Soda-DENGIKEN/Ritsumori-cup2026/others/スケジュール.pptx

スケジュール | 1月 | 2月 | 3月 | 4月 | 5月 | 6月
基板設計
機体設計
プログラム

データ作成

基板発注

調整

データ作成

組み立て

動作チェック

プログラム勉強

調整

プログラム作成

調整

## Slide 2

スケジュール | 1月 | 2月 | 3月 | 4月 | 5月 | 6月 | 7月 | 8月
基板設計
機体設計
プログラム

データ作成

基板発注

調整

データ作成

動作チェック

組み立て

プログラム勉強

調整

プログラム作成

調整

## Slide 3

スケジュール | 9月 | 10月 | 11月
基板設計
機体設計
プログラム

データ
作成

基板発注

調整

データ
作成

組み立て

動作チェック

プログラム
作成

調整

調整

## Slide 4

スケジュール | 11月 | 12月 | 1月
基板設計
機体設計
プログラム

データ作成

基板発注

調整

データ
作成

組み立て

動作チェック

プログラム作成

調整

調整
