Soda-DENGIKEN/Ritsumori-cup2026/Mechanical Design/others/rcj_mirror_d46mm_h49mm.csv

半征Emm) | 高さ(mm)
0 | 22
0.23 | 22.002 | 0.002
0.46 | 22.006 | 0.004
0.69 | 22.014 | 0.008
0.92 | 22.024 | 0.01
1.15 | 22.038 | 0.014
1.38 | 22.055 | 0.017
1.61 | 22.075 | 0.02
1.84 | 22.098 | 0.023
2.07 | 22.124 | 0.026
2.3 | 22.152 | 0.028
2.53 | 22.184 | 0.032
2.76 | 22.219 | 0.035
2.99 | 22.257 | 0.038
3.22 | 22.298 | 0.041
3.45 | 22.342 | 0.044
3.68 | 22.388 | 0.046
3.91 | 22.438 | 0.05
4.14 | 22.49 | 0.052
4.37 | 22.546 | 0.056
4.6 | 22.604 | 0.058
4.83 | 22.665 | 0.061
5.06 | 22.728 | 0.063
5.29 | 22.795 | 0.067
5.52 | 22.864 | 0.069
5.75 | 22.936 | 0.072
5.98 | 23.011 | 0.075
6.21 | 23.088 | 0.077
6.44 | 23.168 | 0.08
6.67 | 23.251 | 0.083
6.9 | 23.336 | 0.085
7.13 | 23.424 | 0.088
7.36 | 23.514 | 0.09
7.59 | 23.607 | 0.093
7.82 | 23.703 | 0.096
8.05 | 23.8 | 0.097
8.28 | 23.901 | 0.101
8.51 | 24.003 | 0.102
8.74 | 24.108 | 0.105
8.97 | 24.215 | 0.107
9.2 | 24.325 | 0.11
9.43 | 24.437 | 0.112
9.66 | 24.551 | 0.114
9.89 | 24.667 | 0.116
10.12 | 24.785 | 0.118
10.35 | 24.906 | 0.121
10.58 | 25.029 | 0.123
10.81 | 25.153 | 0.124
11.04 | 25.28 | 0.127
11.27 | 25.409 | 0.129
11.5 | 25.54 | 0.131
11.73 | 25.673 | 0.133
11.96 | 25.807 | 0.134
12.19 | 25.944 | 0.137
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
