Soda-DENGIKEN/Ritsumori-cup2026/others/写真/All_2026-Feb-05_08-16-54AM-000_CustomizedView10992556206.png

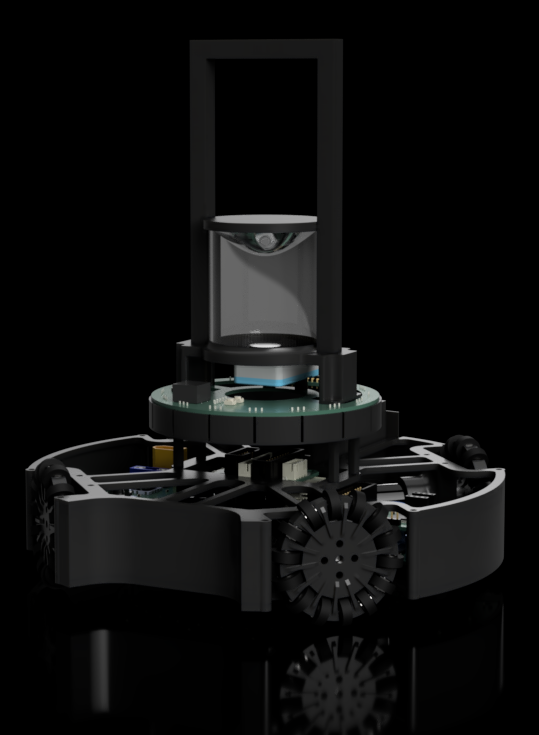
others/写真/All_2026-Feb-05_08-16-54AM-000_CustomizedView10992556206.png
