Soda-DENGIKEN/Ritsumori-cup2026/others/写真/スクリーンショット 2026-02-05 182419.png

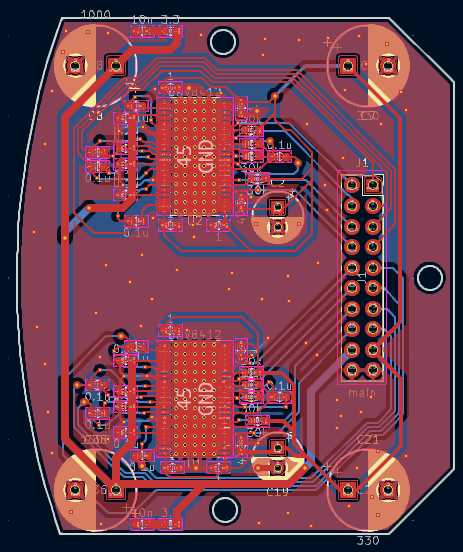
others/写真/スクリーンショット 2026-02-05 182419.png
