Soda-DENGIKEN/Ritsumori-cup2026/Substrate/Motor driver board_1.0/jlcpcb/production_files/BOM-Motor driver board_1.0.csv

Comment | Designator | Footprint | LCSC | Quantity
0.1u | C10,C11,C12,C13,C14,C15,C16,C21,C22,C23,C24,C25,C26,C27,C28,C29,C3,C30,C31,C32,C33,C34,C4,C5,C6,C7,C8,C9 | C_0603_1608Metric | C14663 | 28
1 | R10,R4 | R_0603_1608Metric | C22936 | 2
10k | R3,R9 | R_0603_1608Metric | C25804 | 2
10nF | C17,C35 | C_0603_1608Metric | C57112 | 2
3.3 | R12,R6 | R_0603_1608Metric | C22979 | 2
30k | R1,R11,R2,R5,R7,R8 | R_0603_1608Metric | C22984 | 6
DRV8412DDWR | IC1,IC2 | HTSSOP-44-1EP_6.1x14mm_P0.635mm_EP5.2x14mm_Mask4.31x8.26mm | C79852 | 2
