Soda-DENGIKEN/Ritsumori-cup2026/Mechanical Design/3mf file/Handle②.3mf

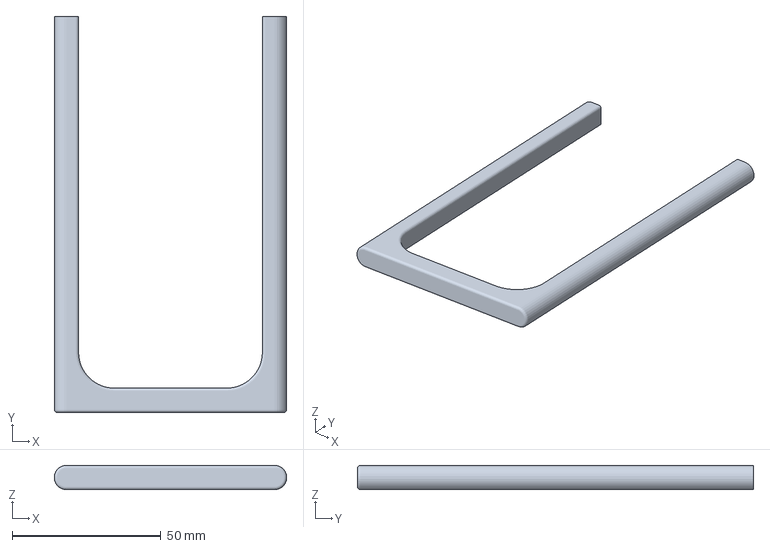
[picture p37: CAD file, 2026-06-11]
Mechanical Design/3mf file/Handle②.3mf
78.2 x 133.2 x 8.20 mm
