Soda-DENGIKEN/Ritsumori-cup2026/Mechanical Design/step file/maxon motor 110322_GP16A_0_15NM_2ST_SL.stp

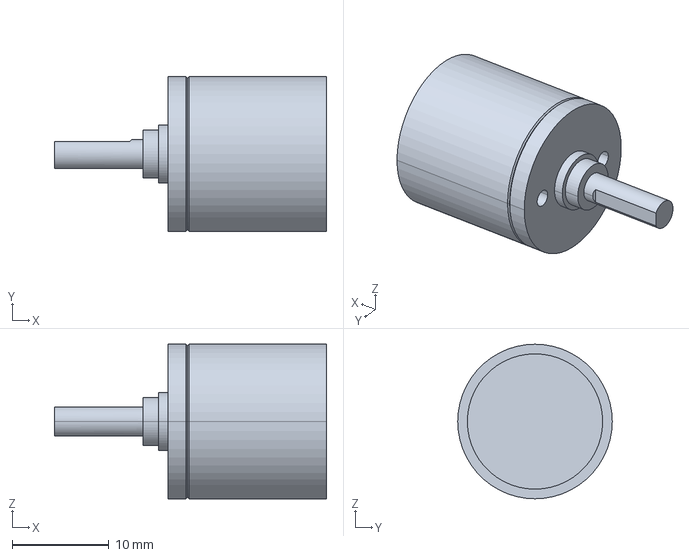
[picture p38: CAD file, 2026-04-30]
Mechanical Design/step file/maxon motor 110322_GP16A_0_15NM_2ST_SL.stp
28.1 x 16.0 x 16.0 mm
