Soda-DENGIKEN/Ritsumori-cup2026/Substrate/Angel_Line_1.0/Angel_Line.step

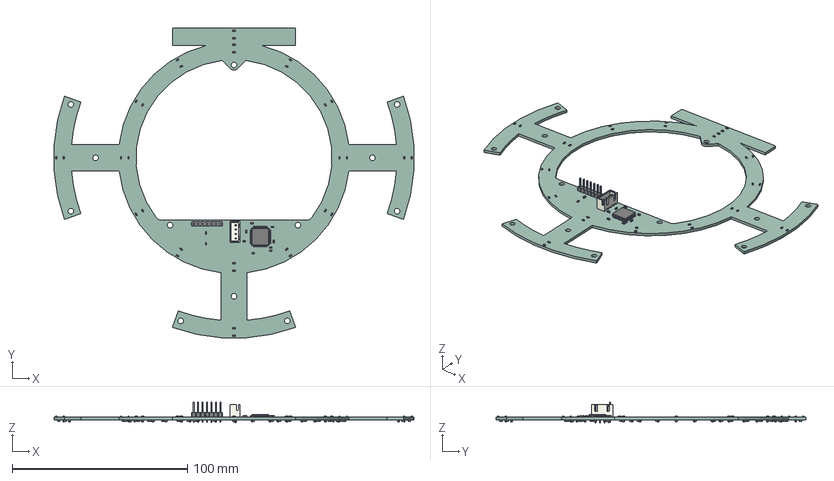
[picture p39: CAD file, 2026-04-30]
Substrate/Angel_Line_1.0/Angel_Line.step
205.5 x 176.7 x 11.9 mm
R_0603_1608Metric x 33
C_0603_1608Metric x 9
PinHeader_1x07_P254mm_Vertical
LQFP_64_10x10mm_P05mm
JST_B4B_XH_A
ASSEMBLY x 48
LED_0603_1608Metric x 48
Angel_Line_1.0_PCB
