Soda-DENGIKEN/Ritsumori-cup2026/Substrate/boost board_1.0/部品/LM2577S-ADJ_NOPB/LM2577S-ADJ_NOPB/3D/LM2577S-ADJ_NOPB.stp

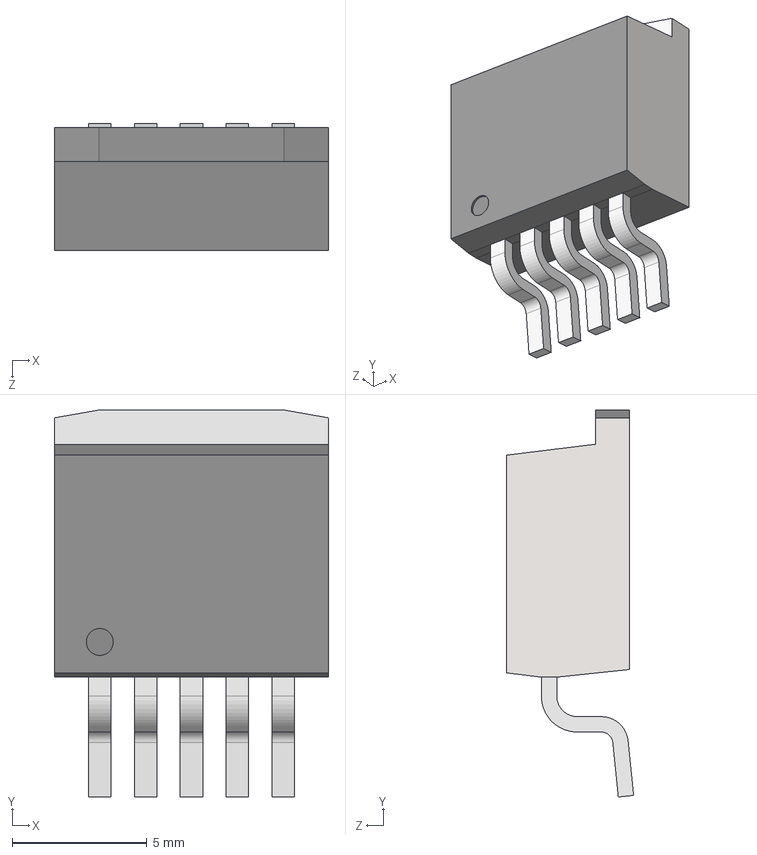
[picture p40: CAD file, 2026-04-27]
Substrate/boost board_1.0/部品/LM2577S-ADJ_NOPB/LM2577S-ADJ_NOPB/3D/LM2577S-ADJ_NOPB.stp
10.2 x 14.3 x 4.72 mm
