Soda-DENGIKEN/Ritsumori-cup2026/Substrate/boost board_1.0/部品/PVZ3A104C01R00/PVZ3A104C01R00/3D/PVZ3A104C01R00.stp

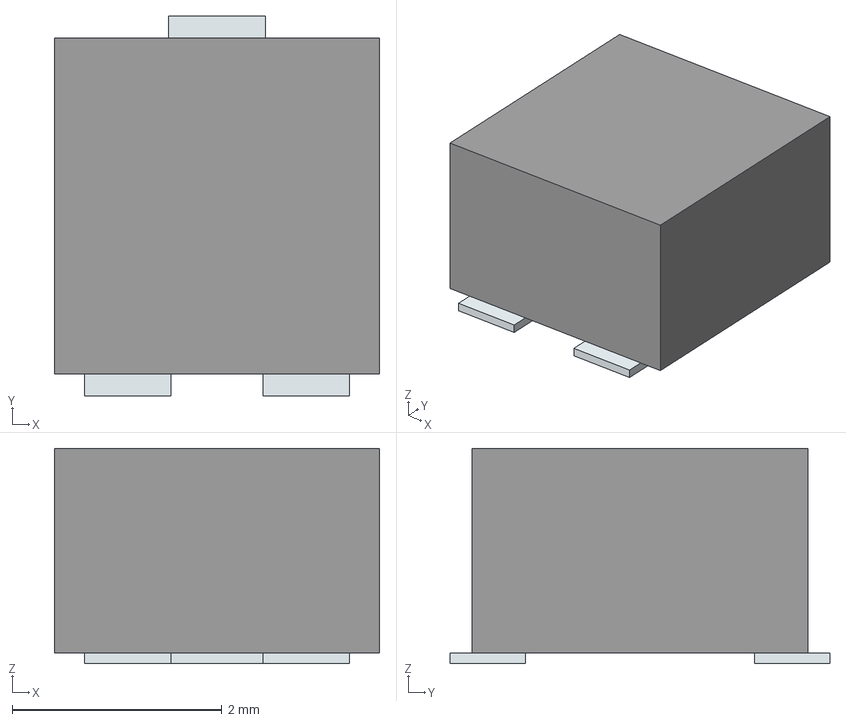
[picture p41: CAD file, 2026-04-27]
Substrate/boost board_1.0/部品/PVZ3A104C01R00/PVZ3A104C01R00/3D/PVZ3A104C01R00.stp
3.10 x 3.62 x 2.05 mm
Pins
