Soda-DENGIKEN/Ritsumori-cup2026/Substrate/IR board_1.0/IR board.step

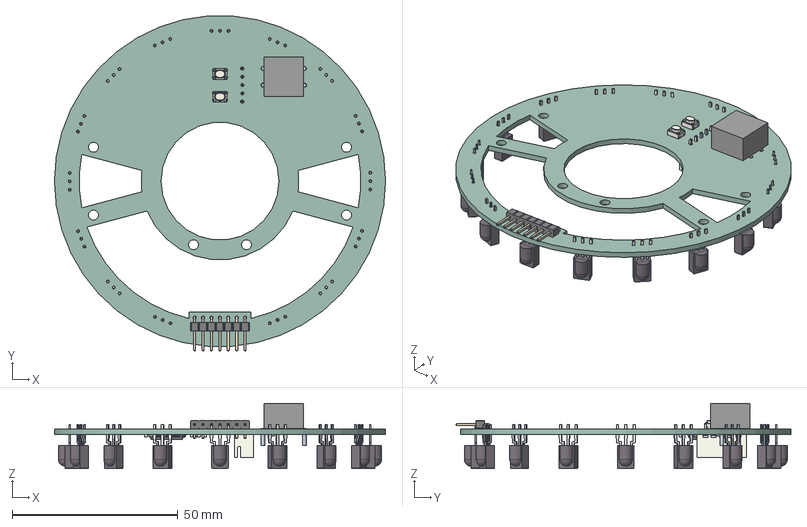
[picture p42: CAD file, 2026-04-30]
Substrate/IR board_1.0/IR board.step
100.0 x 101.2 x 19.8 mm
PinHeader_1x07_P254mm_Horizontal
SKRPAB x 2
ASSEMBLY
Vishay_MINICAST-3pin x 16
C_0603_1608Metric x 9
R_0603_1608Metric x 2
JST_B5B_XH_A
LQFP_64_10x10mm_P05mm
IR board_1.0_PCB
