Soda-DENGIKEN/Ritsumori-cup2026/Substrate/IR board_1.0/部品/SKRPABE010/SKRPABE010/3D/SKRPABE010.stp

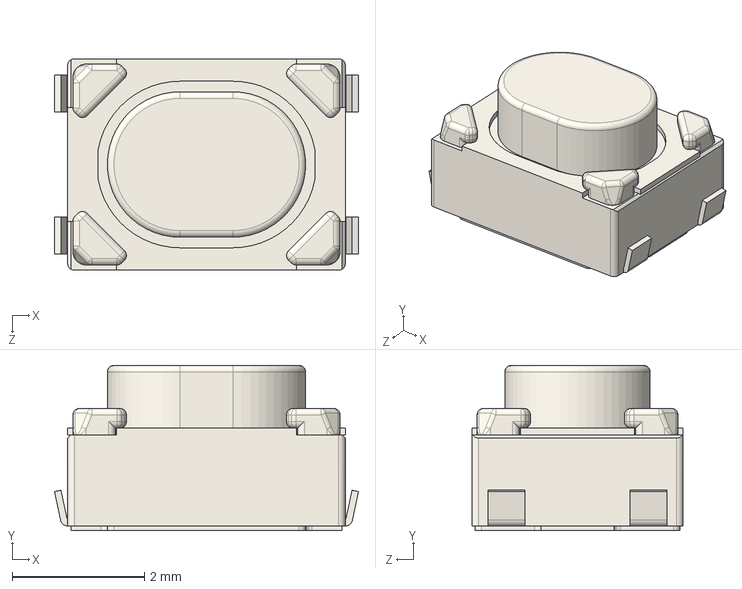
[picture p43: CAD file, 2026-04-30]
Substrate/IR board_1.0/部品/SKRPABE010/SKRPABE010/3D/SKRPABE010.stp
4.60 x 2.50 x 3.20 mm
