Soda-DENGIKEN/Ritsumori-cup2026/Substrate/kicker board_1.0/部品/AQW212/AQW212/3D/AQW212.stp

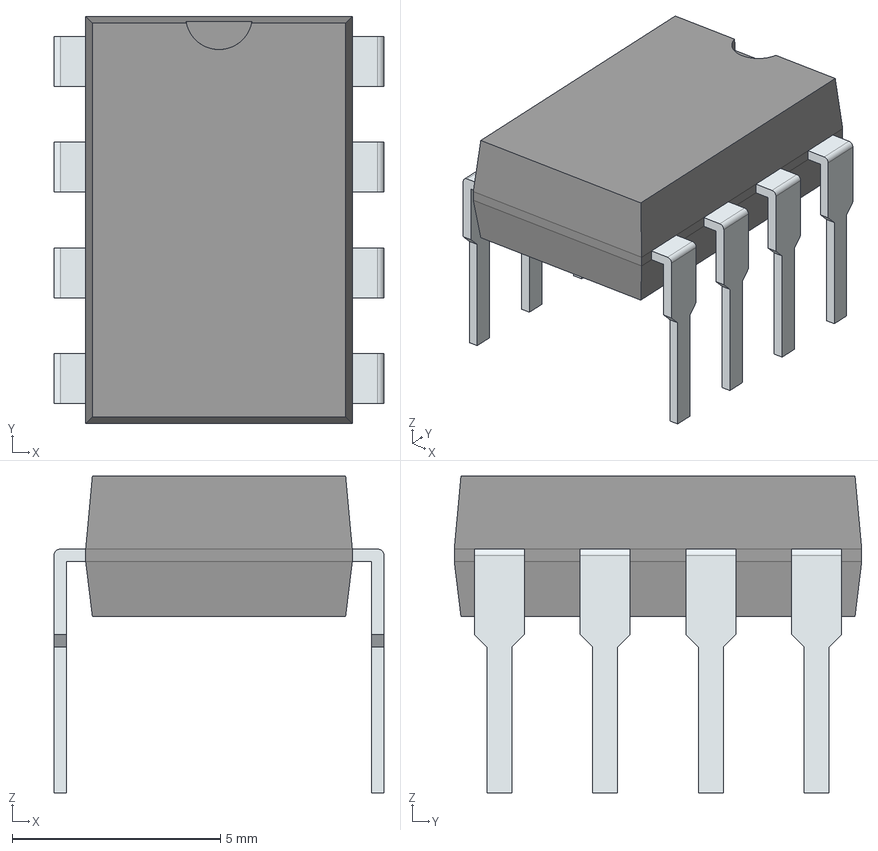
[picture p44: CAD file, 2026-04-27]
Substrate/kicker board_1.0/部品/AQW212/AQW212/3D/AQW212.stp
7.92 x 9.78 x 7.60 mm
PinsArrayLR
