Soda-DENGIKEN/Ritsumori-cup2026/Substrate/kicker board_1.0/部品/TJ8S06M3L/TJ8S06M3L/3D/TJ8S06M3L.stp

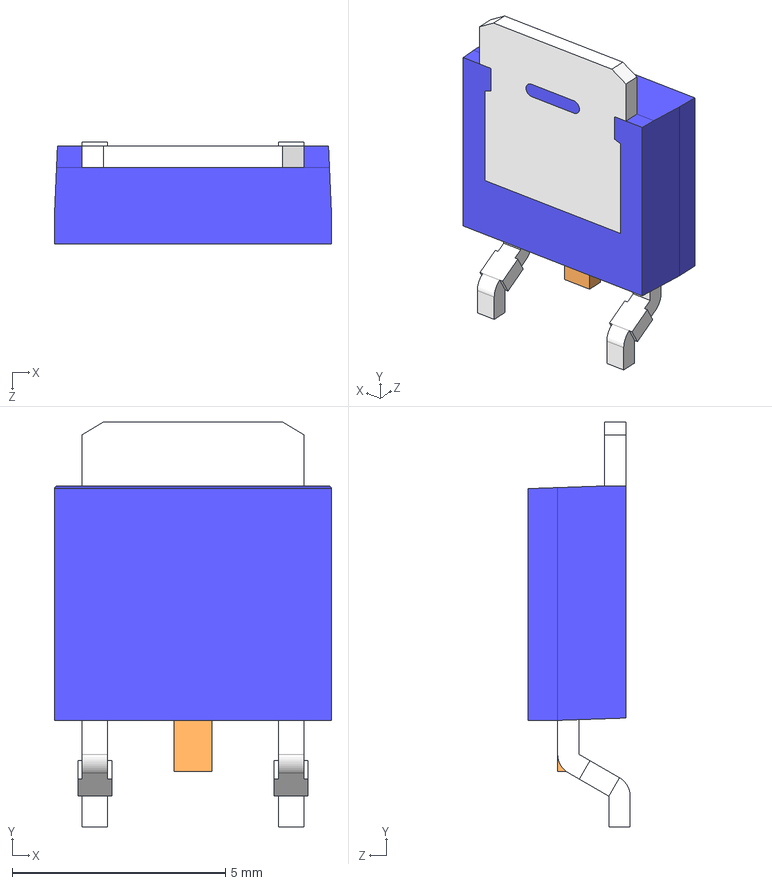
[picture p45: CAD file, 2026-04-27]
Substrate/kicker board_1.0/部品/TJ8S06M3L/TJ8S06M3L/3D/TJ8S06M3L.stp
6.50 x 9.50 x 2.40 mm
