Soda-DENGIKEN/Ritsumori-cup2026/Substrate/Motor driver board_1.0/Motor driver.dxf

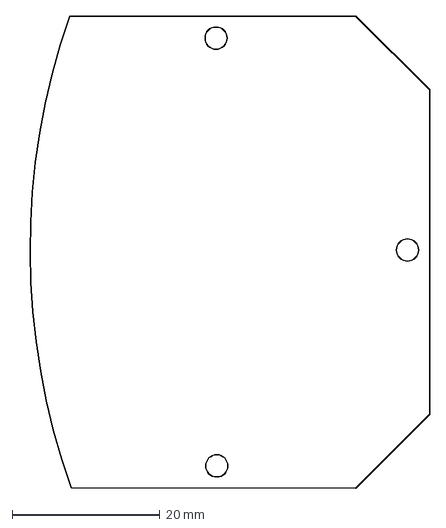
[picture p46: CAD file, 2026-04-30]
Substrate/Motor driver board_1.0/Motor driver.dxf
55.9 x 63.9 mm
