Soda-DENGIKEN/Ritsumori-cup2026/Substrate/Motor driver board_1.0/部品/DRV8432DKDR/DRV8432DKDR/3D/DRV8432DKDR.stp

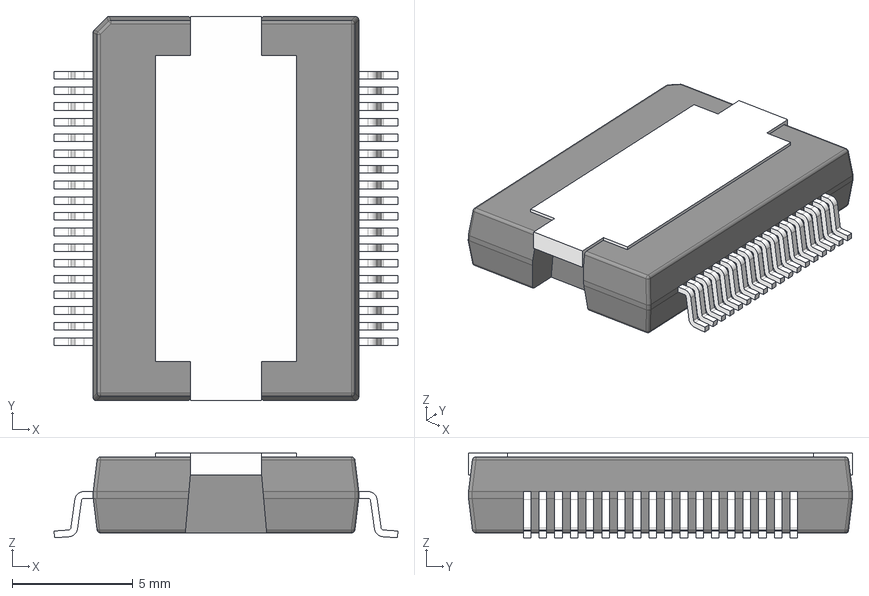
[picture p47: CAD file, 2026-04-30]
Substrate/Motor driver board_1.0/部品/DRV8432DKDR/DRV8432DKDR/3D/DRV8432DKDR.stp
14.2 x 15.9 x 3.50 mm
BODY-SO
LEAD-SO x 36
THERMALPAD-SO
PIN1-ID
