Soda-DENGIKEN/Ritsumori-cup2026/Substrate/power board_1.0/power board.step

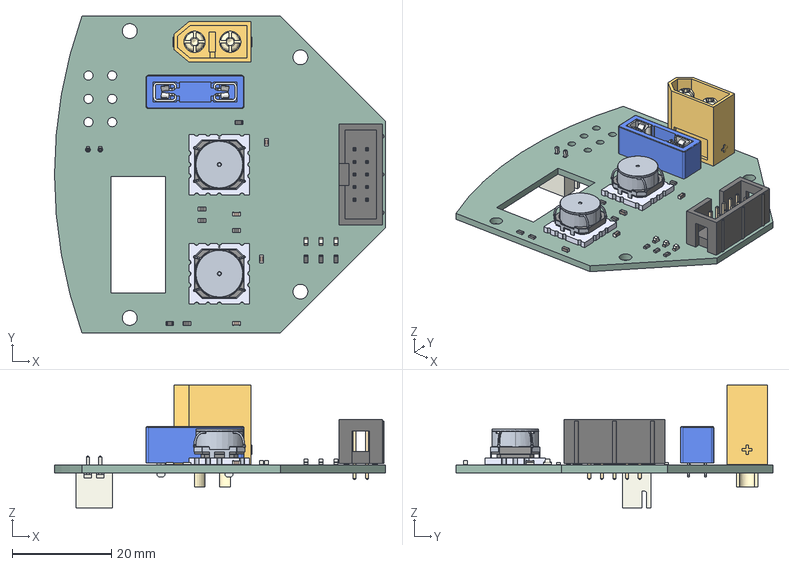
[picture p48: CAD file, 2026-04-27]
Substrate/power board_1.0/power board.step
66.7 x 63.9 x 24.7 mm
R_0603_1608Metric x 9
OKL-T-6-W12N-C x 2
C_0603_1608Metric x 4
LED_0603_1608Metric x 3
XT60 male v9
IDC_Header_2x05_P254mm_Vertical
JST_B2B_XH_A
power board_1.0_PCB
