Soda-DENGIKEN/Ritsumori-cup2026/Substrate/power board_1.0/部品/1N5822-23/1N5822-23/3D/1N5822-23.stp

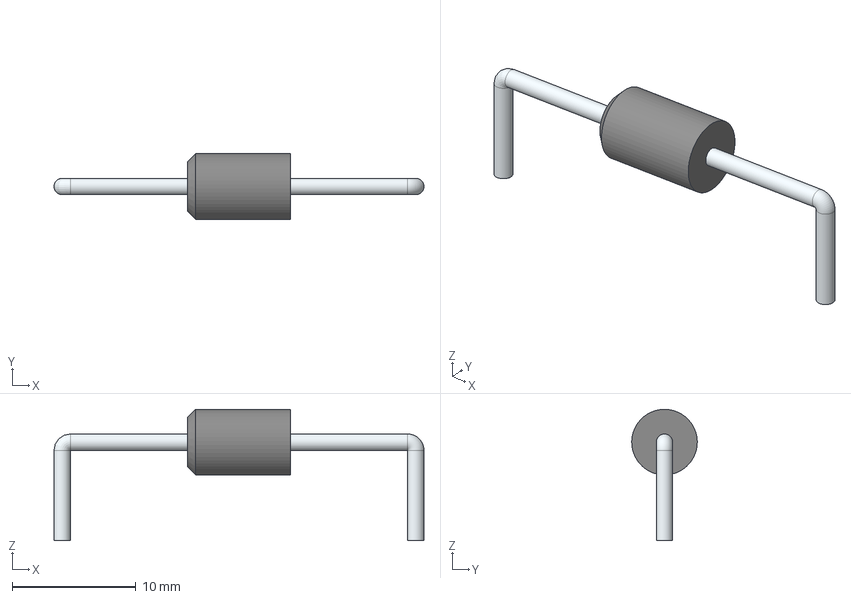
[picture p49: CAD file, 2026-04-27]
Substrate/power board_1.0/部品/1N5822-23/1N5822-23/3D/1N5822-23.stp
29.9 x 5.30 x 10.6 mm
