Soda-DENGIKEN/Ritsumori-cup2026/Substrate/sentral board_1.0/sentral board.step

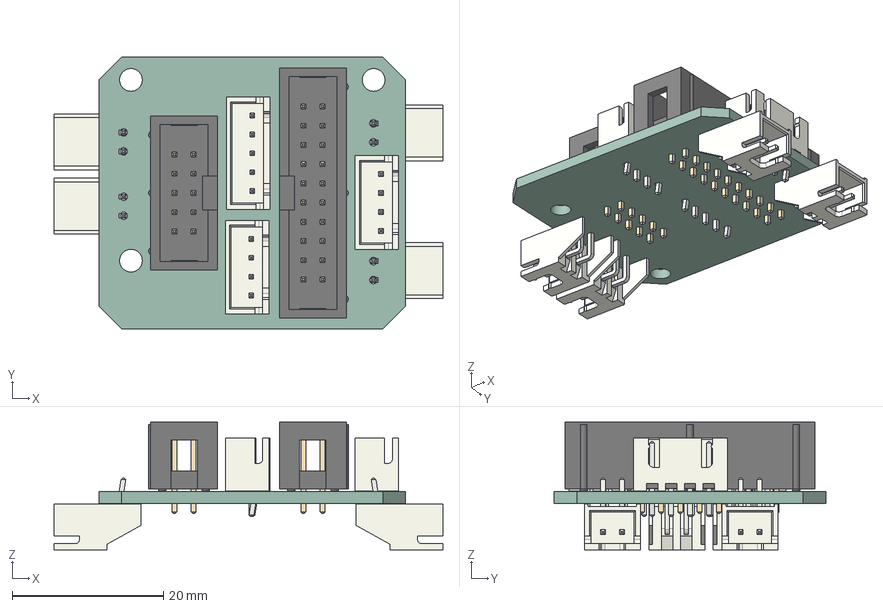
[picture p50: CAD file, 2026-04-27]
Substrate/sentral board_1.0/sentral board.step
51.4 x 35.9 x 16.9 mm
JST_B5B_XH_A
JST_B4B_XH_A x 2
IDC_Header_2x10_P254mm_Vertical
IDC_Header_2x05_P254mm_Vertical
JST_S2B_XH_A x 4
_autosave-sentral board_1.0_PCB
