Soda-DENGIKEN/Ritsumori-cup2026/Mechanical Design/3mf file/Mirror molding jig.3mf

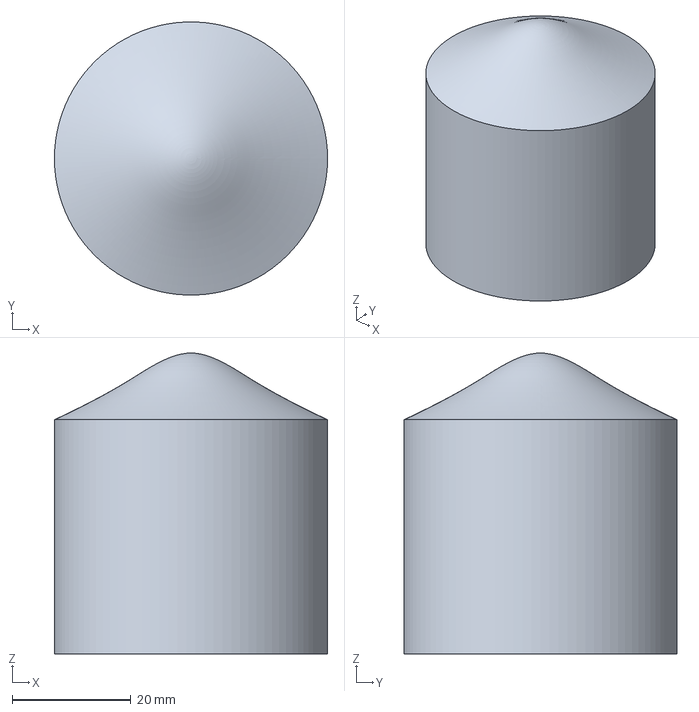
[picture p51: CAD file, 2026-06-07]
Mechanical Design/3mf file/Mirror molding jig.3mf
46.0 x 46.0 x 50.7 mm
