Soda-DENGIKEN/Ritsumori-cup2026/Mechanical Design/step file/maxon motor 118710_RE16_GB_4_5W_SL_1WE.stp

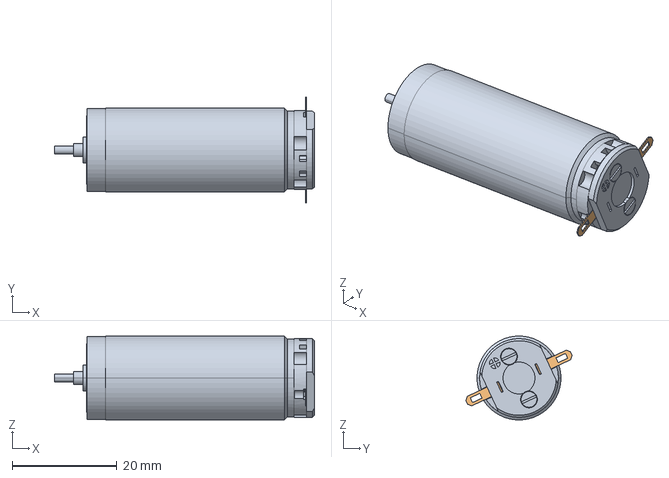
[picture p52: CAD file, 2026-04-30]
Mechanical Design/step file/maxon motor 118710_RE16_GB_4_5W_SL_1WE.stp
49.6 x 20.3 x 16.0 mm
