Soda-DENGIKEN/Ritsumori-cup2026/Mechanical Design/STL file/Subwheel jig②.stl

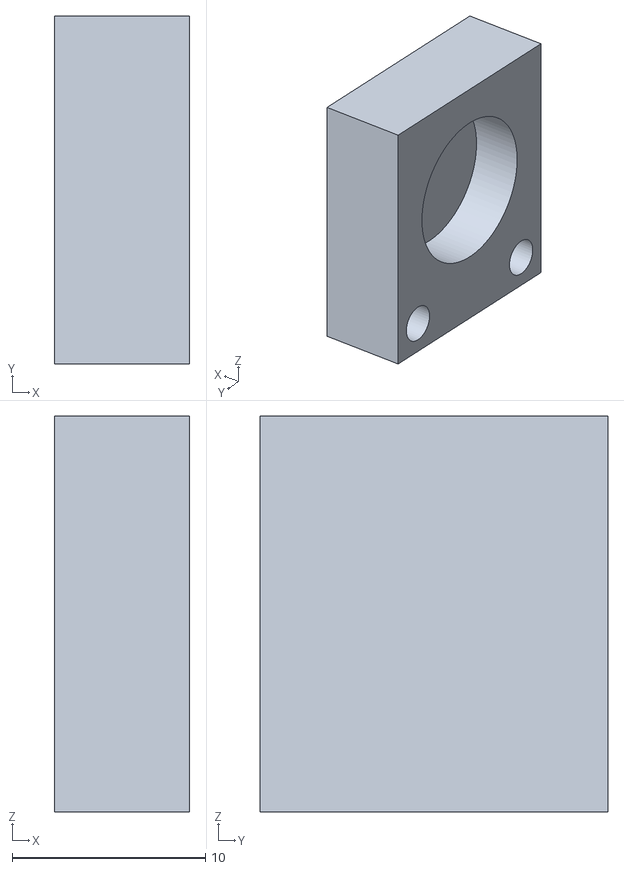
[picture p53: CAD file, 2026-05-09]
Mechanical Design/STL file/Subwheel jig②.stl
7.00 x 18.0 x 20.5
