Soda-DENGIKEN/Ritsumori-cup2026/Substrate/Motor driver board_1.0/Motor driver board_1.0.step

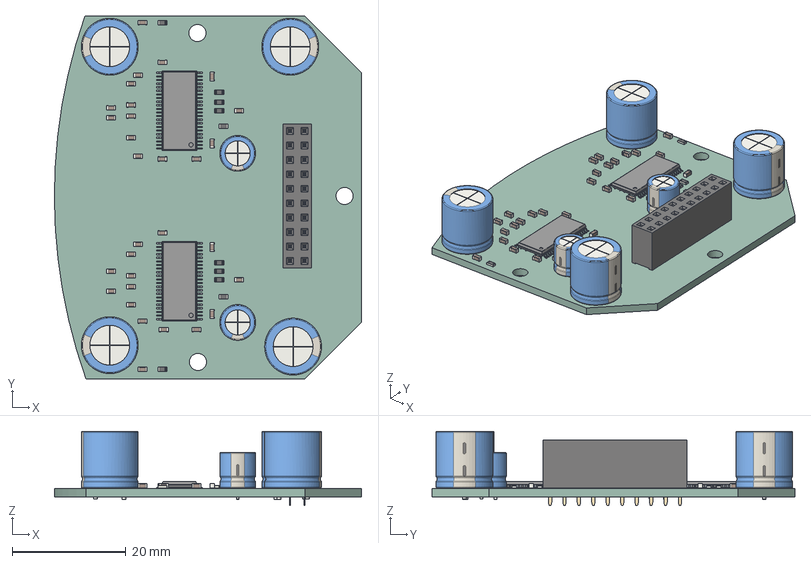
[picture p54: CAD file, 2026-04-30]
Substrate/Motor driver board_1.0/Motor driver board_1.0.step
54.1 x 63.9 x 13.1 mm
C_0603_1608Metric x 30
R_0603_1608Metric x 10
CP_Radial_D6.3mm_P2.50mm x 2
CP_Radial_D10.0mm_P5.00mm x 4
PinsArrayLR x 2
ThermalPad x 2
PinSocket_2x10_P2.54mm_Vertical
Motor driver board_1.0_PCB
