Soda-DENGIKEN/Ritsumori-cup2026/Mechanical Design/3mf file/Camera cover③.3mf

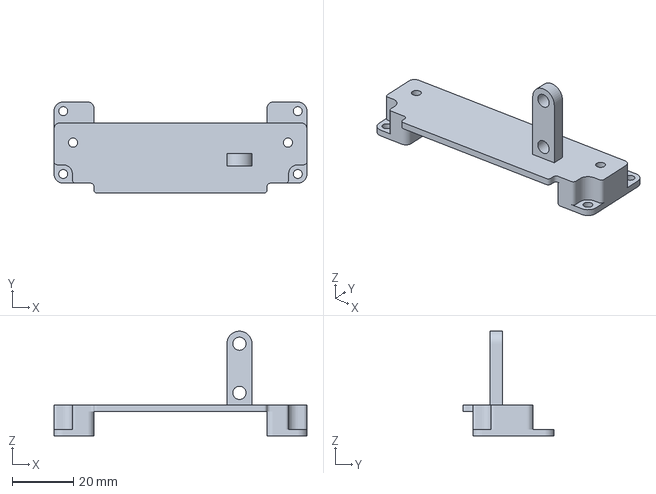
[picture p55: CAD file, 2026-06-07]
Mechanical Design/3mf file/Camera cover③.3mf
82.4 x 29.7 x 34.1 mm
