Soda-DENGIKEN/Ritsumori-cup2026/Mechanical Design/step file/UnitV AI camera m12 lens.step

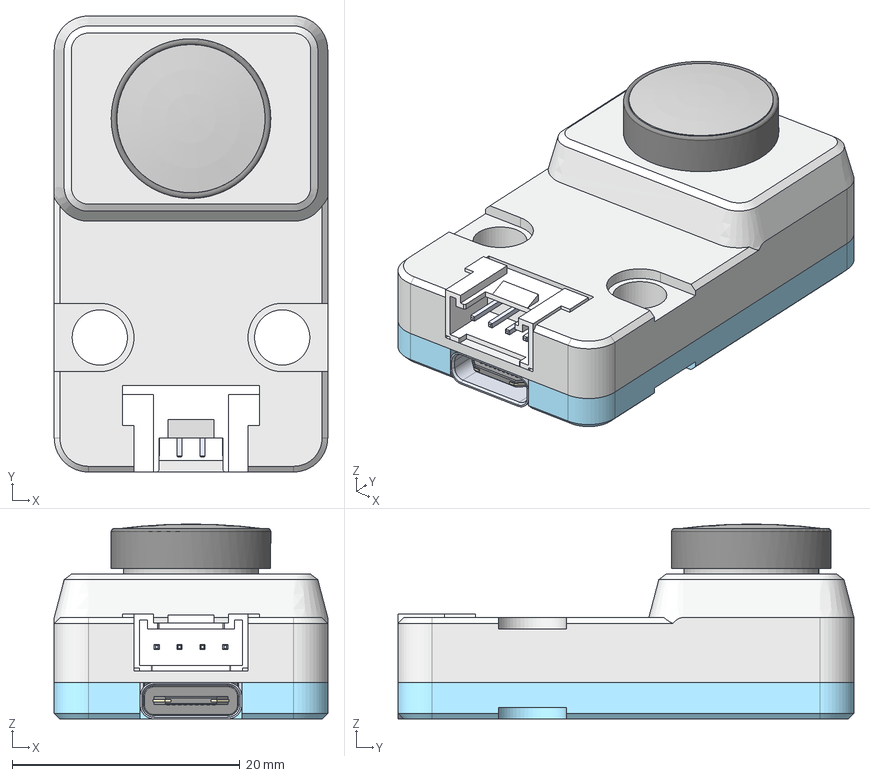
[picture p56: CAD file, 2026-04-30]
Mechanical Design/step file/UnitV AI camera m12 lens.step
24.0 x 40.0 x 17.1 mm
Grove Connector (flat)
197318B7-B3A4-4C4D-8547-E82B1B9616B6
UC-0204
