Soda-DENGIKEN/Ritsumori-cup2026/Mechanical Design/STL file/Subwheel jig①.stl

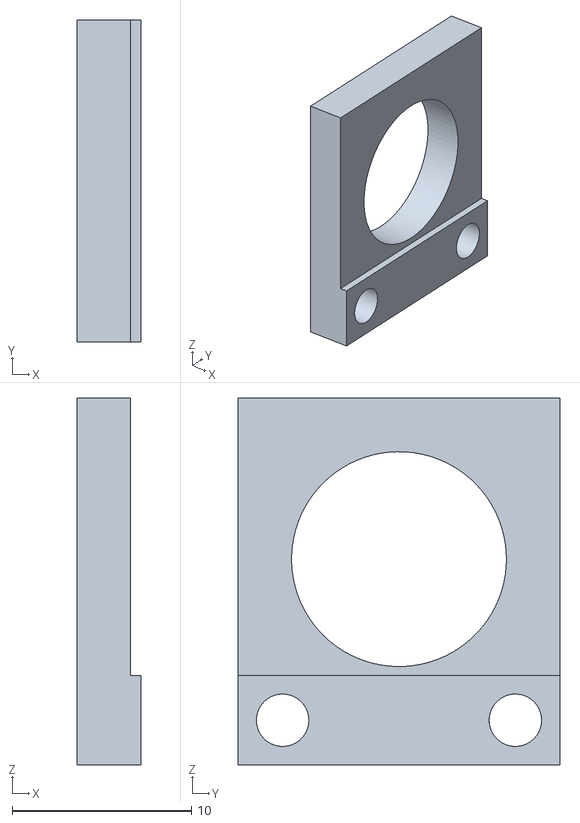
[picture p57: CAD file, 2026-05-09]
Mechanical Design/STL file/Subwheel jig①.stl
3.60 x 18.0 x 20.5
