Soda-DENGIKEN/Ritsumori-cup2026/Mechanical Design/3mf file/Camera cover①.3mf

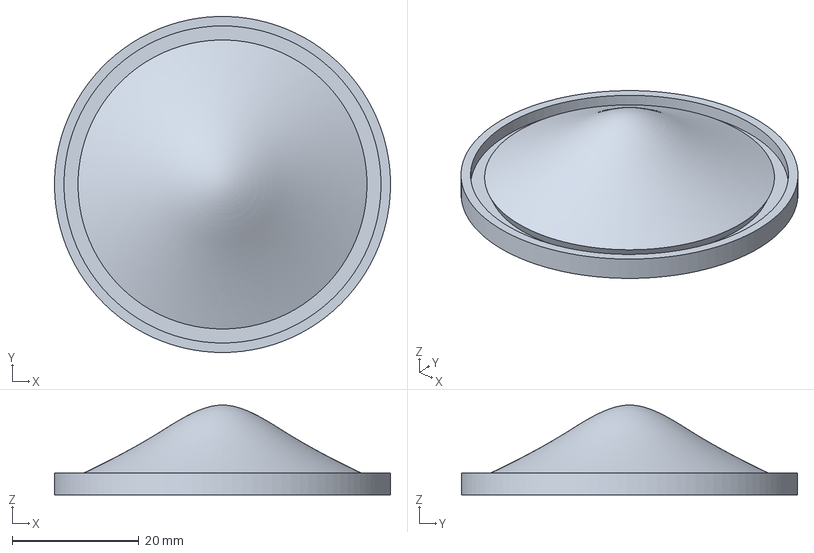
[picture p58: CAD file, 2026-06-07]
Mechanical Design/3mf file/Camera cover①.3mf
53.0 x 53.0 x 14.2 mm
