Soda-DENGIKEN/Ritsumori-cup2026/Mechanical Design/STL file/wall③.stl

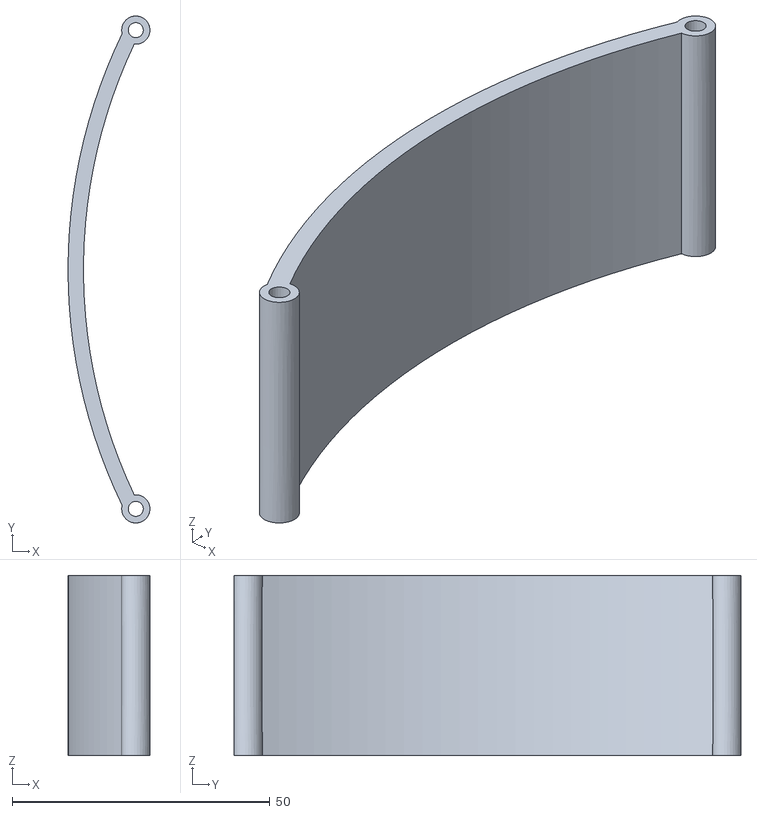
[picture p59: CAD file, 2026-04-30]
Mechanical Design/STL file/wall③.stl
15.9 x 98.4 x 35.0
