Soda-DENGIKEN/Ritsumori-cup2026/Mechanical Design/3mf file/Handle①.3mf

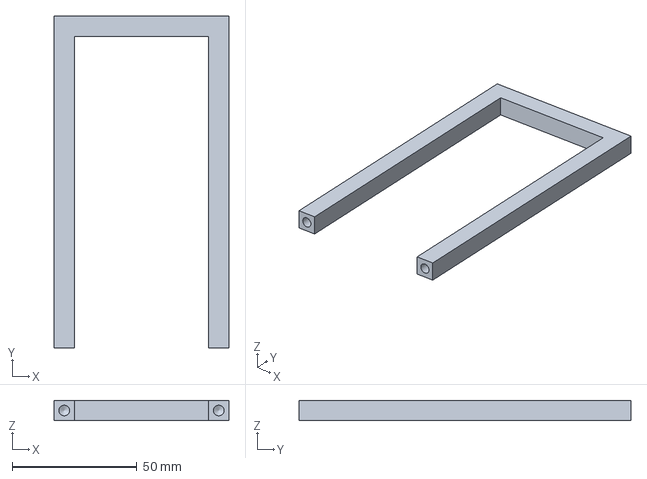
[picture p60: CAD file, 2026-06-07]
Mechanical Design/3mf file/Handle①.3mf
70.2 x 133.2 x 8.20 mm
