Soda-DENGIKEN/Ritsumori-cup2026/Mechanical Design/3mf file/Camera caver②.3mf

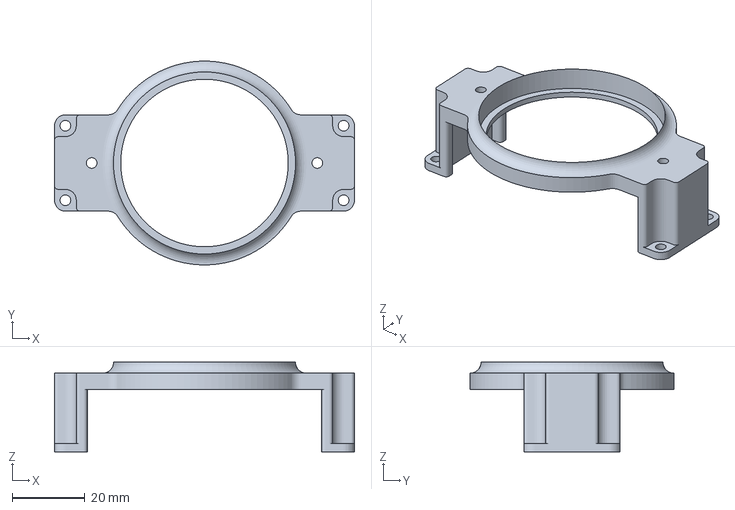
[picture p61: CAD file, 2026-05-31]
Mechanical Design/3mf file/Camera caver②.3mf
82.4 x 56.0 x 24.6 mm
