Soda-DENGIKEN/Ritsumori-cup2026/Mechanical Design/STL file/wall④.stl

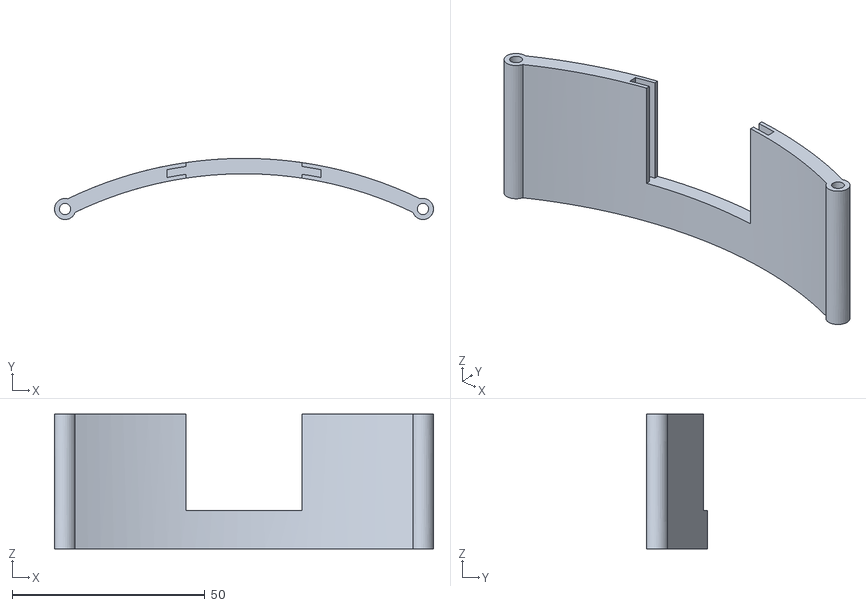
[picture p62: CAD file, 2026-04-30]
Mechanical Design/STL file/wall④.stl
98.4 x 15.9 x 35.0
