Soda-DENGIKEN/Ritsumori-cup2026/Mechanical Design/3mf file/omni frame.3mf

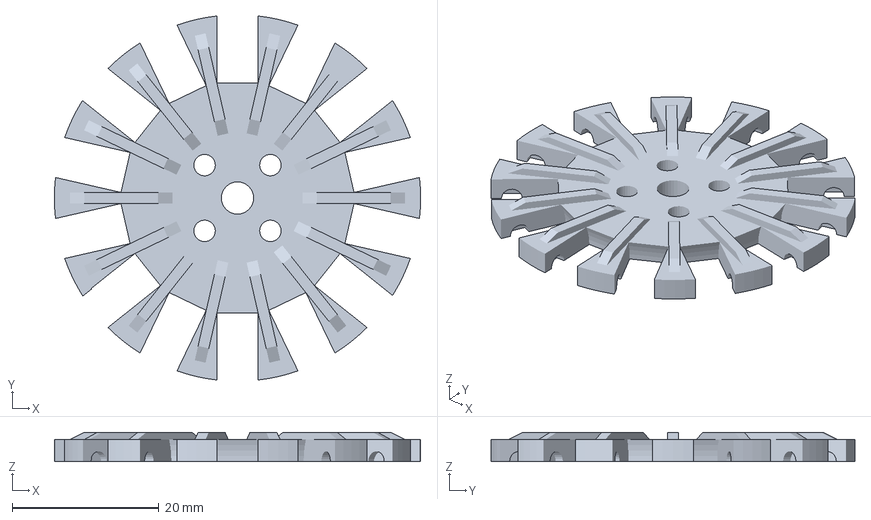
[picture p63: CAD file, 2026-05-26]
Mechanical Design/3mf file/omni frame.3mf
50.0 x 49.7 x 4.00 mm
