Soda-DENGIKEN/Ritsumori-cup2026/Mechanical Design/STL file/wall①.stl

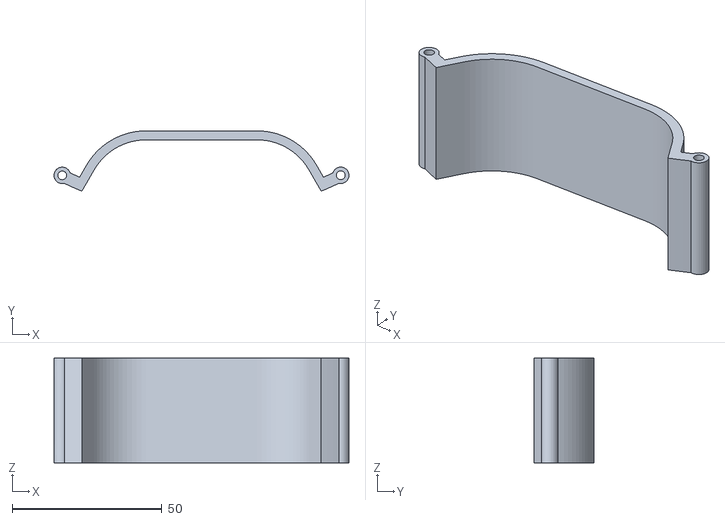
[picture p64: CAD file, 2026-04-30]
Mechanical Design/STL file/wall①.stl
98.3 x 20.1 x 35.0
