Soda-DENGIKEN/Ritsumori-cup2026/Mechanical Design/3mf file/omni frame 8.3mf

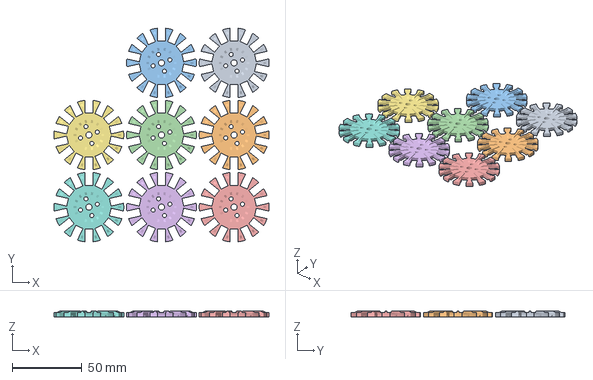
[picture p65: CAD file, 2026-05-26]
Mechanical Design/3mf file/omni frame 8.3mf
154.0 x 153.1 x 4.00 mm
omni frame.stl x 8
