Soda-DENGIKEN/Ritsumori-cup2026/Mechanical Design/3mf file/Subwheel jig.3mf

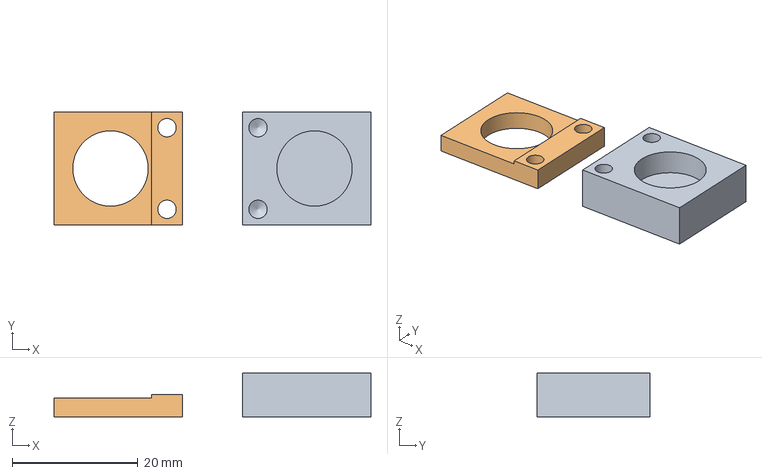
[picture p66: CAD file, 2026-05-09]
Mechanical Design/3mf file/Subwheel jig.3mf
50.5 x 18.0 x 7.00 mm
Subwheel jig②.stl
Subwheel jig①.stl
