Soda-DENGIKEN/Ritsumori-cup2026/Mechanical Design/3mf file/motor cover-Pololu×4.3mf

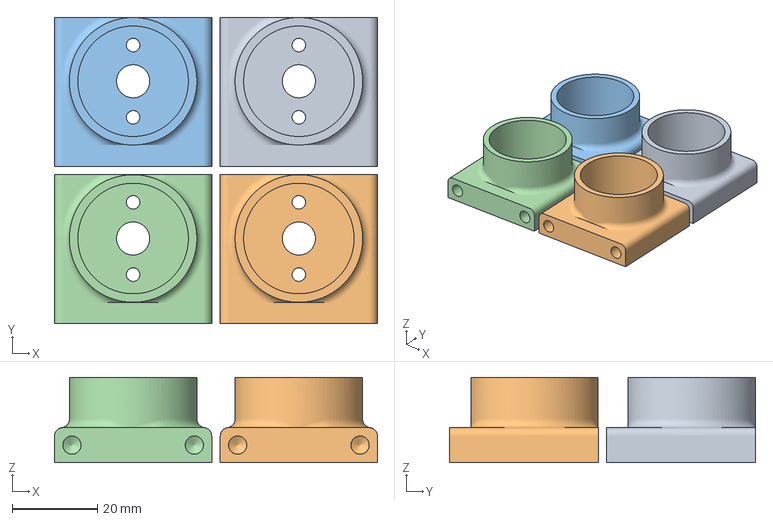
[picture p67: CAD file, 2026-04-30]
Mechanical Design/3mf file/motor cover-Pololu×4.3mf
76.0 x 72.0 x 20.0 mm
motor cover-Pololu.stl x 4
