Soda-DENGIKEN/Ritsumori-cup2026/Mechanical Design/3mf file/top board-Pololu.3mf

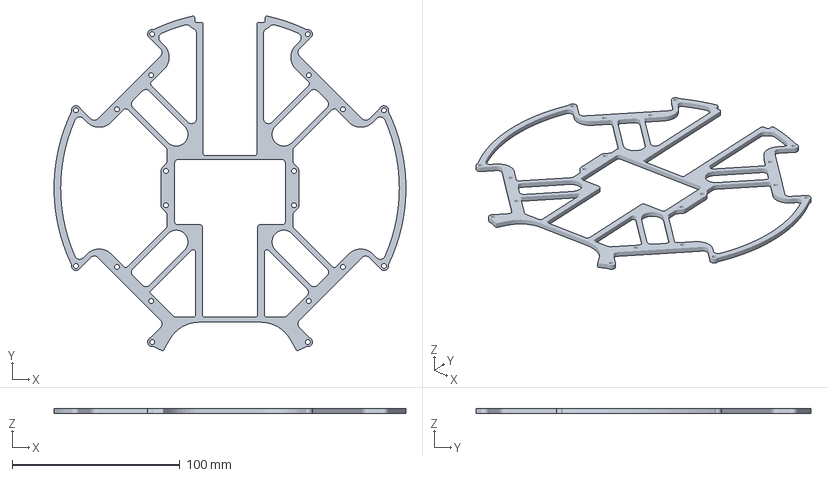
[picture p68: CAD file, 2026-04-30]
Mechanical Design/3mf file/top board-Pololu.3mf
210.0 x 199.8 x 3.00 mm
