Soda-DENGIKEN/Ritsumori-cup2026/Mechanical Design/3mf file/lower board-Pololu.3mf

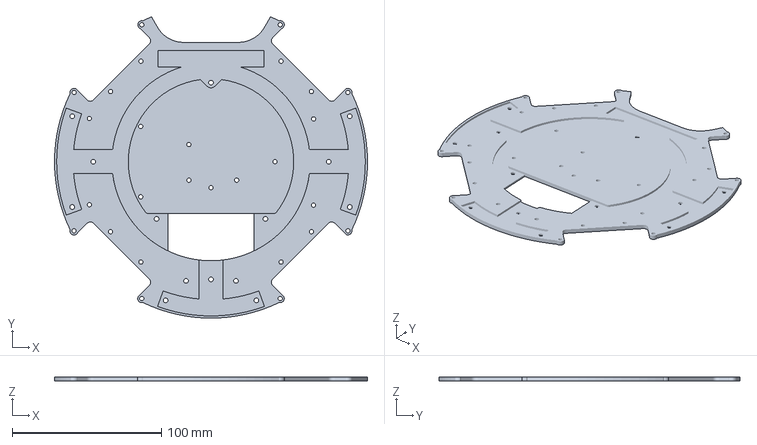
[picture p69: CAD file, 2026-04-30]
Mechanical Design/3mf file/lower board-Pololu.3mf
210.0 x 202.1 x 3.00 mm
