Soda-DENGIKEN/Ritsumori-cup2026/Mechanical Design/3mf file/battery cover.3mf

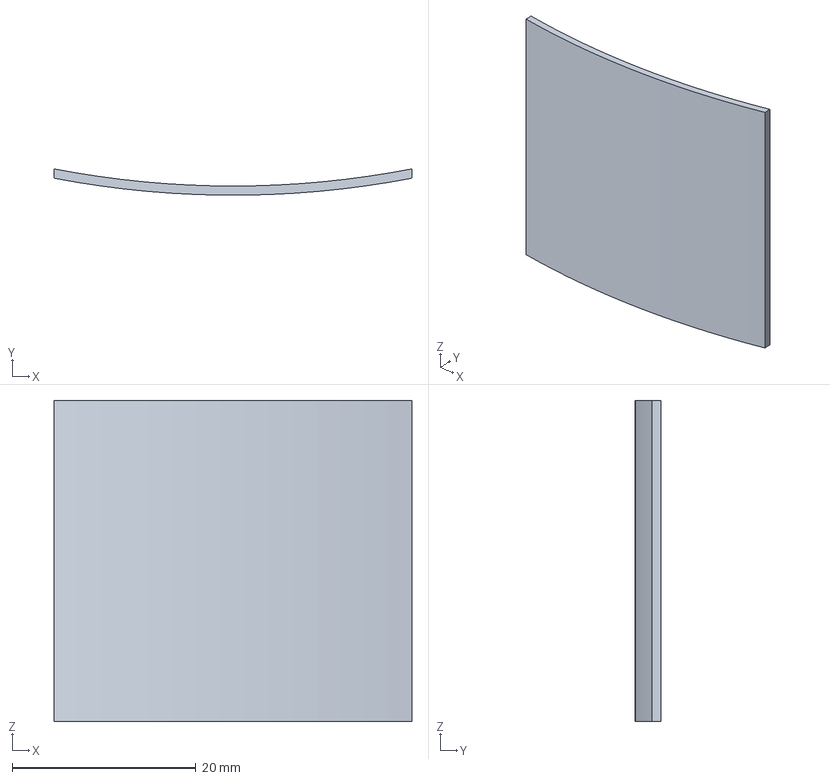
[picture p70: CAD file, 2026-04-30]
Mechanical Design/3mf file/battery cover.3mf
39.0 x 2.86 x 35.0 mm
