Soda-DENGIKEN/Ritsumori-cup2026/Mechanical Design/3mf file/wall.3mf

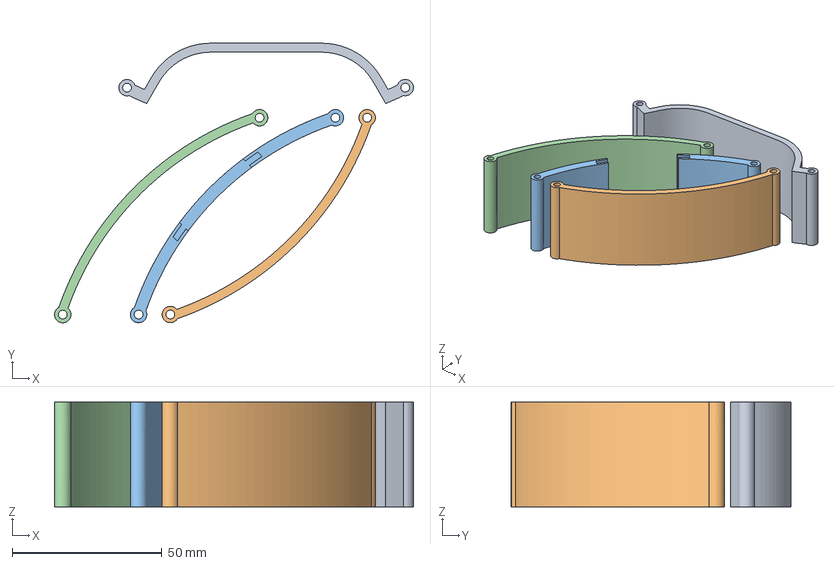
[picture p71: CAD file, 2026-04-30]
Mechanical Design/3mf file/wall.3mf
119.8 x 93.3 x 35.0 mm
wall①.stl
wall③.stl
wall④.stl
wall②.stl
