Soda-DENGIKEN/Ritsumori-cup2026/Mechanical Design/3mf file/IR cover.3mf

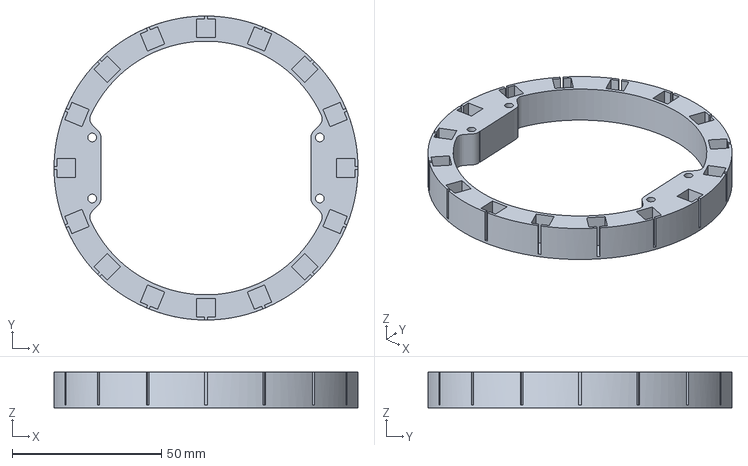
[picture p72: CAD file, 2026-04-30]
Mechanical Design/3mf file/IR cover.3mf
102.0 x 102.0 x 12.0 mm
