Soda-DENGIKEN/Ritsumori-cup2026/Mechanical Design/3mf file/motor cover-Pololu.3mf

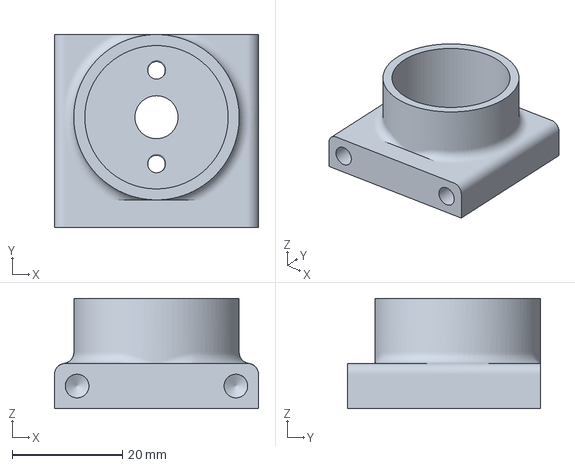
[picture p73: CAD file, 2026-04-30]
Mechanical Design/3mf file/motor cover-Pololu.3mf
37.0 x 35.0 x 20.0 mm
