Soda-DENGIKEN/Ritsumori-cup2026/Mechanical Design/3mf file/battery box-Pololu.3mf

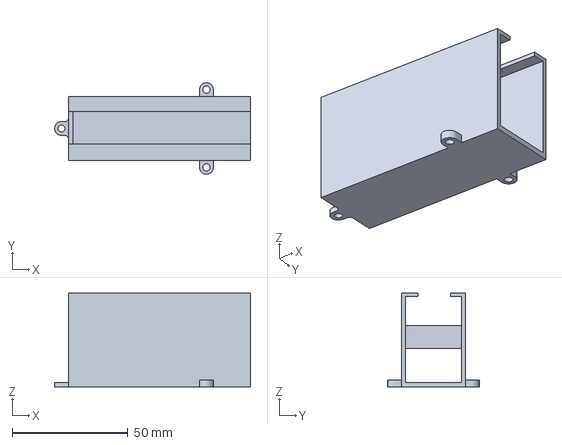
[picture p74: CAD file, 2026-04-30]
Mechanical Design/3mf file/battery box-Pololu.3mf
84.5 x 39.5 x 40.5 mm
