Soda-DENGIKEN/Ritsumori-cup2026/(list of files, cad)

Other CAD files:
Mechanical Design/STL file/wall②.stl
Mechanical Design/3mf file/washer 138.3mf
Mechanical Design/STL file/Camera caver②.stl
Mechanical Design/STL file/Camera cover①.stl
Mechanical Design/STL file/Camera cover③.stl
Mechanical Design/STL file/Handle①.stl
Mechanical Design/STL file/Handle②.stl
Mechanical Design/STL file/IR cover.stl
Mechanical Design/STL file/Mirror molding jig.stl
Mechanical Design/STL file/battery box-Pololu.stl
Mechanical Design/STL file/battery cover.stl
Mechanical Design/STL file/lower board-Pololu.stl
Mechanical Design/STL file/motor cover-Pololu.stl
Mechanical Design/STL file/omni frame.stl
Mechanical Design/STL file/top board-Pololu.stl
Mechanical Design/STL file/washer.stl
Substrate/Angel_Line_1.0/Angel_Line.dxf
Substrate/IR board_1.0/IR board.dxf
Substrate/IR board_1.0/部品/SKRPABE010/SKRPABE010/DEHDL/skrpabe010/chips/chips.prt
Substrate/Motor driver board_1.0/部品/DRV8432DKDR/DRV8432DKDR/Allegro/sop65p1420x360-37n.psm
Substrate/Motor driver board_1.0/部品/DRV8432DKDR/DRV8432DKDR/DEHDL/drv8432dkdr/chips/chips.prt
Substrate/boost board_1.0/部品/LM2577S-ADJ_NOPB/LM2577S-ADJ_NOPB/Allegro/ktt0005b.psm
Substrate/boost board_1.0/部品/LM2577S-ADJ_NOPB/LM2577S-ADJ_NOPB/DEHDL/lm2577s_adj_nopb/chips/chips.prt
Substrate/boost board_1.0/部品/PVZ3A104C01R00/PVZ3A104C01R00/Allegro/pvz3a104c01r00.psm
Substrate/boost board_1.0/部品/PVZ3A104C01R00/PVZ3A104C01R00/DEHDL/pvz3a104c01r00/chips/chips.prt
Substrate/kicker board_1.0/部品/AQW212/AQW212/Allegro/dip762w60p254l978h410q8n.psm
Substrate/kicker board_1.0/部品/AQW212/AQW212/DEHDL/aqw212/chips/chips.prt
Substrate/kicker board_1.0/部品/TJ8S06M3L/TJ8S06M3L/Allegro/tj8s06m3l.psm
Substrate/kicker board_1.0/部品/TJ8S06M3L/TJ8S06M3L/DEHDL/tj8s06m3l/chips/chips.prt
Substrate/power board_1.0/power board.dxf
Substrate/power board_1.0/部品/1N5822-23/1N5822-23/Allegro/dioad2855w132l835d505.psm
Substrate/power board_1.0/部品/1N5822-23/1N5822-23/DEHDL/1n5822_23/chips/chips.prt
Substrate/power board_1.0/部品/LIB_LM2576SX-3.3_NOPB/LM2576SX-3.3_NOPB/Allegro/ktt0005b.psm
Substrate/power board_1.0/部品/LIB_LM2576SX-3.3_NOPB/LM2576SX-3.3_NOPB/DEHDL/lm2576sx_3.3_nopb/chips/chips.prt
Substrate/power board_1.0/部品/LIB_LM2576SX-5.0_NOPB/LM2576SX-5.0_NOPB/Allegro/ktt0005b.psm
Substrate/power board_1.0/部品/LIB_LM2576SX-5.0_NOPB/LM2576SX-5.0_NOPB/DEHDL/lm2576sx_5.0_nopb/chips/chips.prt
Substrate/sentral board_1.0/sentral board.dxf
