Soda-DENGIKEN/Ritsumori-cup2026/Substrate/Motor driver board_1.0/Motor driver board_1.0.pdf

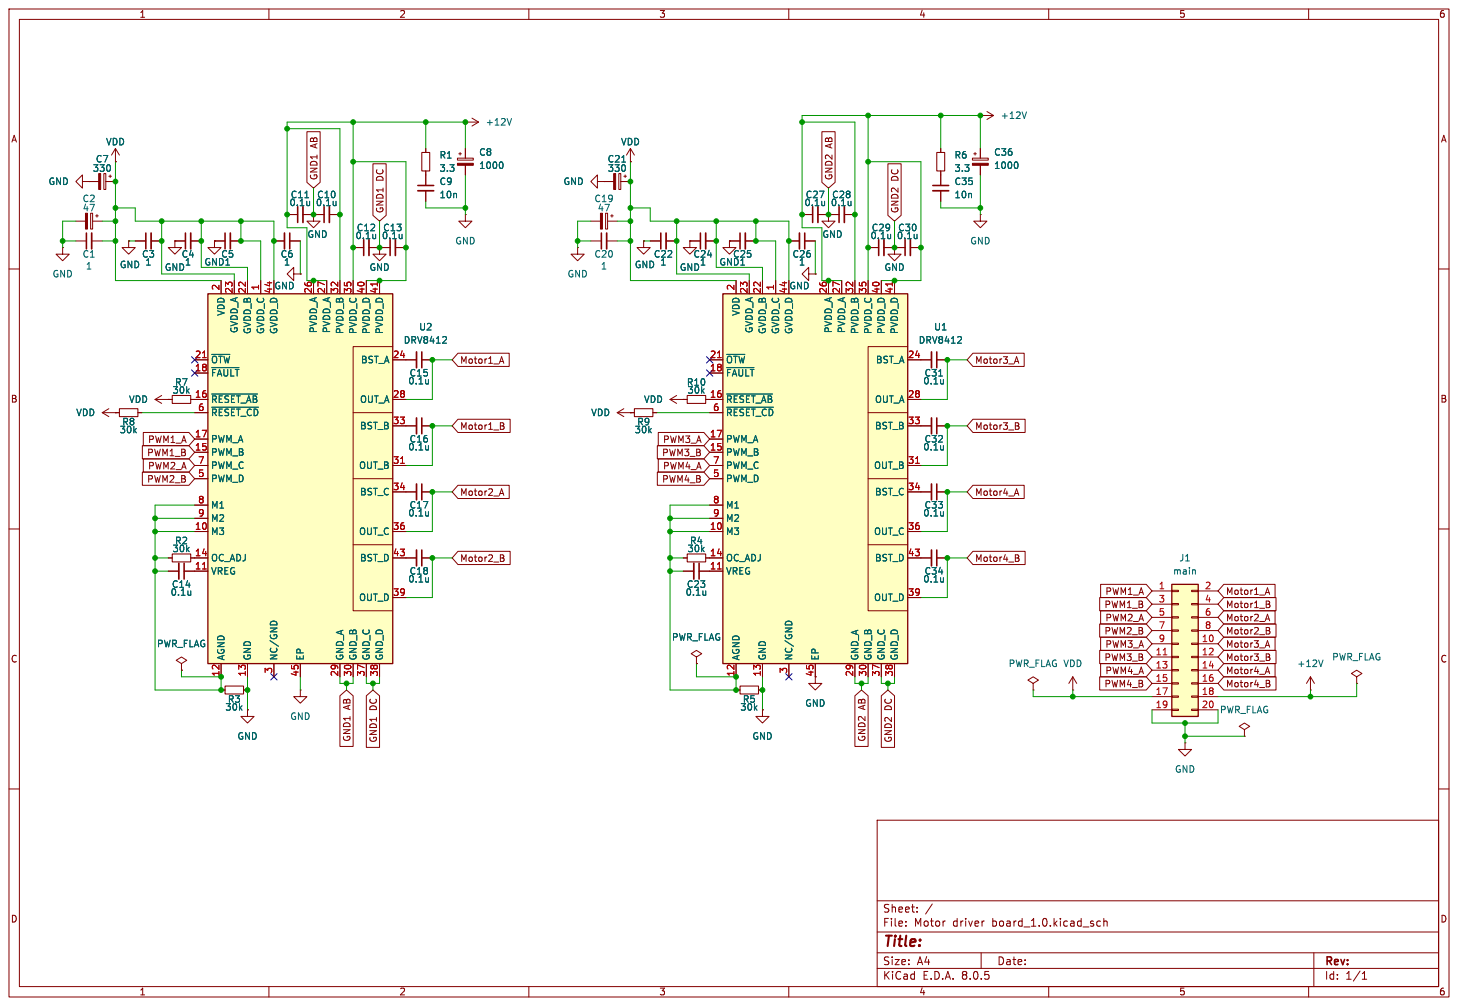
[picture p75: page 1]

1 M3 10 VREG 11 AGND 12 GND 13 OC_ADJ 14 PWM_B 15 ~{RESET_AB} 16 PWM_A 17 ~{FAULT} 18 VDD
