Soda-DENGIKEN/Ritsumori-cup2026/others/2026リツモリカップ予算表 v3.pdf

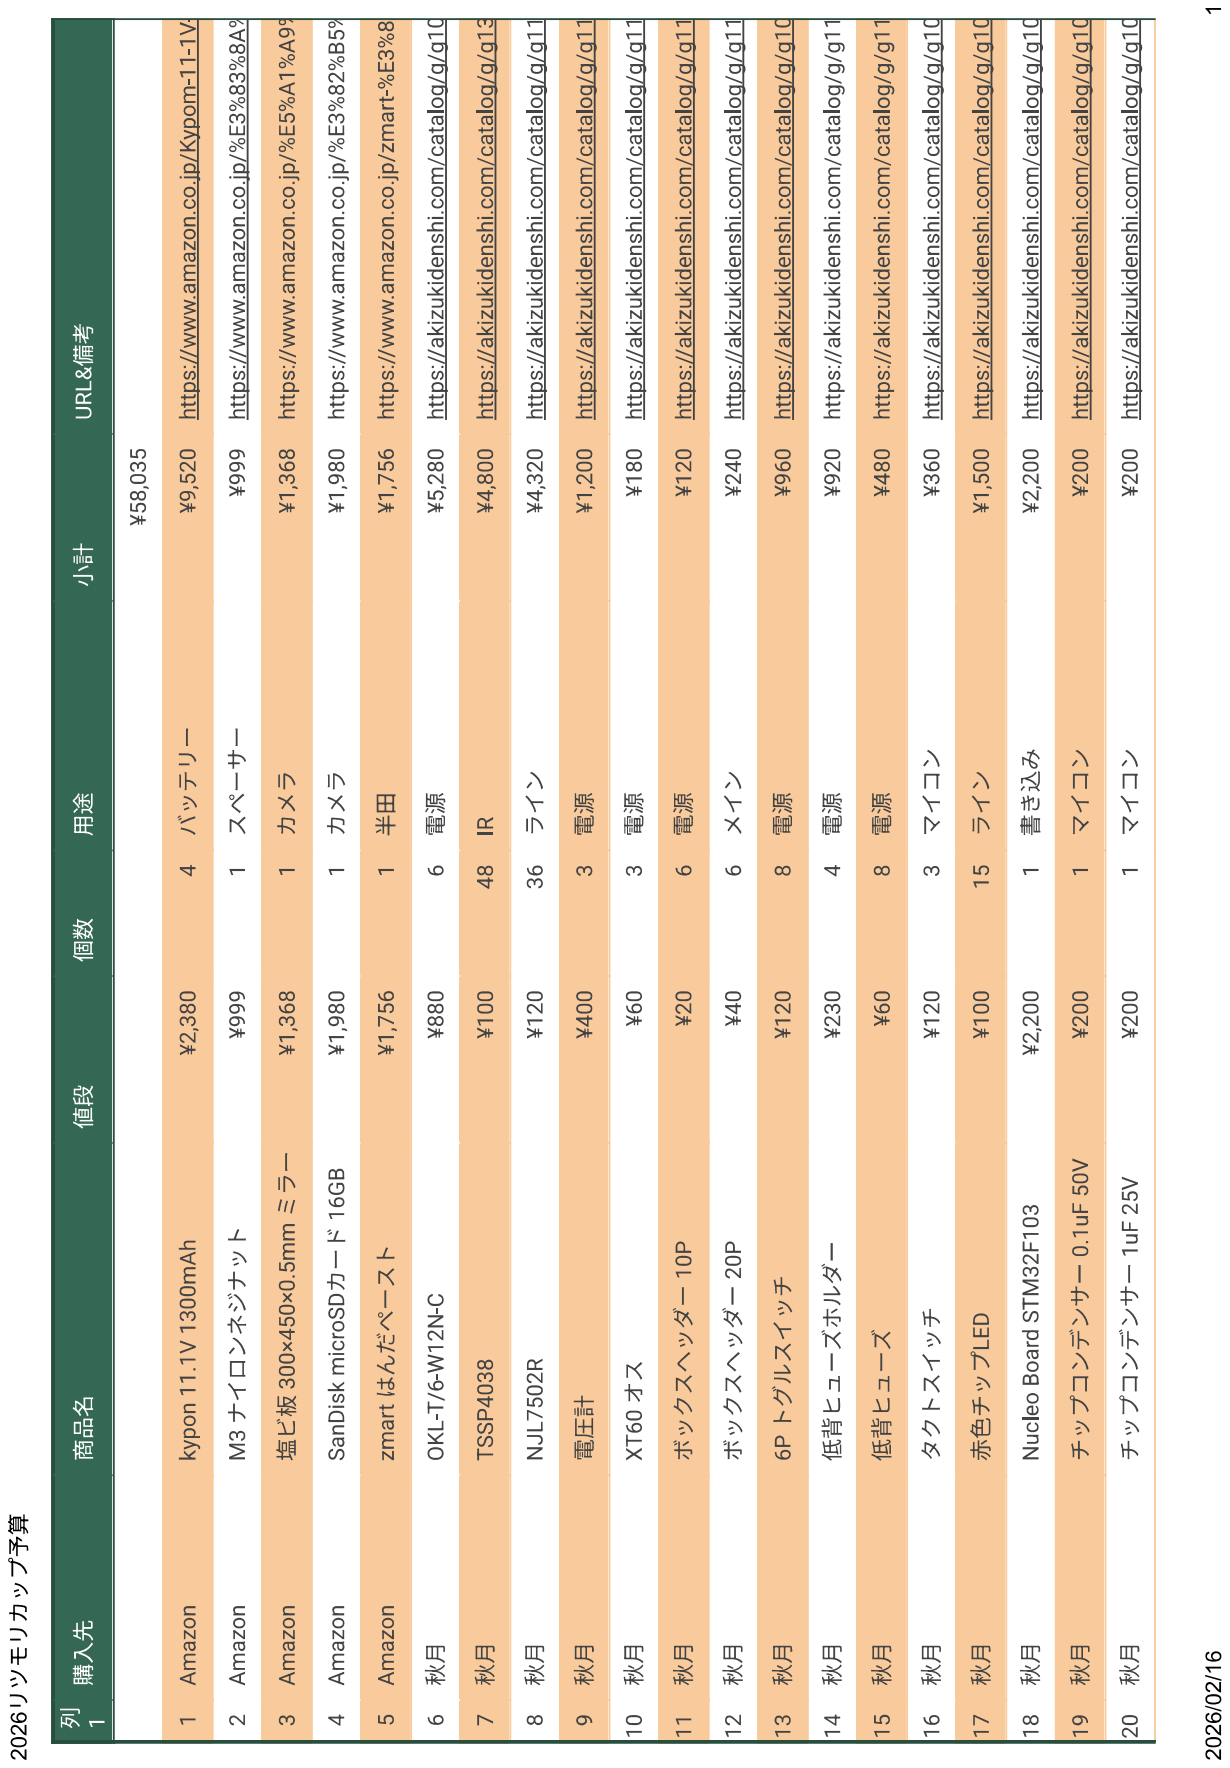
[picture p76: page 1]

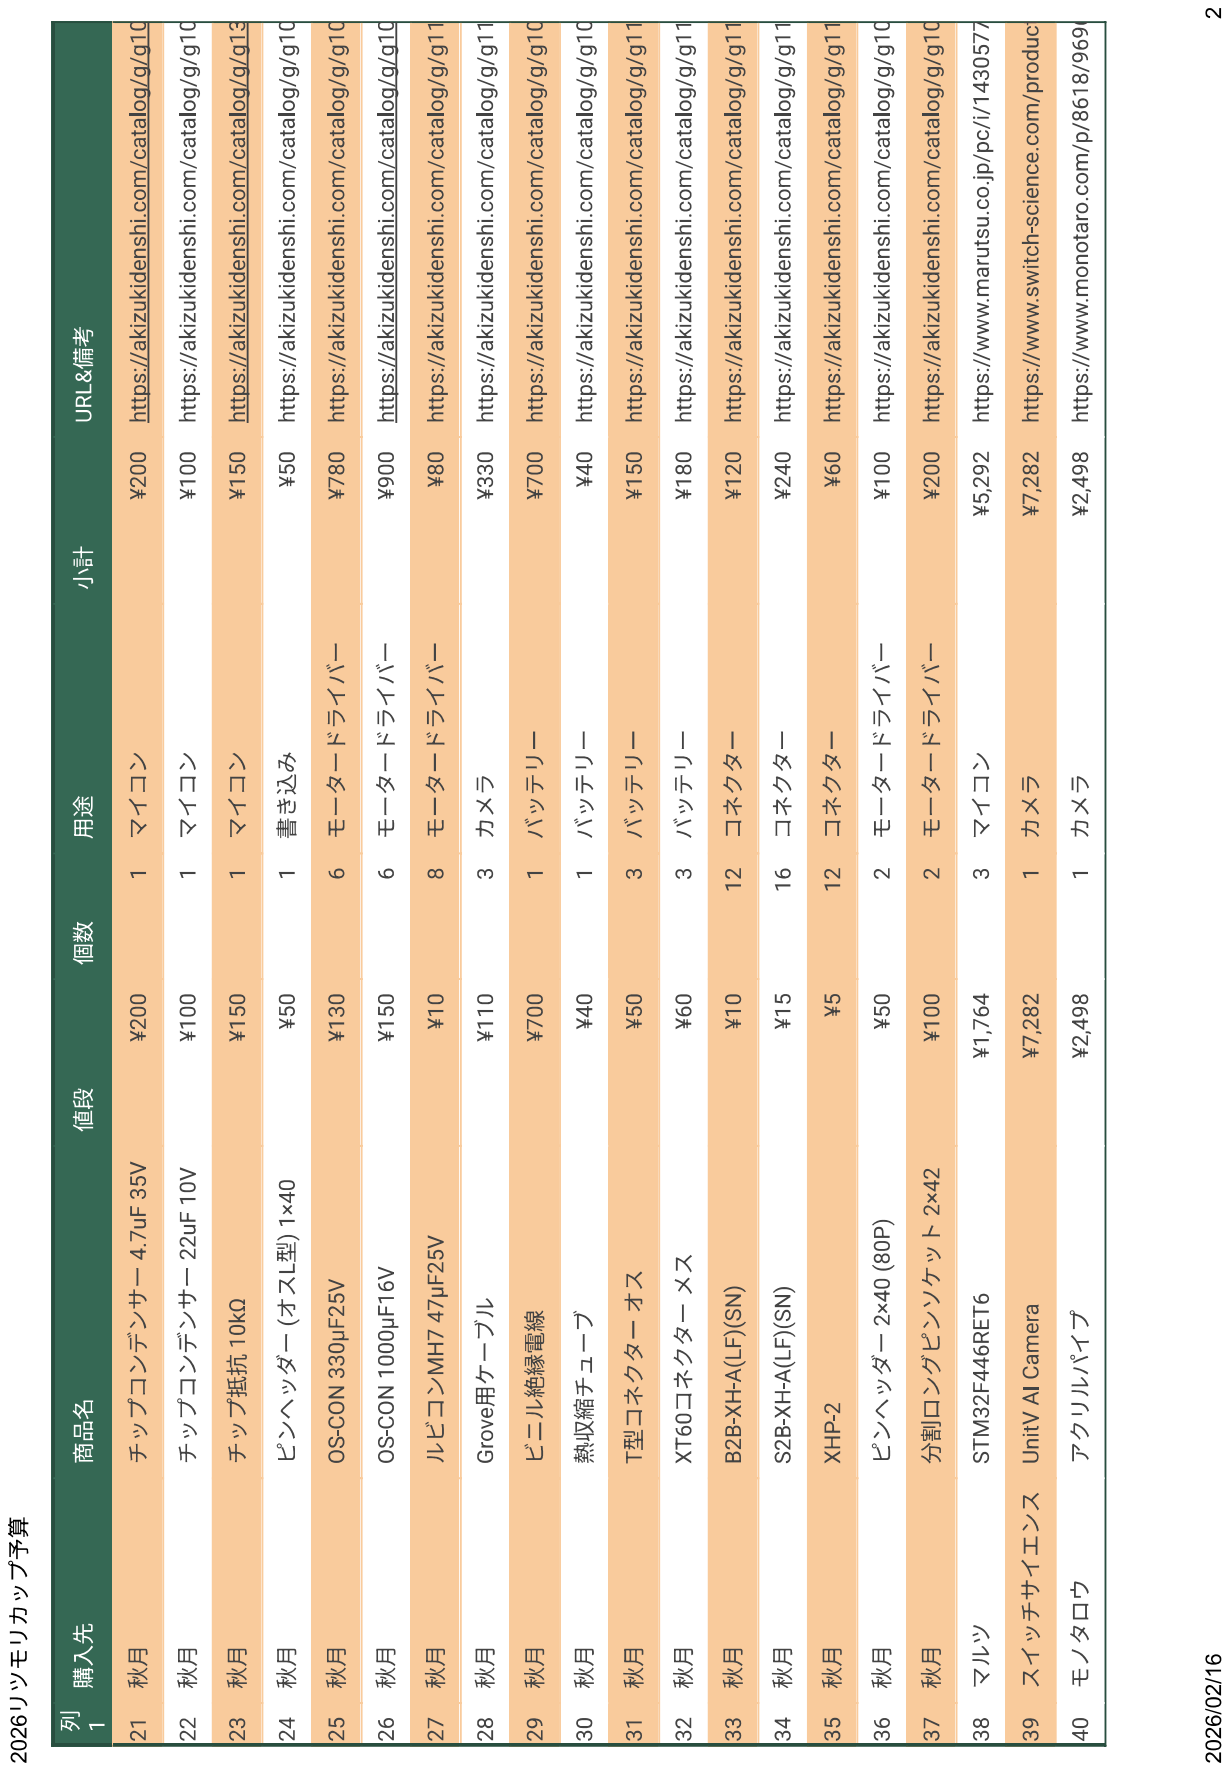
[picture p77: page 2]
