Soda-DENGIKEN/Ritsumori-cup2026/Substrate/Angel_Line_1.0/Angel_Line_1.0.pdf

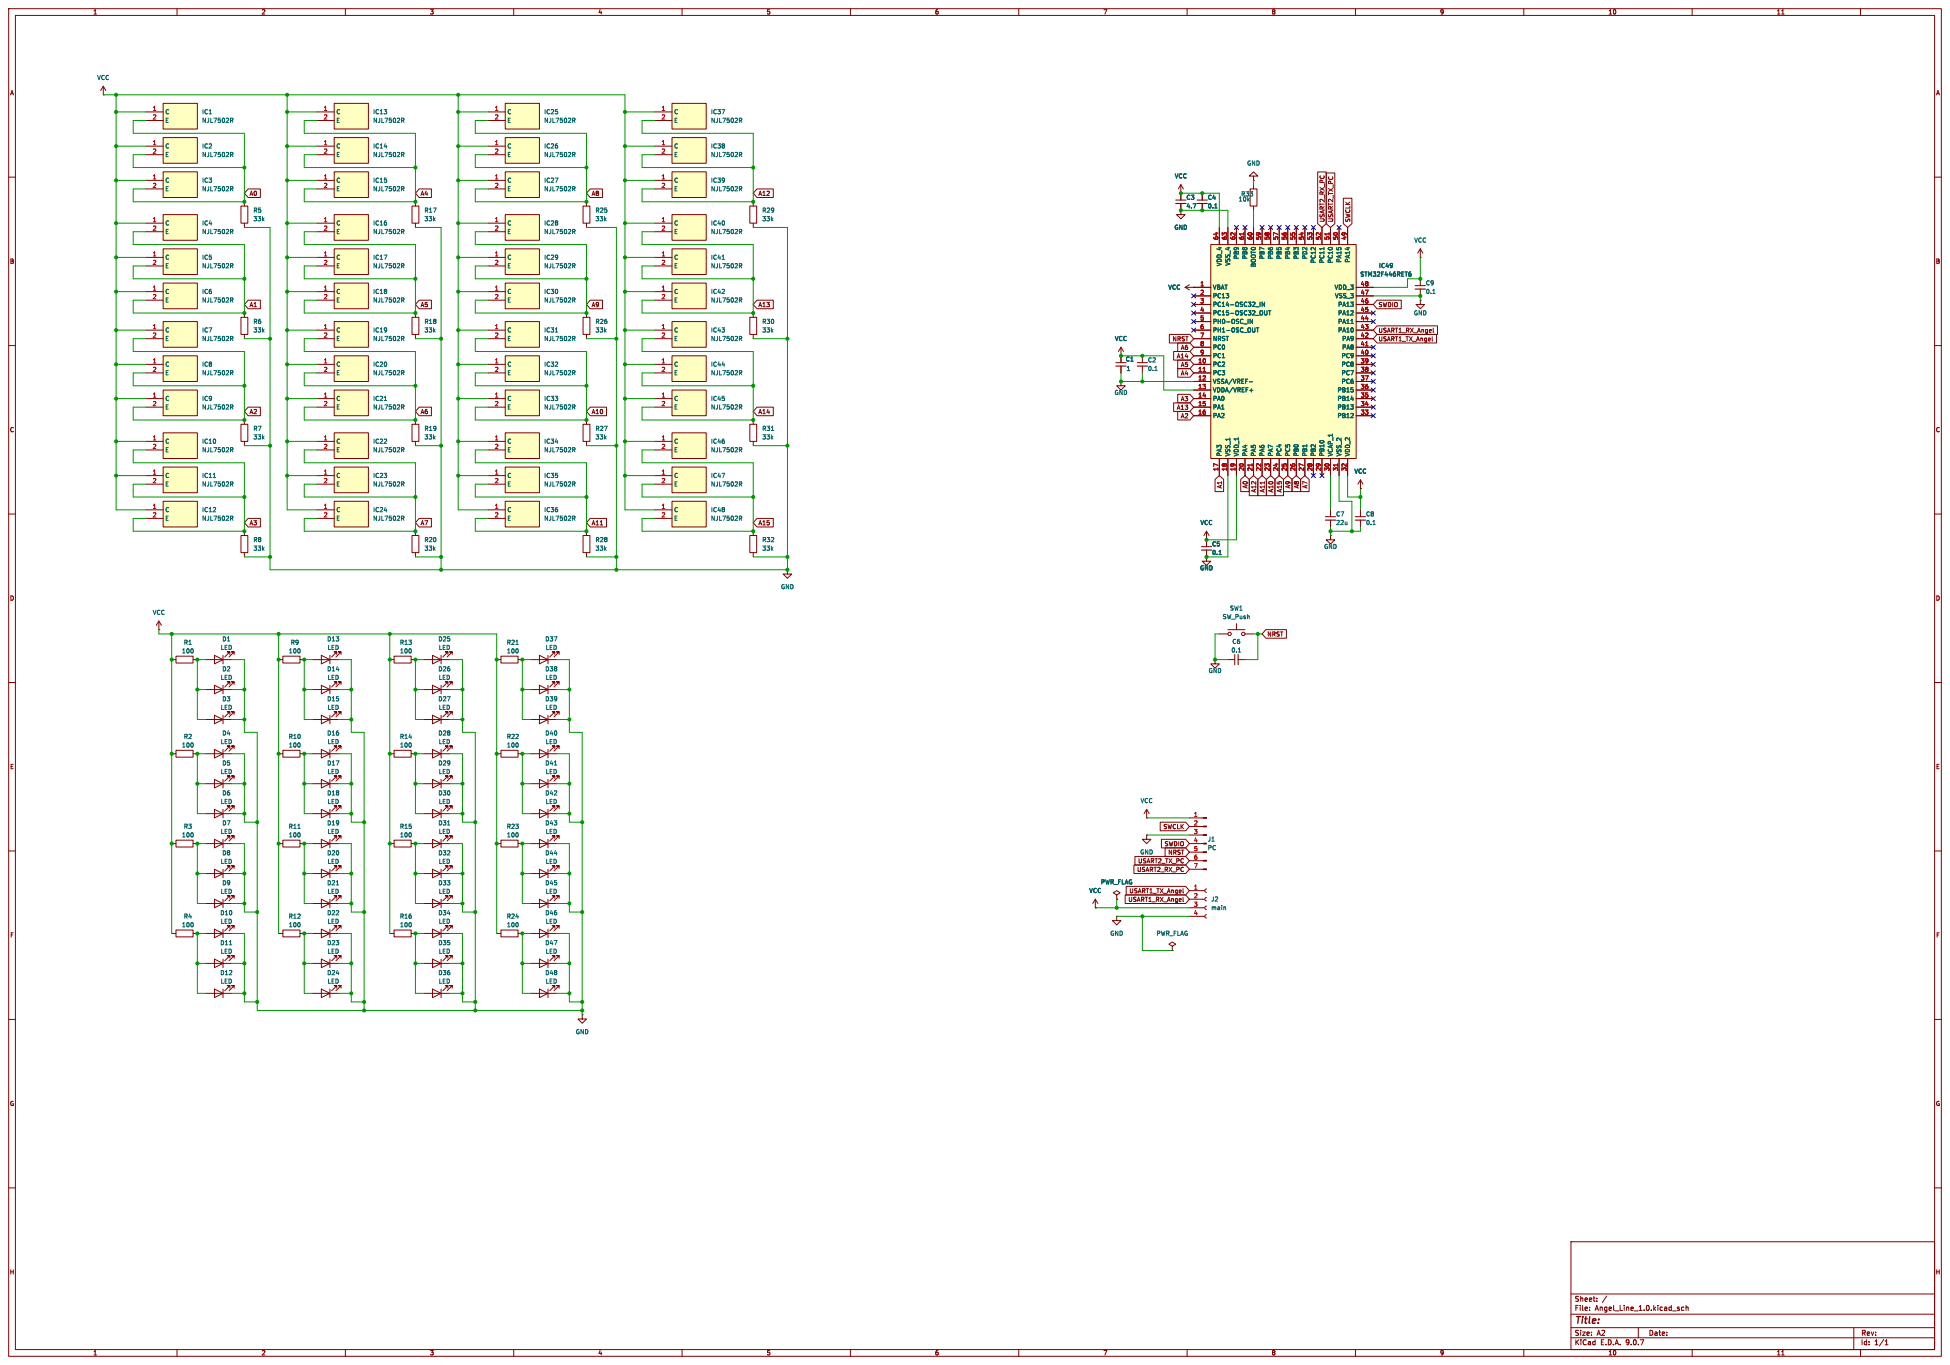
[picture p78: page 1]

11 VSSA/VREF- 12 VDDA/VREF+
