Soda-DENGIKEN/Ritsumori-cup2026/others/2026リツモリカップ予算表v1.pdf

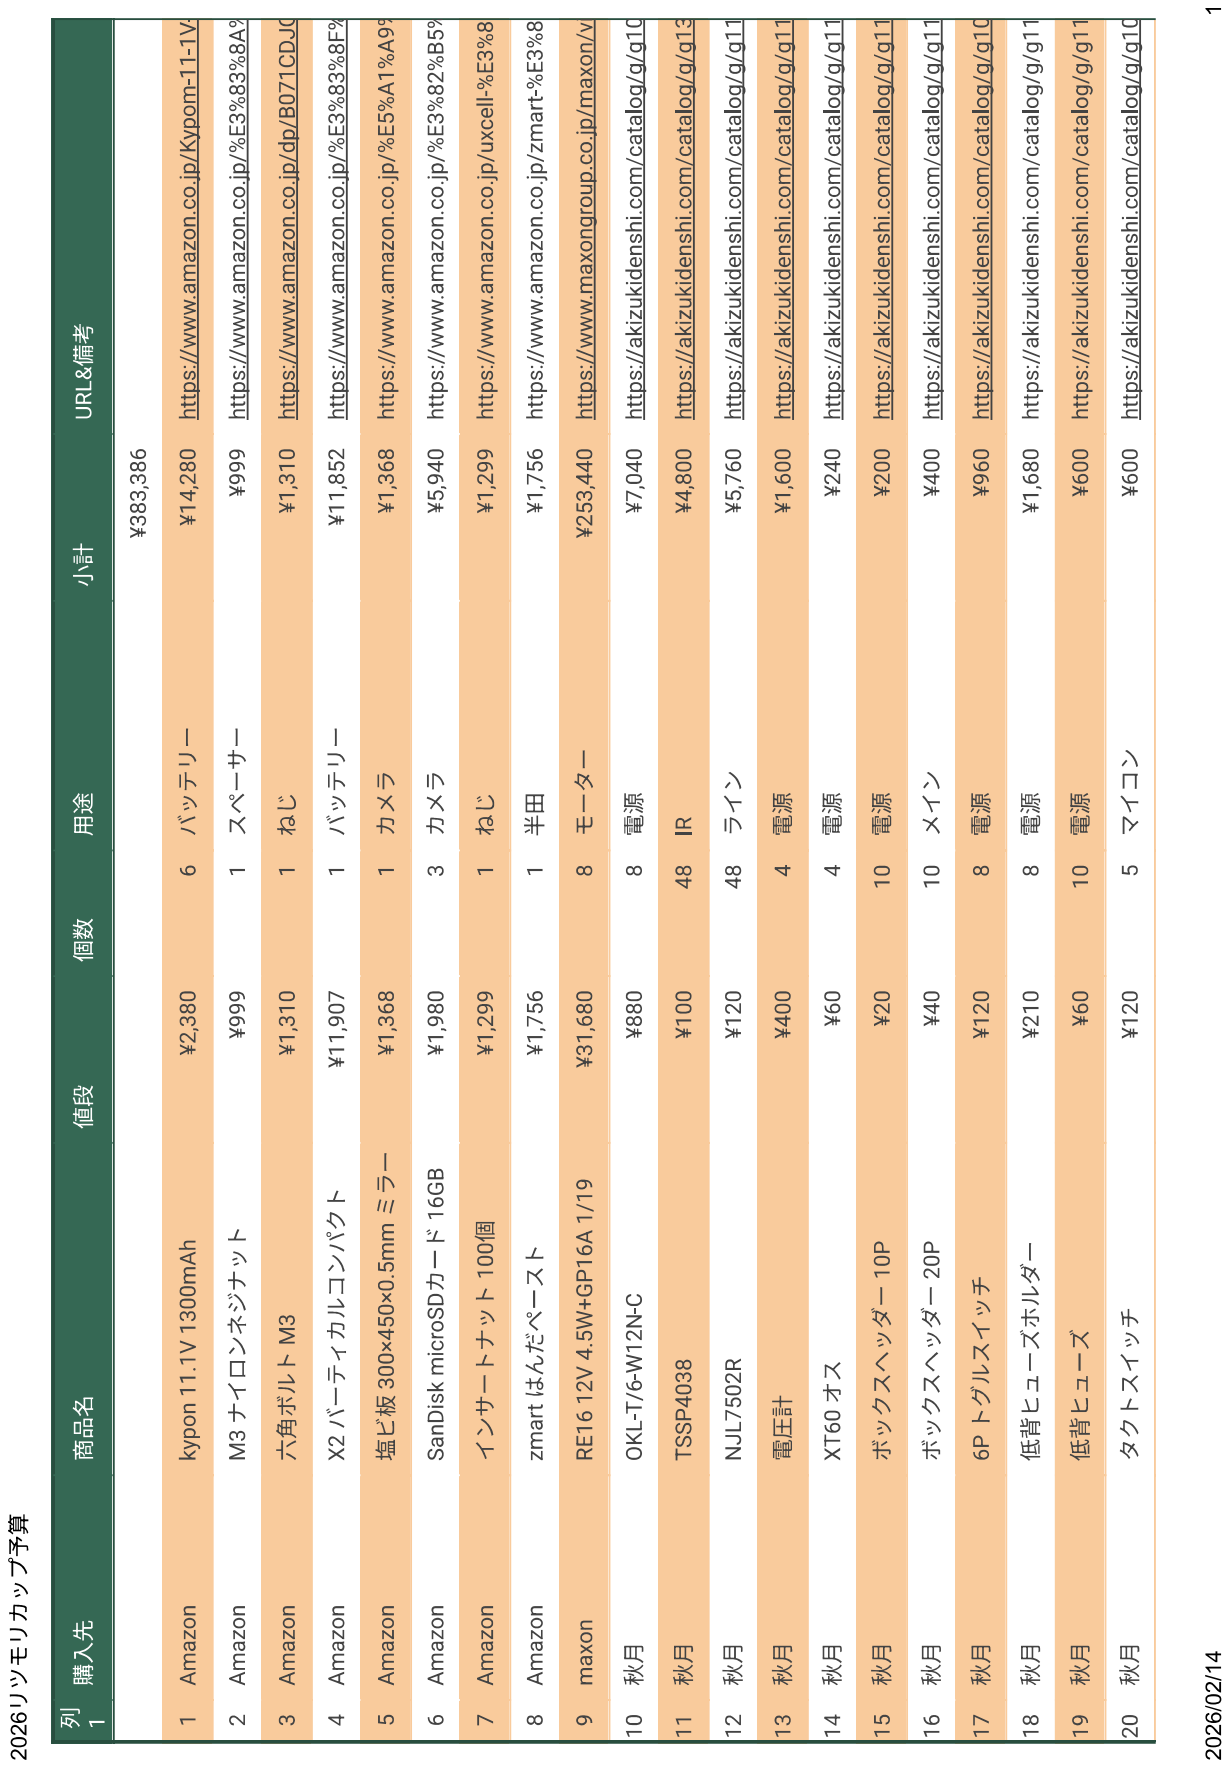
[picture p79: page 1]

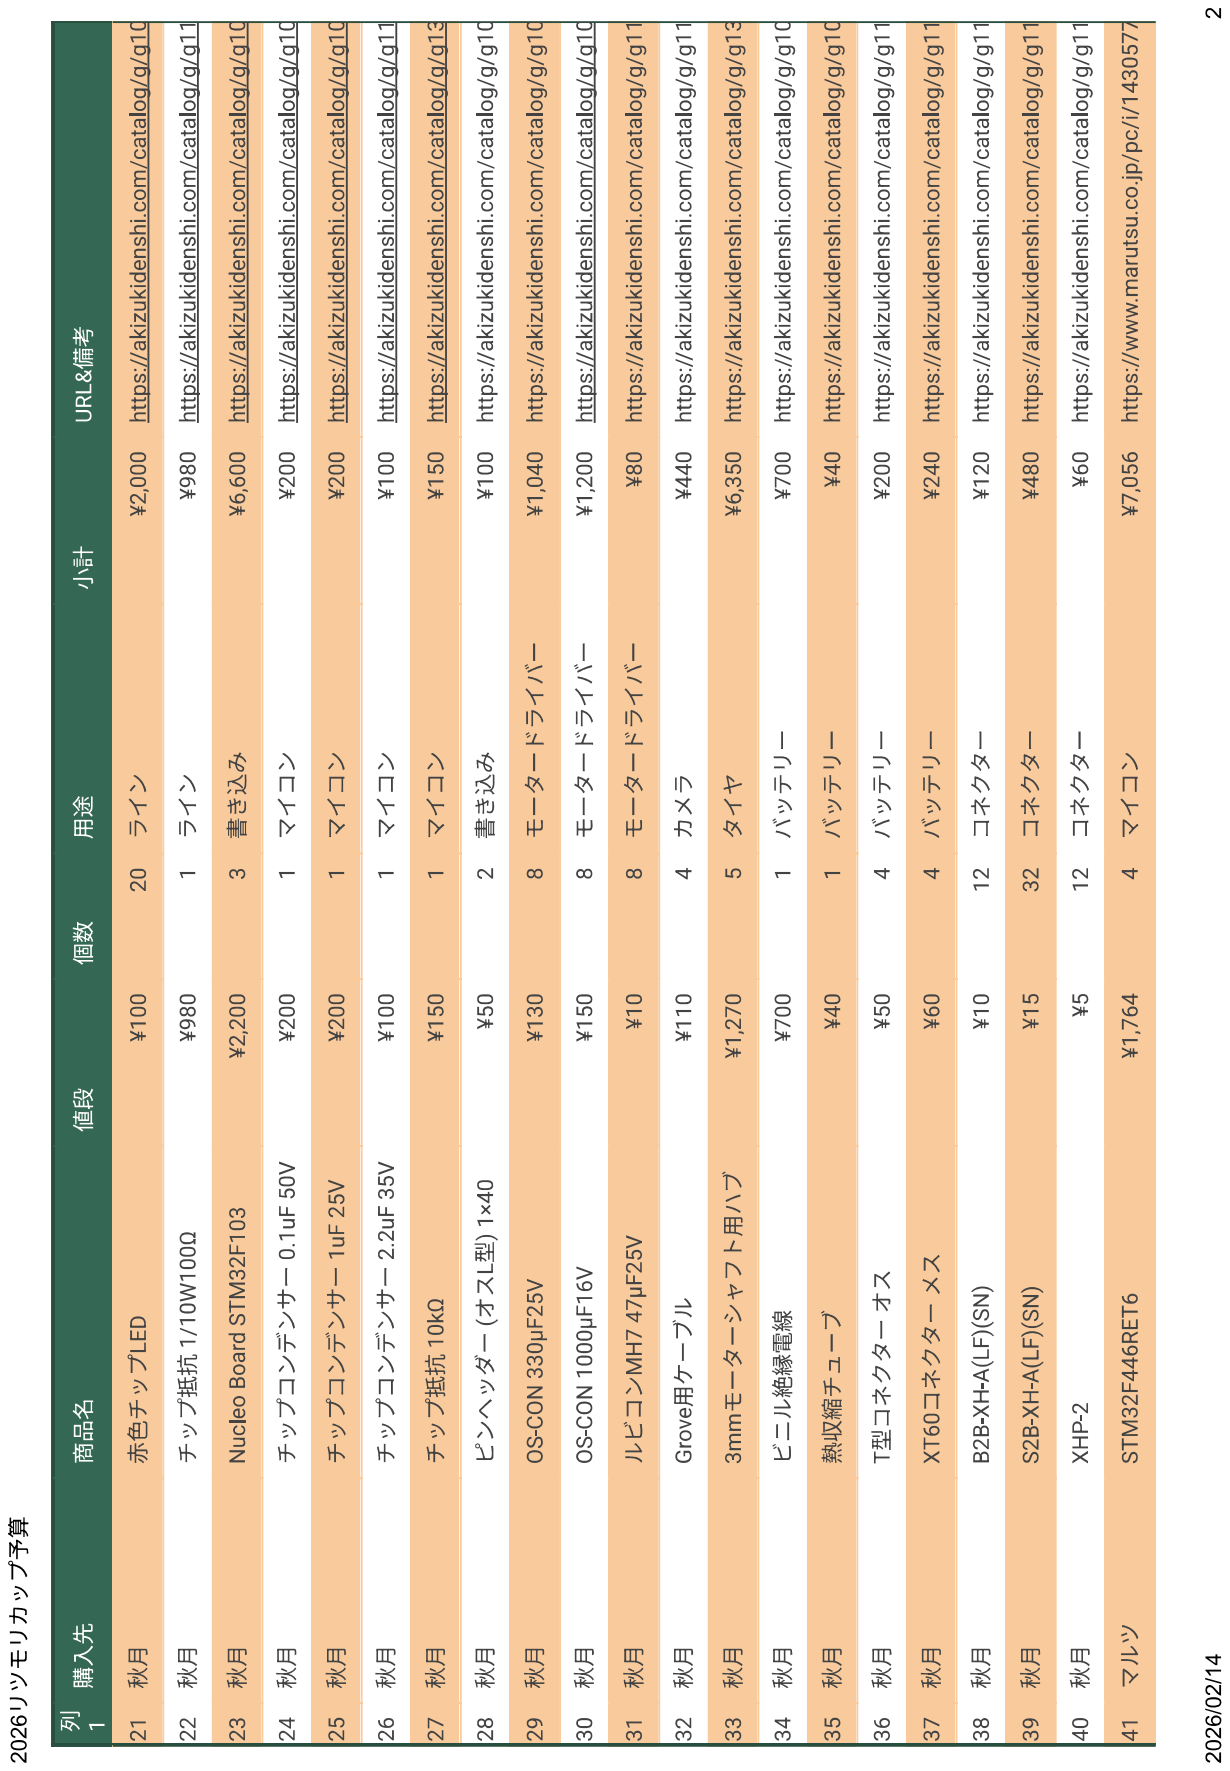
[picture p80: page 2]

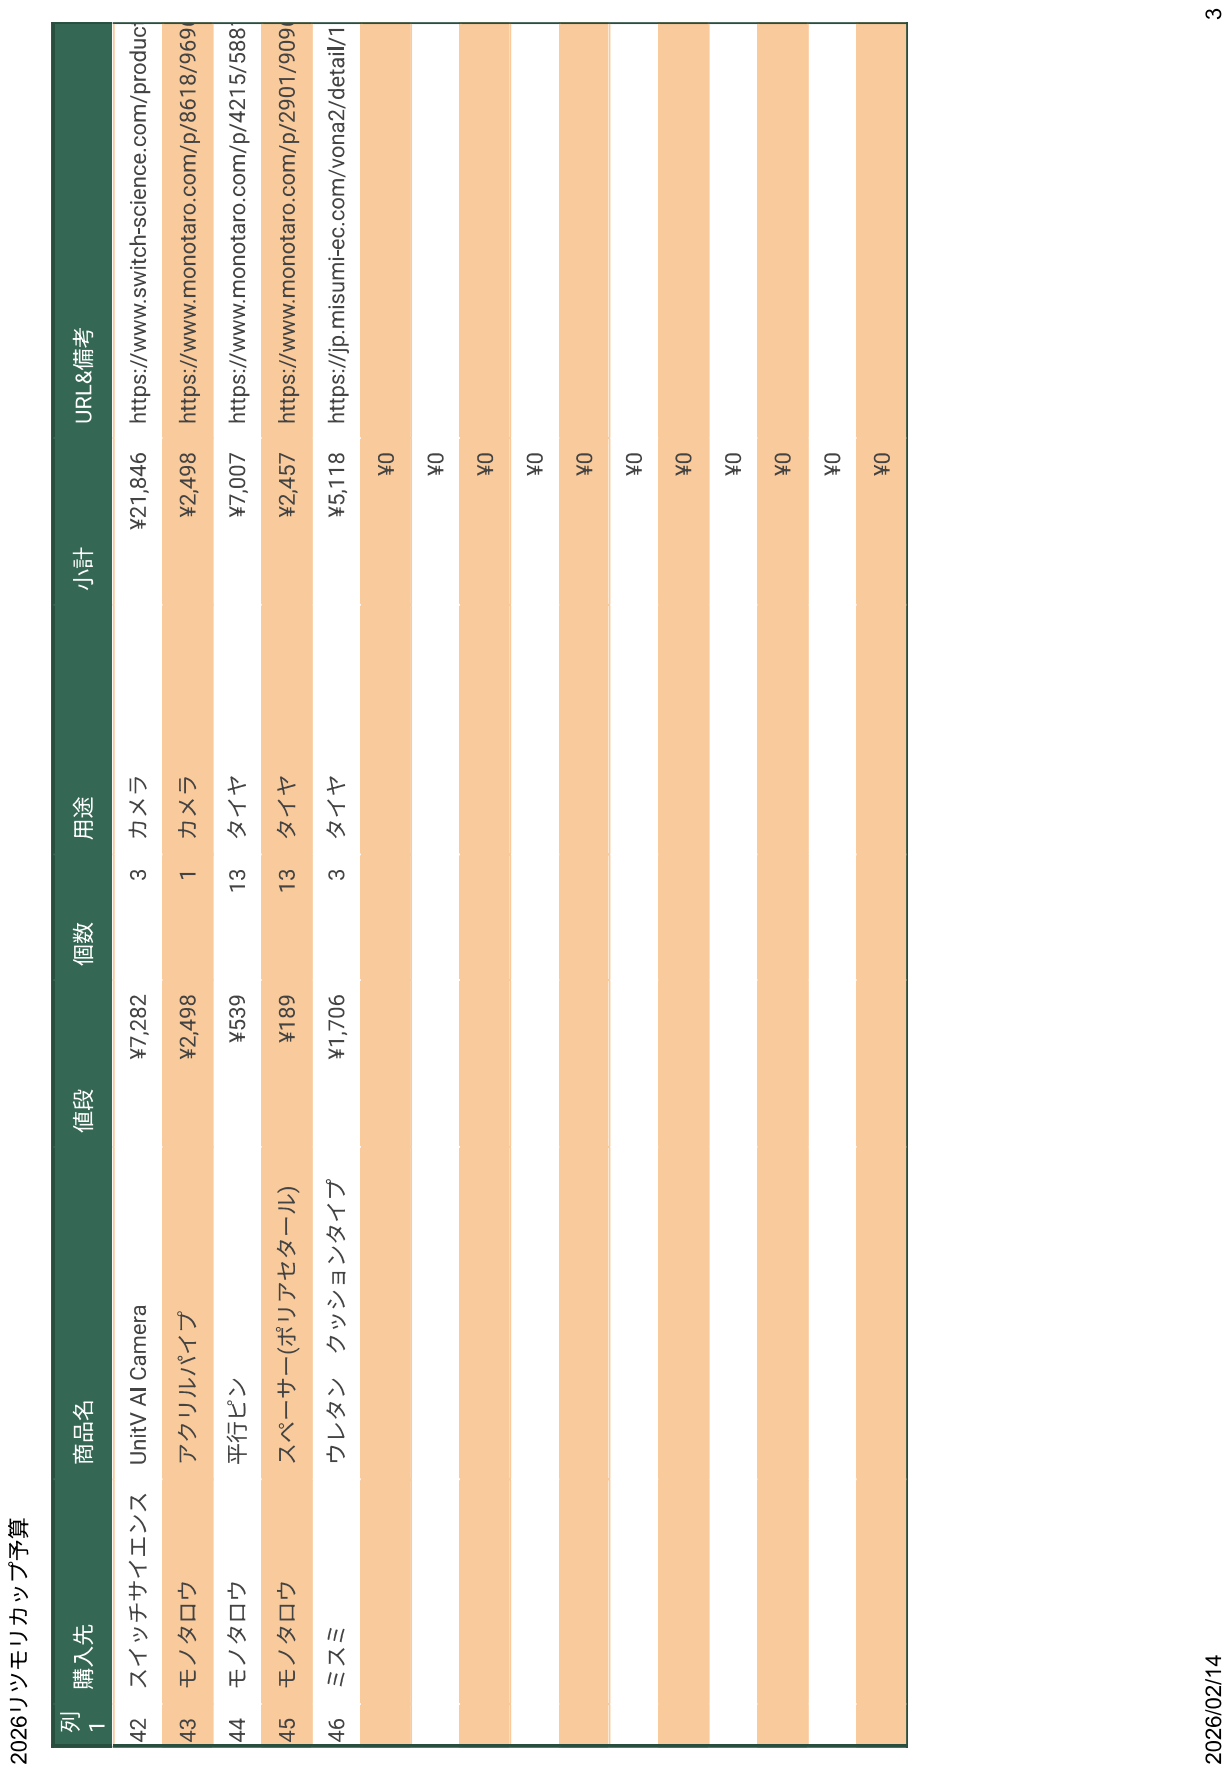
[picture p81: page 3]
