Soda-DENGIKEN/Ritsumori-cup2026/Substrate/Angel_Line_1.0/Angel_Line_1.0.kicad_pcb

## KiCad design Substrate/Angel_Line_1.0/Angel_Line_1.0.kicad_pcb (2026-06-11)

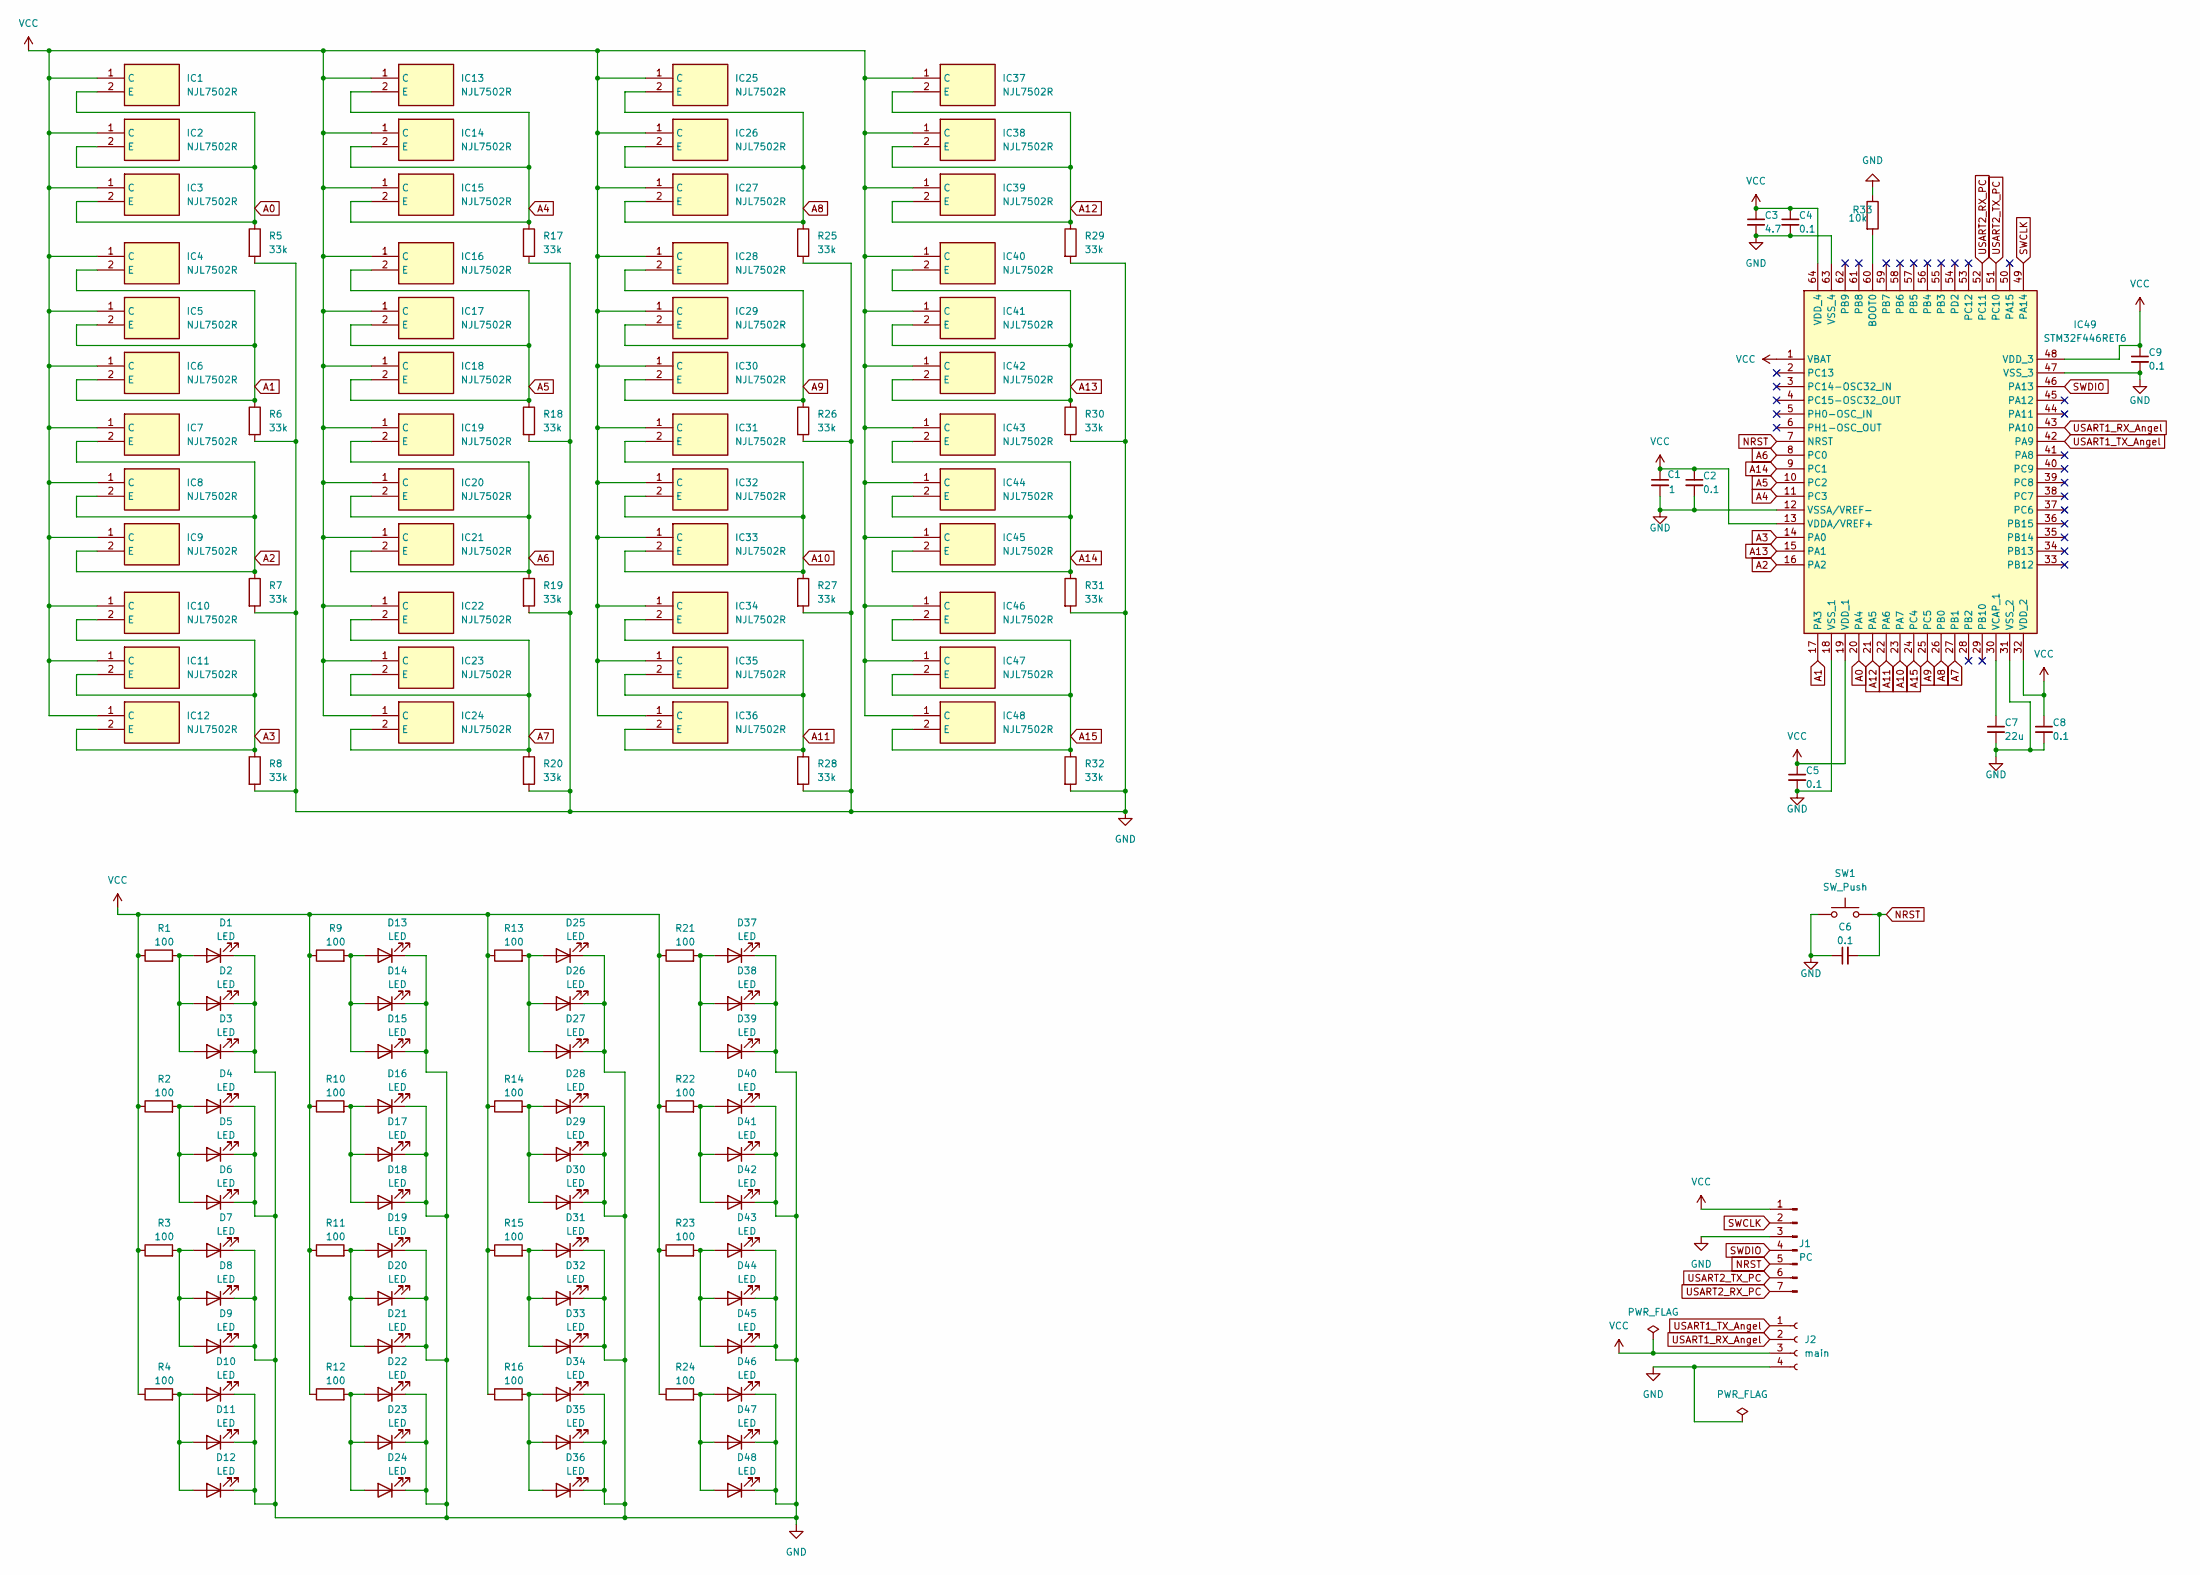
[picture p82: schematic Angel_Line_1.0.kicad_sch]

Parts:
C1: 1; C_0603_1608Metric
C2, C4, C5, C6, C8, C9: 0.1; C_0603_1608Metric
C3: 4.7; C_0603_1608Metric
C7: 22u; C_0603_1608Metric
D1, D2, D3, D4, D5, D6, D7, D8, D9, D10, D11, D12, D13, D14, D15, D16, D17, D18, D19, D20, D21, D22, D23, D24, D25, D26, D27, D28, D29, D30, D31, D32, D33, D34, D35, D36, D37, D38, D39, D40, D41, D42, D43, D44, D45, D46, D47, D48: LED; LED_0603_1608Metric_Pad1.05x0.95mm_HandSolder
IC1, IC2, IC3, IC4, IC5, IC6, IC7, IC8, IC9, IC10, IC11, IC12, IC13, IC14, IC15, IC16, IC17, IC18, IC19, IC20, IC21, IC22, IC23, IC24, IC25, IC26, IC27, IC28, IC29, IC30, IC31, IC32, IC33, IC34, IC35, IC36, IC37, IC38, IC39, IC40, IC41, IC42, IC43, IC44, IC45, IC46, IC47, IC48: NJL7502R; Manufacturer_Part_Number NJL7502R
IC49: STM32F446RET6; LQFP-64_10x10mm_P0.5mm; Manufacturer_Part_Number STM32F446RET6; Mouser Part Number 511-STM32F446RET6
J1: PC; PinHeader_1x07_P2.54mm_Vertical
J2: main; JST_XH_B4B-XH-A_1x04_P2.50mm_Vertical
R1, R2, R3, R4, R9, R10, R11, R12, R13, R14, R15, R16, R21, R22, R23, R24: 100; R_0603_1608Metric_Pad0.98x0.95mm_HandSolder
R5, R6, R7, R8, R17, R18, R19, R20, R25, R26, R27, R28, R29, R30, R31, R32: 33k; R_0603_1608Metric_Pad0.98x0.95mm_HandSolder
R33: 10k; R_0603_1608Metric
SW1: SW_Push; SKRPABE010

Connections:
A0: IC1.2 (E), IC2.2 (E), IC3.2 (E), IC49.20 (PA4), R5.1
A1: IC4.2 (E), IC5.2 (E), IC6.2 (E), IC49.17 (PA3), R6.1
A2: IC7.2 (E), IC8.2 (E), IC9.2 (E), IC49.16 (PA2), R7.1
A3: IC10.2 (E), IC11.2 (E), IC12.2 (E), IC49.14 (PA0), R8.1
A4: IC13.2 (E), IC14.2 (E), IC15.2 (E), IC49.11 (PC3), R17.1
A5: IC16.2 (E), IC17.2 (E), IC18.2 (E), IC49.10 (PC2), R18.1
A6: IC19.2 (E), IC20.2 (E), IC21.2 (E), IC49.8 (PC0), R19.1
A7: IC22.2 (E), IC23.2 (E), IC24.2 (E), IC49.27 (PB1), R20.1
A8: IC25.2 (E), IC26.2 (E), IC27.2 (E), IC49.26 (PB0), R25.1
A9: IC28.2 (E), IC29.2 (E), IC30.2 (E), IC49.25 (PC5), R26.1
A10: IC31.2 (E), IC32.2 (E), IC33.2 (E), IC49.23 (PA7), R27.1
A11: IC34.2 (E), IC35.2 (E), IC36.2 (E), IC49.22 (PA6), R28.1
A12: IC37.2 (E), IC38.2 (E), IC39.2 (E), IC49.21 (PA5), R29.1
A13: IC40.2 (E), IC41.2 (E), IC42.2 (E), IC49.15 (PA1), R30.1
A14: IC43.2 (E), IC44.2 (E), IC45.2 (E), IC49.9 (PC1), R31.1
A15: IC46.2 (E), IC47.2 (E), IC48.2 (E), IC49.24 (PC4), R32.1
GND: C1.2, C2.2, C3.2, C4.2, C5.2, C6.1, C7.2, C8.2, C9.2, D1.1 (K), D2.1 (K), D3.1 (K), D4.1 (K), D5.1 (K), D6.1 (K), D7.1 (K), D8.1 (K), D9.1 (K), D10.1 (K), D11.1 (K), D12.1 (K), D13.1 (K), D14.1 (K), D15.1 (K), D16.1 (K), D17.1 (K), D18.1 (K), D19.1 (K), D20.1 (K), D21.1 (K), D22.1 (K), D23.1 (K), D24.1 (K), D25.1 (K), D26.1 (K), D27.1 (K), D28.1 (K), D29.1 (K), D30.1 (K), D31.1 (K), D32.1 (K), D33.1 (K), D34.1 (K), D35.1 (K), D36.1 (K), D37.1 (K), D38.1 (K), D39.1 (K), D40.1 (K), D41.1 (K), D42.1 (K), D43.1 (K), D44.1 (K), D45.1 (K), D46.1 (K), D47.1 (K), D48.1 (K), IC49.12 (VSSA/VREF-), IC49.18 (VSS_1), IC49.31 (VSS_2), IC49.47 (VSS_3), IC49.63 (VSS_4), J1.3, J2.4, R5.2, R6.2, R7.2, R8.2, R17.2, R18.2, R19.2, R20.2, R25.2, R26.2, R27.2, R28.2, R29.2, R30.2, R31.2, R32.2, R33.1, SW1.1
NRST: C6.2, IC49.7 (NRST), J1.5, SW1.2
unnamed: D1.2 (A), D2.2 (A), D3.2 (A), R1.2
unnamed: D4.2 (A), D5.2 (A), D6.2 (A), R2.2
unnamed: D7.2 (A), D8.2 (A), D9.2 (A), R3.2
unnamed: D10.2 (A), D11.2 (A), D12.2 (A), R4.2
unnamed: D13.2 (A), D14.2 (A), D15.2 (A), R9.2
unnamed: D16.2 (A), D17.2 (A), D18.2 (A), R10.2
unnamed: D19.2 (A), D20.2 (A), D21.2 (A), R11.2
unnamed: D22.2 (A), D23.2 (A), D24.2 (A), R12.2
unnamed: D25.2 (A), D26.2 (A), D27.2 (A), R13.2
unnamed: D28.2 (A), D29.2 (A), D30.2 (A), R14.2
unnamed: D31.2 (A), D32.2 (A), D33.2 (A), R15.2
unnamed: D34.2 (A), D35.2 (A), D36.2 (A), R16.2
unnamed: D37.2 (A), D38.2 (A), D39.2 (A), R21.2
unnamed: D40.2 (A), D41.2 (A), D42.2 (A), R22.2
unnamed: D43.2 (A), D44.2 (A), D45.2 (A), R23.2
unnamed: D46.2 (A), D47.2 (A), D48.2 (A), R24.2
unnamed: IC49.60 (BOOT0), R33.2
unnamed: C7.1, IC49.30 (VCAP_1)
SWCLK: IC49.49 (PA14), J1.2
SWDIO: IC49.46 (PA13), J1.4
USART1_RX_Angel: IC49.43 (PA10), J2.2
USART1_TX_Angel: IC49.42 (PA9), J2.1
USART2_RX_PC: IC49.52 (PC11), J1.7
USART2_TX_PC: IC49.51 (PC10), J1.6
VCC: C1.1, C2.1, C3.1, C4.1, C5.1, C8.1, C9.1, IC1.1 (C), IC2.1 (C), IC3.1 (C), IC4.1 (C), IC5.1 (C), IC6.1 (C), IC7.1 (C), IC8.1 (C), IC9.1 (C), IC10.1 (C), IC11.1 (C), IC12.1 (C), IC13.1 (C), IC14.1 (C), IC15.1 (C), IC16.1 (C), IC17.1 (C), IC18.1 (C), IC19.1 (C), IC20.1 (C), IC21.1 (C), IC22.1 (C), IC23.1 (C), IC24.1 (C), IC25.1 (C), IC26.1 (C), IC27.1 (C), IC28.1 (C), IC29.1 (C), IC30.1 (C), IC31.1 (C), IC32.1 (C), IC33.1 (C), IC34.1 (C), IC35.1 (C), IC36.1 (C), IC37.1 (C), IC38.1 (C), IC39.1 (C), IC40.1 (C), IC41.1 (C), IC42.1 (C), IC43.1 (C), IC44.1 (C), IC45.1 (C), IC46.1 (C), IC47.1 (C), IC48.1 (C), IC49.1 (VBAT), IC49.13 (VDDA/VREF+), IC49.19 (VDD_1), IC49.32 (VDD_2), IC49.48 (VDD_3), IC49.64 (VDD_4), J1.1, J2.3, R1.1, R2.1, R3.1, R4.1, R9.1, R10.1, R11.1, R12.1, R13.1, R14.1, R15.1, R16.1, R21.1, R22.1, R23.1, R24.1

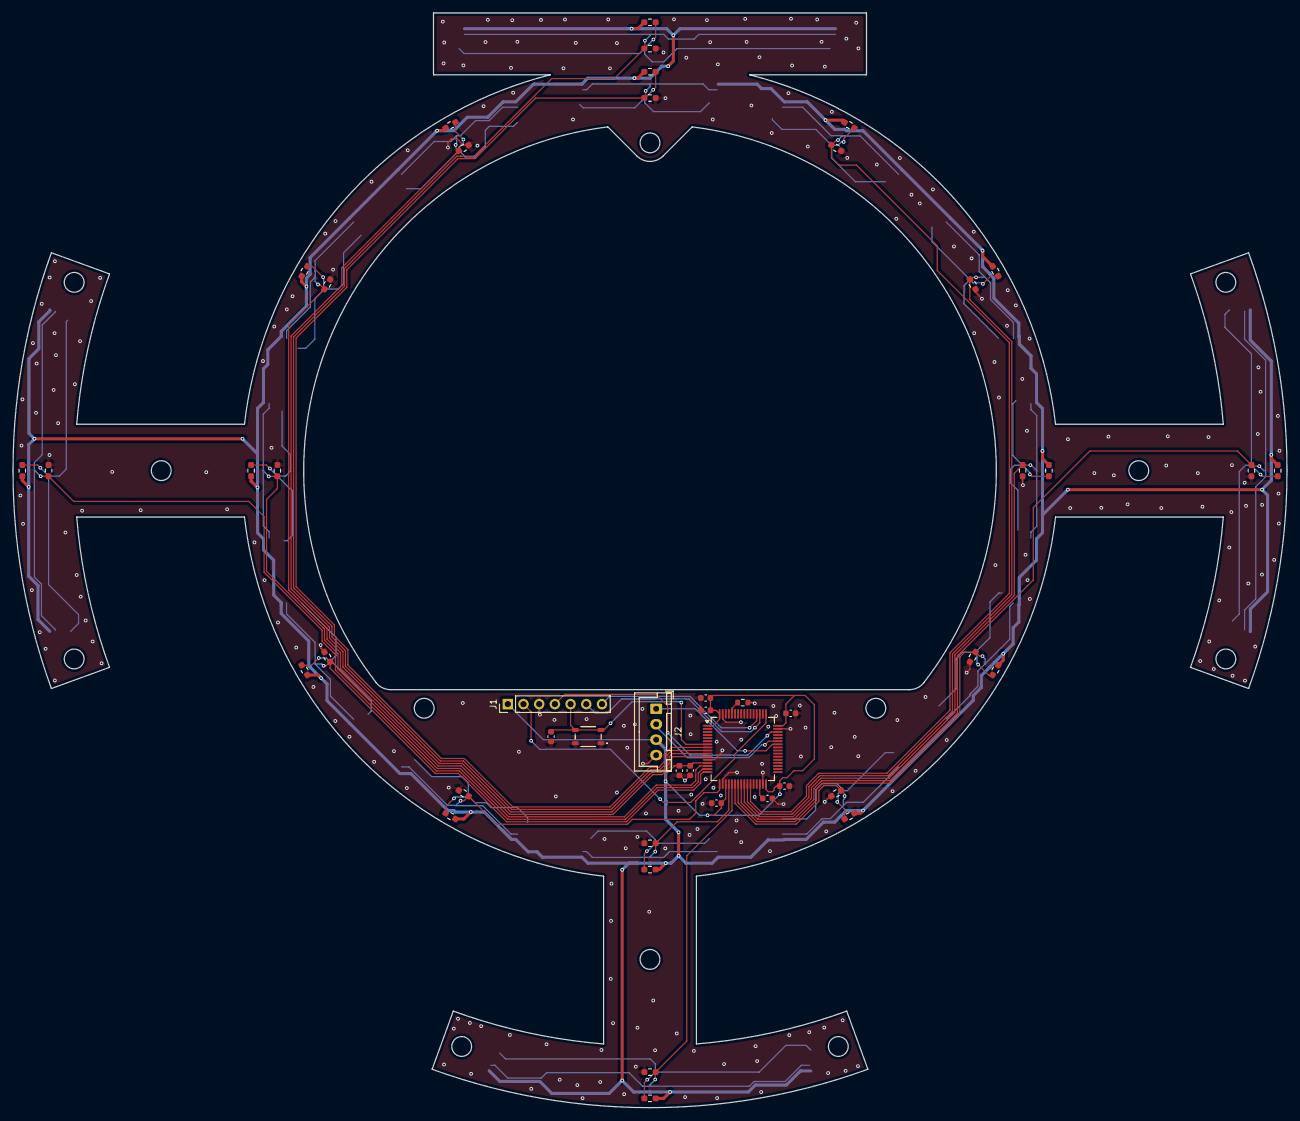
[picture p83: board Angel_Line_1.0.kicad_pcb from above]

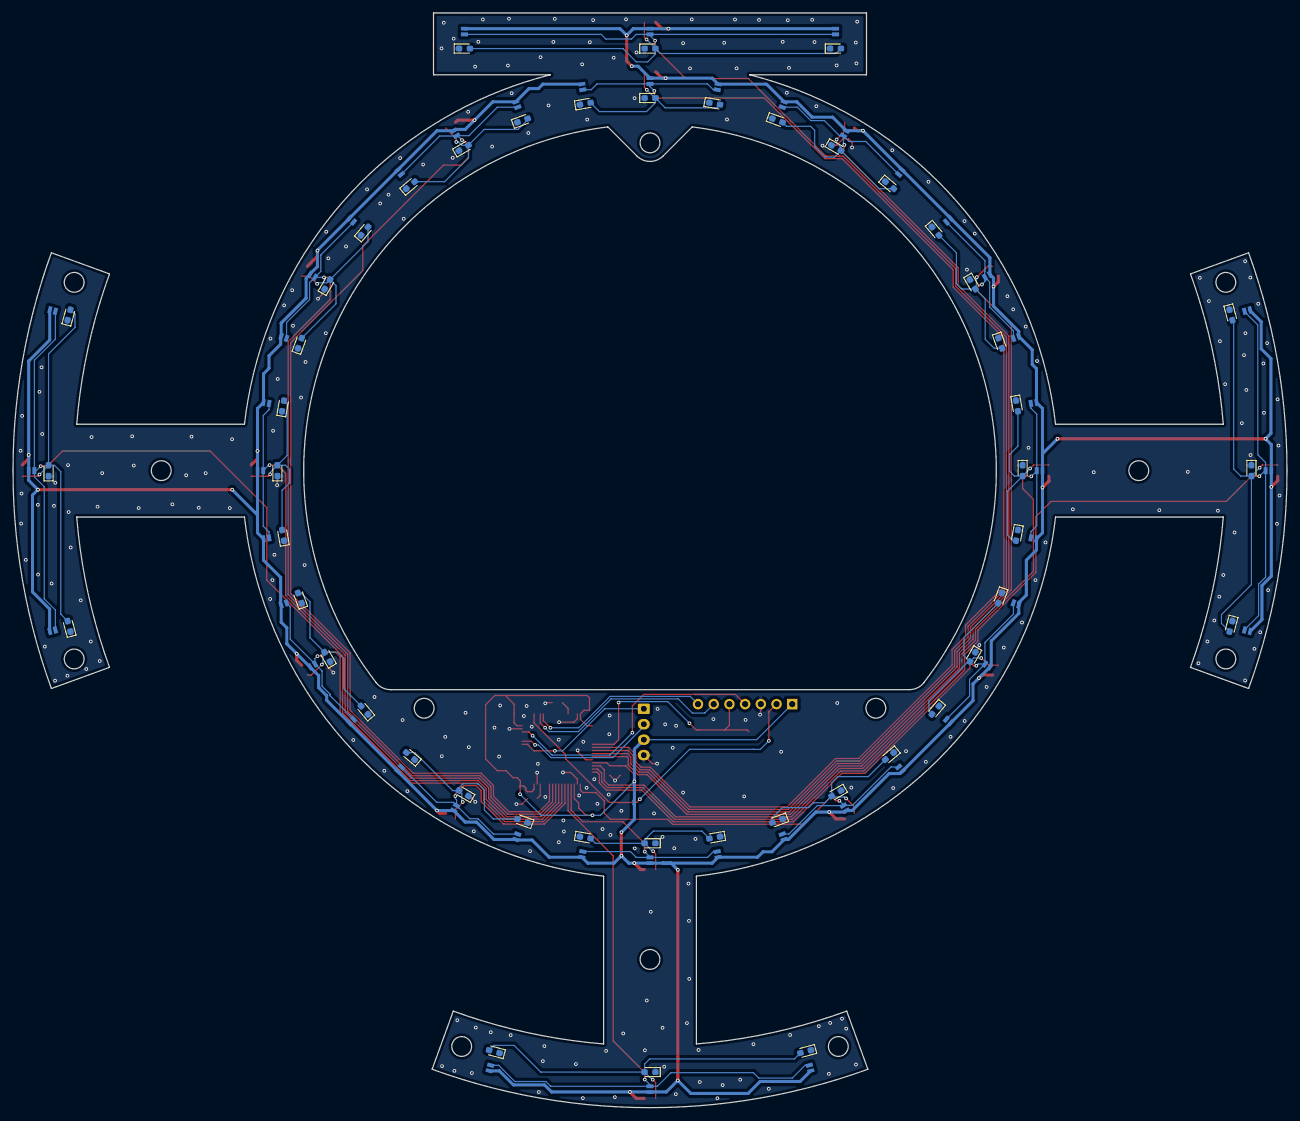
[picture p84: board Angel_Line_1.0.kicad_pcb from below]

Board: 2 copper layers, 206.0 x 177.0 mm, 142 parts (96 on the bottom side), 43 nets.
