Soda-DENGIKEN/Ritsumori-cup2026/Substrate/IR board_1.0/IR board_1.0.kicad_pcb

## KiCad design Substrate/IR board_1.0/IR board_1.0.kicad_pcb (2026-04-30)

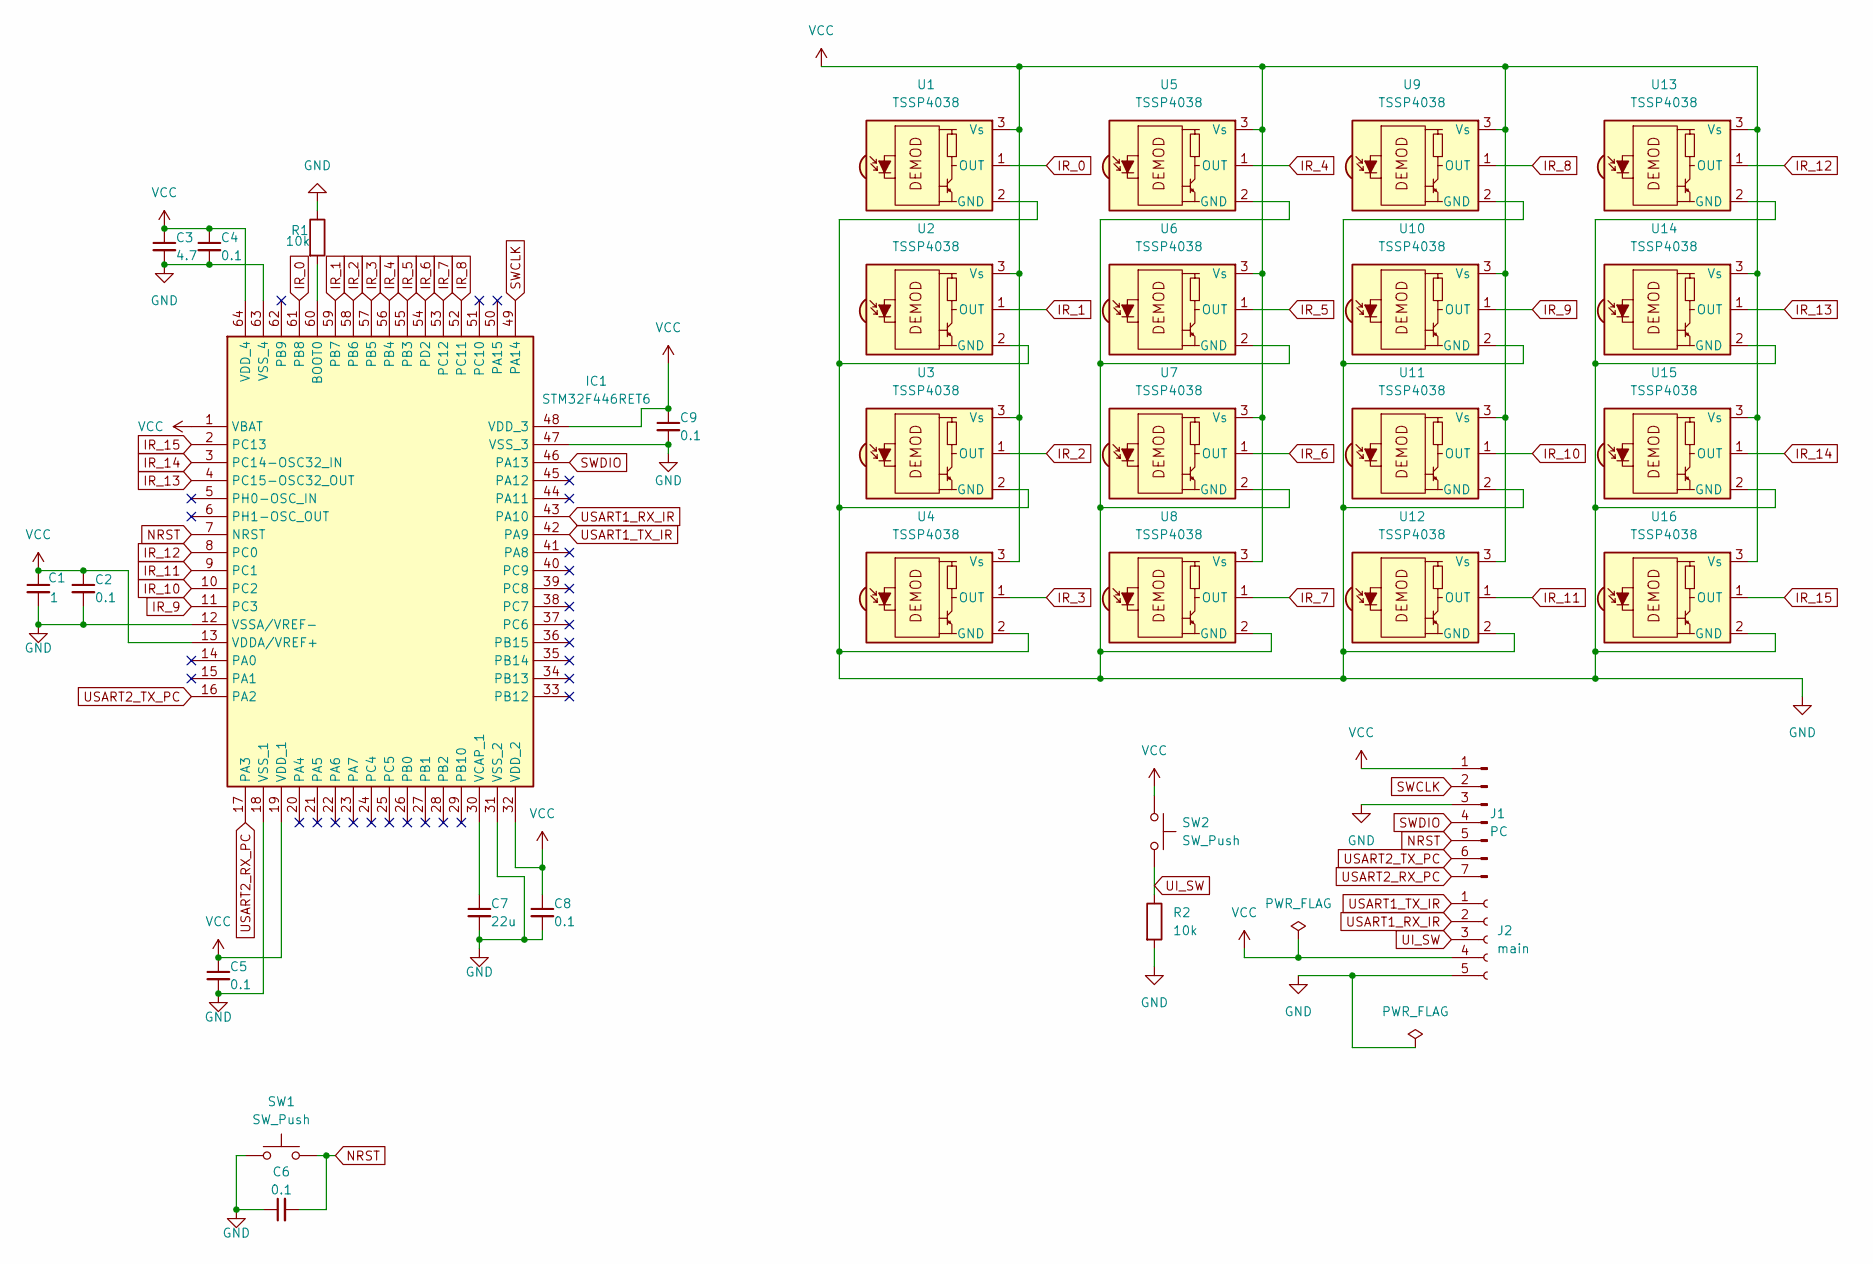
[picture p85: schematic IR board_1.0.kicad_sch]

Parts:
C1: 1; C_0603_1608Metric
C2, C4, C5, C6, C8, C9: 0.1; C_0603_1608Metric
C3: 4.7; C_0603_1608Metric
C7: 22u; C_0603_1608Metric
IC1: STM32F446RET6; LQFP-64_10x10mm_P0.5mm; Manufacturer_Part_Number STM32F446RET6; Mouser Part Number 511-STM32F446RET6
J1: PC; PinHeader_1x07_P2.54mm_Horizontal
J2: main; JST_XH_B5B-XH-A_1x05_P2.50mm_Vertical
R1, R2: 10k; R_0603_1608Metric
SW1: SW_Push; SKRPABE010
SW2: SW_Push; TVGP01-G73BB
U1, U2, U3, U4, U5, U6, U7, U8, U9, U10, U11, U12, U13, U14, U15, U16: TSSP4038; Vishay_MINICAST-3Pin

Connections:
GND: C1.2, C2.2, C3.2, C4.2, C5.2, C6.1, C7.2, C8.2, C9.2, IC1.12 (VSSA/VREF-), IC1.18 (VSS_1), IC1.31 (VSS_2), IC1.47 (VSS_3), IC1.63 (VSS_4), J1.3, J2.5, R1.1, R2.2, SW1.1, U1.2 (GND), U2.2 (GND), U3.2 (GND), U4.2 (GND), U5.2 (GND), U6.2 (GND), U7.2 (GND), U8.2 (GND), U9.2 (GND), U10.2 (GND), U11.2 (GND), U12.2 (GND), U13.2 (GND), U14.2 (GND), U15.2 (GND), U16.2 (GND); also elsewhere on the board
IR_0: IC1.61 (PB8), U1.1 (OUT)
IR_1: IC1.59 (PB7), U2.1 (OUT)
IR_2: IC1.58 (PB6), U3.1 (OUT)
IR_3: IC1.57 (PB5), U4.1 (OUT)
IR_4: IC1.56 (PB4), U5.1 (OUT)
IR_5: IC1.55 (PB3), U6.1 (OUT)
IR_6: IC1.54 (PD2), U7.1 (OUT)
IR_7: IC1.53 (PC12), U8.1 (OUT)
IR_8: IC1.52 (PC11), U9.1 (OUT)
IR_9: IC1.11 (PC3), U10.1 (OUT)
IR_10: IC1.10 (PC2), U11.1 (OUT)
IR_11: IC1.9 (PC1), U12.1 (OUT)
IR_12: IC1.8 (PC0), U13.1 (OUT)
IR_13: IC1.4 (PC15-OSC32_OUT), U14.1 (OUT)
IR_14: IC1.3 (PC14-OSC32_IN), U15.1 (OUT)
IR_15: IC1.2 (PC13), U16.1 (OUT)
NRST: C6.2, IC1.7 (NRST), J1.5, SW1.2
unnamed: IC1.60 (BOOT0), R1.2
unnamed: C7.1, IC1.30 (VCAP_1)
SWCLK: IC1.49 (PA14), J1.2
SWDIO: IC1.46 (PA13), J1.4
UI_SW: J2.3, R2.1, SW2.2
USART1_RX_IR: IC1.43 (PA10), J2.2
USART1_TX_IR: IC1.42 (PA9), J2.1
USART2_RX_PC: IC1.17 (PA3), J1.7
USART2_TX_PC: IC1.16 (PA2), J1.6
VCC: C1.1, C2.1, C3.1, C4.1, C5.1, C8.1, C9.1, IC1.1 (VBAT), IC1.13 (VDDA/VREF+), IC1.19 (VDD_1), IC1.32 (VDD_2), IC1.48 (VDD_3), IC1.64 (VDD_4), J1.1, J2.4, SW2.1, U1.3 (Vs), U2.3 (Vs), U3.3 (Vs), U4.3 (Vs), U5.3 (Vs), U6.3 (Vs), U7.3 (Vs), U8.3 (Vs), U9.3 (Vs), U10.3 (Vs), U11.3 (Vs), U12.3 (Vs), U13.3 (Vs), U14.3 (Vs), U15.3 (Vs), U16.3 (Vs); also elsewhere on the board

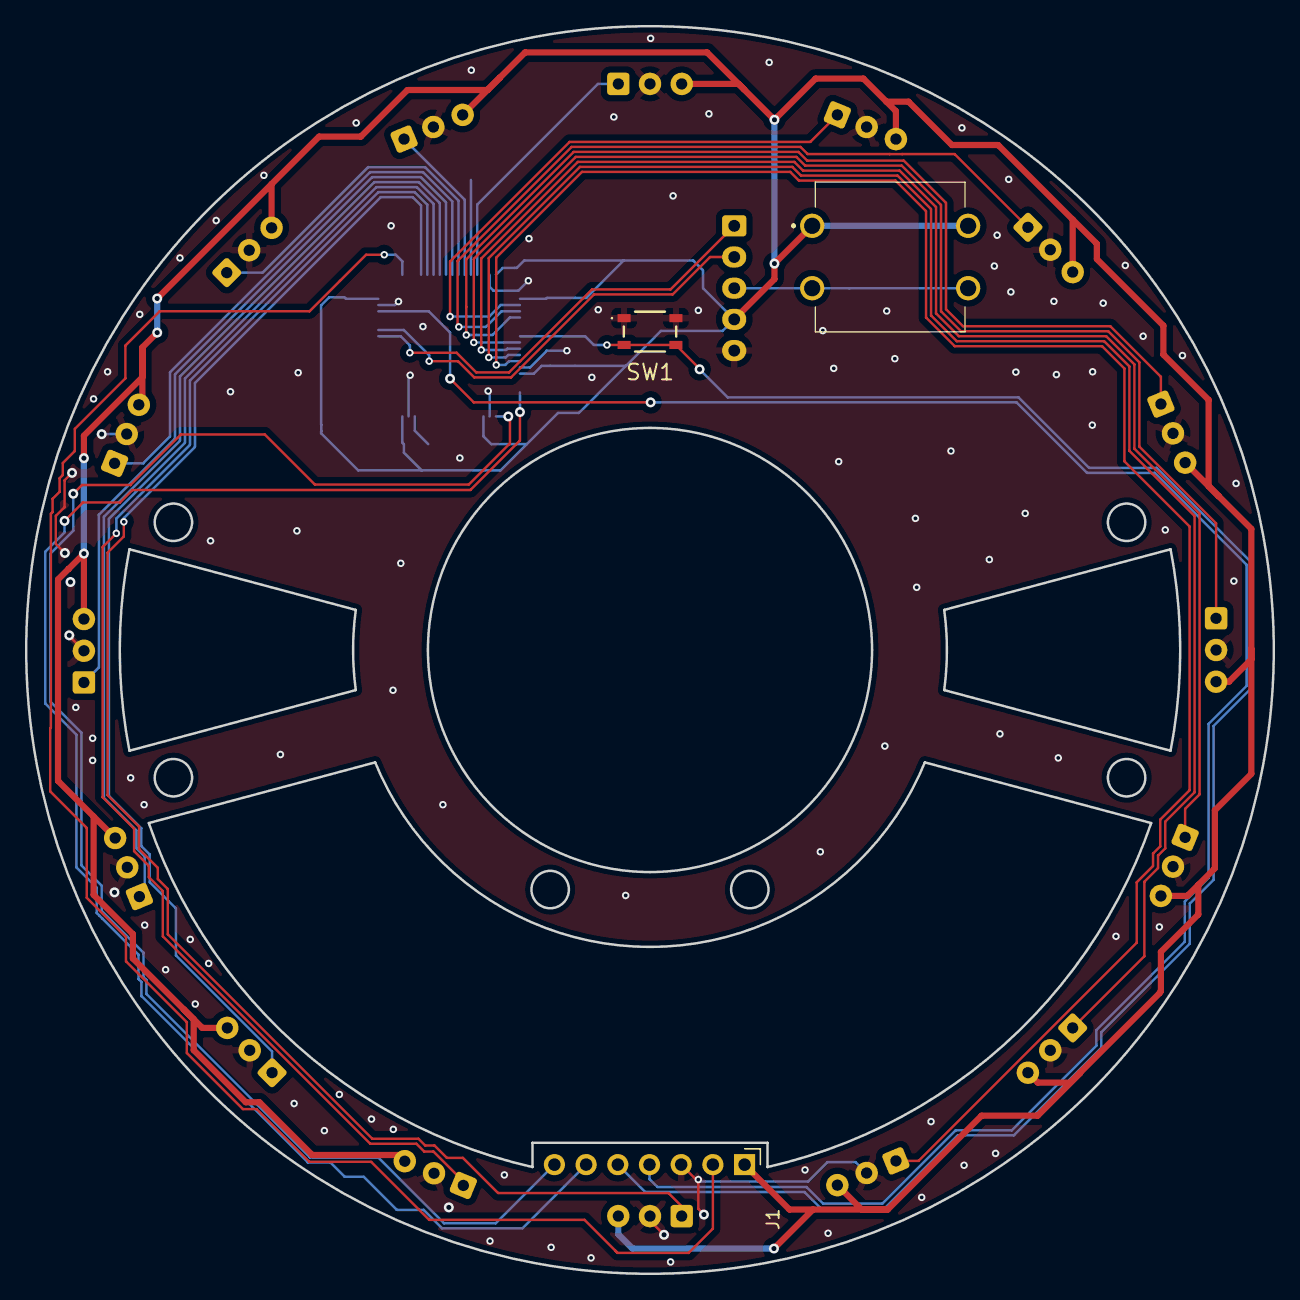
[picture p86: board IR board_1.0.kicad_pcb from above]

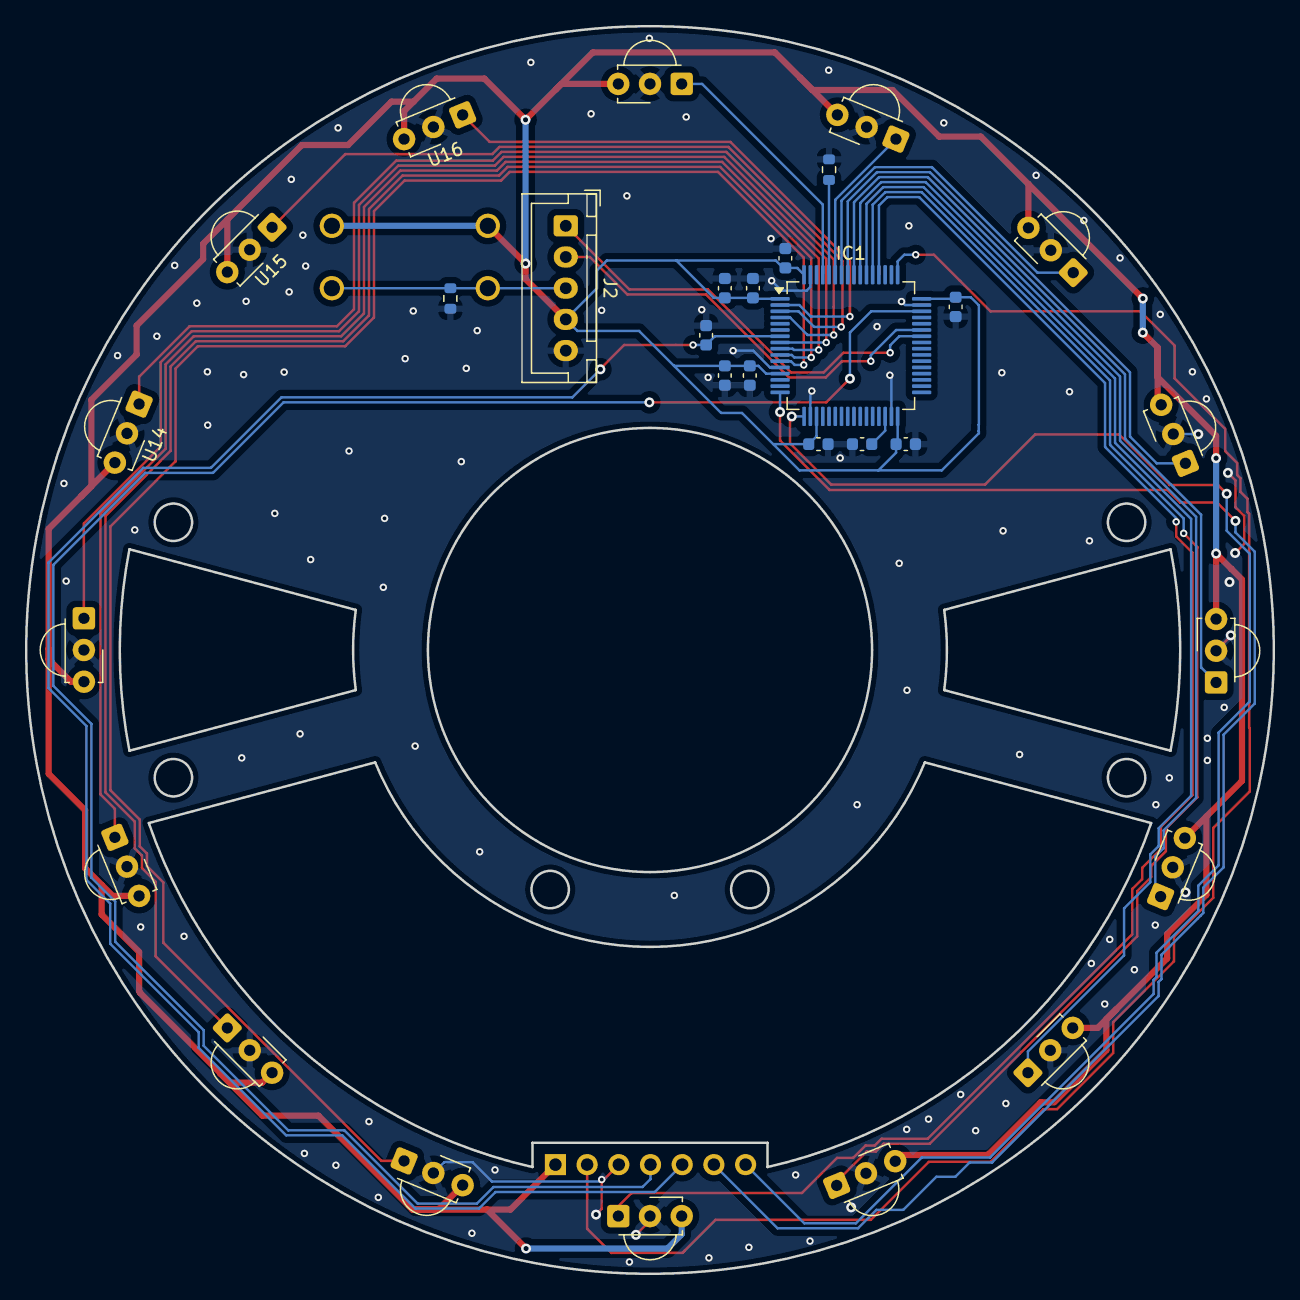
[picture p87: board IR board_1.0.kicad_pcb from below]

Board: 2 copper layers, 100.0 x 100.0 mm, 33 parts (30 on the bottom side), 28 nets.

Other parts of the board:
C8#2: 0.1; C_0603_1608Metric

Their connections:
GND: C8#2.2; also elsewhere on the board
VCC: C8#2.1; also elsewhere on the board
