Soda-DENGIKEN/Ritsumori-cup2026/Substrate/Motor driver board_1.0/Motor driver board_1.0 (1).kicad_pcb

## KiCad design Substrate/Motor driver board_1.0/Motor driver board_1.0 (1).kicad_pcb (2026-04-30, an earlier design)

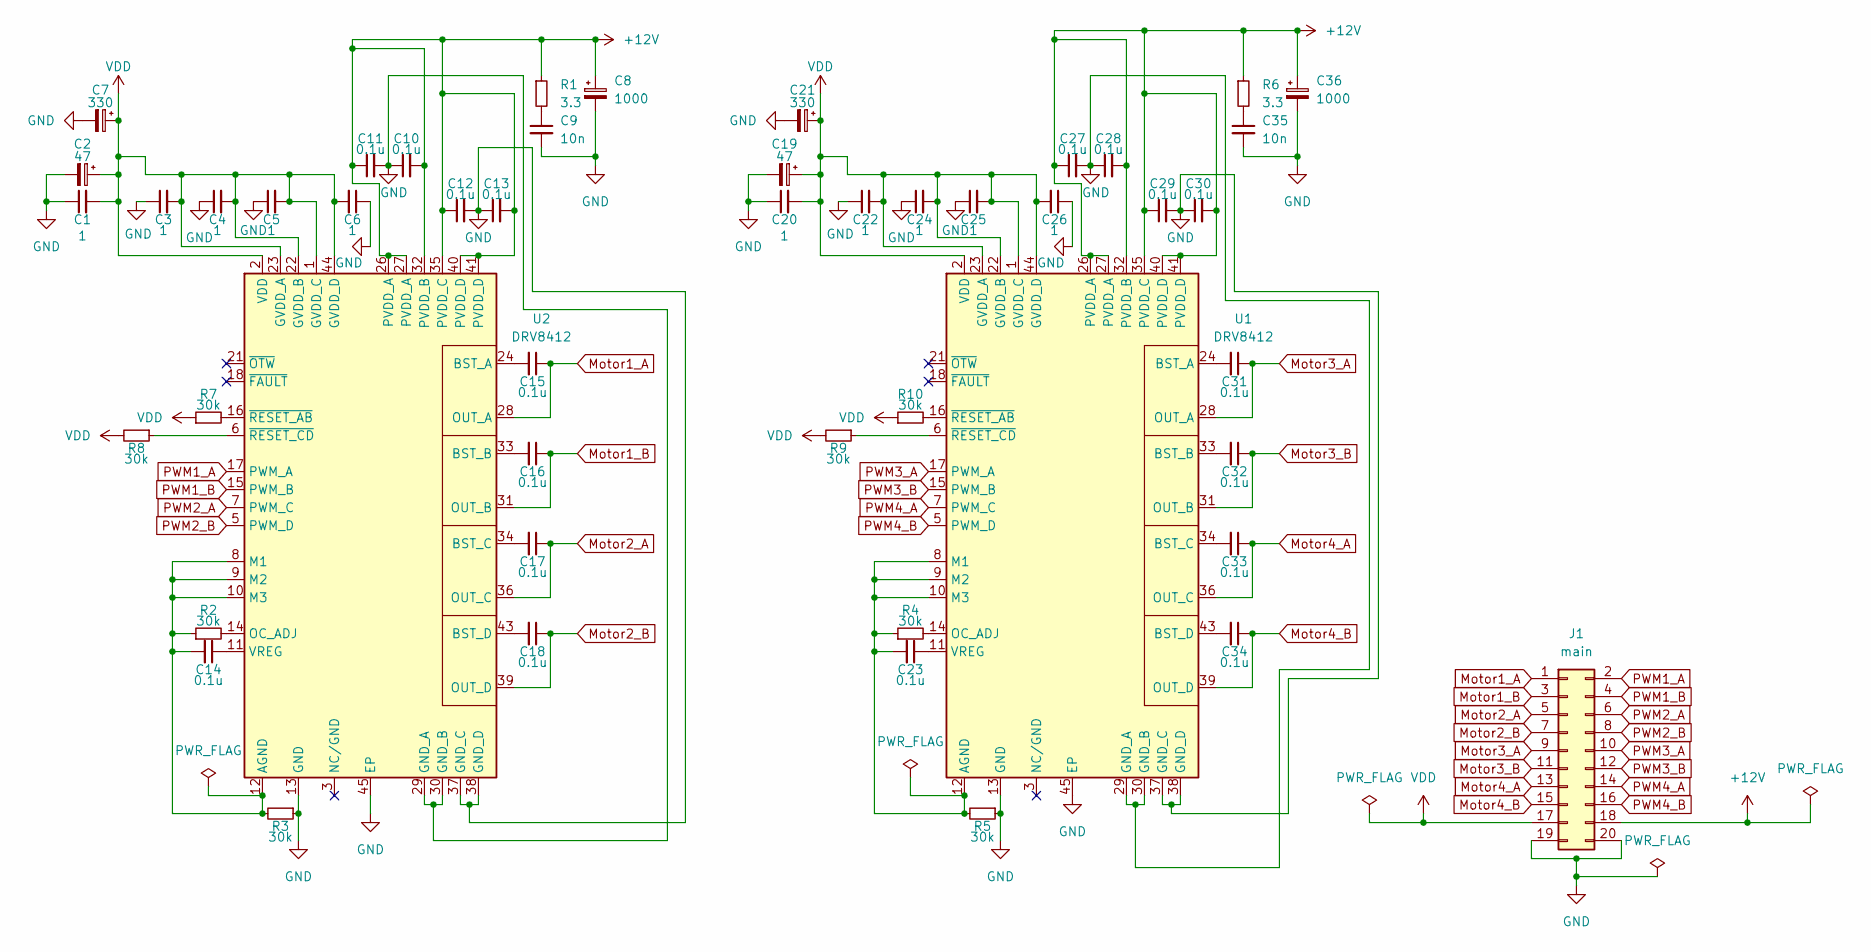
[picture p88: schematic Motor driver board_1.0 (1).kicad_sch]

Parts:
C1, C3, C4, C5, C6, C20, C22, C24, C25, C26: 1; C_0603_1608Metric
C2, C19: 47; CP_Radial_D6.3mm_P2.50mm
C7, C21: 330; CP_Radial_D10.0mm_P5.00mm
C8, C36: 1000; CP_Radial_D10.0mm_P5.00mm
C9, C35: 10n; C_0603_1608Metric
C10, C11, C12, C13, C14, C15, C16, C17, C18, C23, C27, C28, C29, C30, C31, C32, C33, C34: 0.1u; C_0603_1608Metric
J1: main; PinSocket_2x10_P2.54mm_Vertical
R1, R6: 3.3; R_0603_1608Metric
R2, R3, R4, R5, R7, R8, R9, R10: 30k; R_0603_1608Metric
U1, U2: DRV8412; HTSSOP-44-1EP_6.1x14mm_P0.635mm_EP5.2x14mm_Mask4.31x8.26mm_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

Connections:
+12V: C8.1, C10.2, C11.1, C12.1, C13.2, C27.1, C28.2, C29.1, C30.2, C36.1, J1.18, R1.1, R6.1, U1.26 (PVDD_A), U1.27 (PVDD_A), U1.32 (PVDD_B), U1.35 (PVDD_C), U1.40 (PVDD_D), U1.41 (PVDD_D), U2.26 (PVDD_A), U2.27 (PVDD_A), U2.32 (PVDD_B), U2.35 (PVDD_C), U2.40 (PVDD_D), U2.41 (PVDD_D)
GND: C1.1, C2.2, C3.1, C4.1, C5.1, C6.1, C7.2, C8.2, C9.2, C10.1, C11.2, C12.2, C13.1, C19.2, C20.1, C21.2, C22.1, C24.1, C25.1, C26.1, C27.2, C28.1, C29.2, C30.1, C35.2, C36.2, J1.19, J1.20, R3.1, R5.1, U1.13 (GND), U1.29 (GND_A), U1.30 (GND_B), U1.37 (GND_C), U1.38 (GND_D), U1.45 (EP), U2.13 (GND), U2.29 (GND_A), U2.30 (GND_B), U2.37 (GND_C), U2.38 (GND_D), U2.45 (EP)
Motor1_A: C15.1, J1.1, U2.28 (OUT_A)
Motor1_B: C16.1, J1.3, U2.31 (OUT_B)
Motor2_A: C17.1, J1.5, U2.36 (OUT_C)
Motor2_B: C18.1, J1.7, U2.39 (OUT_D)
Motor3_A: C31.1, J1.9, U1.28 (OUT_A)
Motor3_B: C32.1, J1.11, U1.31 (OUT_B)
Motor4_A: C33.1, J1.13, U1.36 (OUT_C)
Motor4_B: C34.1, J1.15, U1.39 (OUT_D)
unnamed: C9.1, R1.2
unnamed: C35.1, R6.2
unnamed: C23.2, R4.1, R5.2, U1.8 (M1), U1.9 (M2), U1.10 (M3), U1.12 (AGND)
unnamed: C31.2, U1.24 (BST_A)
unnamed: C32.2, U1.33 (BST_B)
unnamed: C33.2, U1.34 (BST_C)
unnamed: C34.2, U1.43 (BST_D)
unnamed: R4.2, U1.14 (OC_ADJ)
unnamed: C23.1, U1.11 (VREG)
unnamed: R10.2, U1.16 (~RESET_AB)
unnamed: R9.1, U1.6 (~RESET_CD)
unnamed: C14.2, R2.1, R3.2, U2.8 (M1), U2.9 (M2), U2.10 (M3), U2.12 (AGND)
unnamed: C15.2, U2.24 (BST_A)
unnamed: C16.2, U2.33 (BST_B)
unnamed: C17.2, U2.34 (BST_C)
unnamed: C18.2, U2.43 (BST_D)
unnamed: R2.2, U2.14 (OC_ADJ)
unnamed: C14.1, U2.11 (VREG)
unnamed: R7.2, U2.16 (~RESET_AB)
unnamed: R8.1, U2.6 (~RESET_CD)
PWM1_A: J1.2, U2.17 (PWM_A)
PWM1_B: J1.4, U2.15 (PWM_B)
PWM2_A: J1.6, U2.7 (PWM_C)
PWM2_B: J1.8, U2.5 (PWM_D)
PWM3_A: J1.10, U1.17 (PWM_A)
PWM3_B: J1.12, U1.15 (PWM_B)
PWM4_A: J1.14, U1.7 (PWM_C)
PWM4_B: J1.16, U1.5 (PWM_D)
VDD: C1.2, C2.1, C3.2, C4.2, C5.2, C6.2, C7.1, C19.1, C20.2, C21.1, C22.2, C24.2, C25.2, C26.2, J1.17, R7.1, R8.2, R9.2, R10.1, U1.1 (GVDD_C), U1.2 (VDD), U1.22 (GVDD_B), U1.23 (GVDD_A), U1.44 (GVDD_D), U2.1 (GVDD_C), U2.2 (VDD), U2.22 (GVDD_B), U2.23 (GVDD_A), U2.44 (GVDD_D)

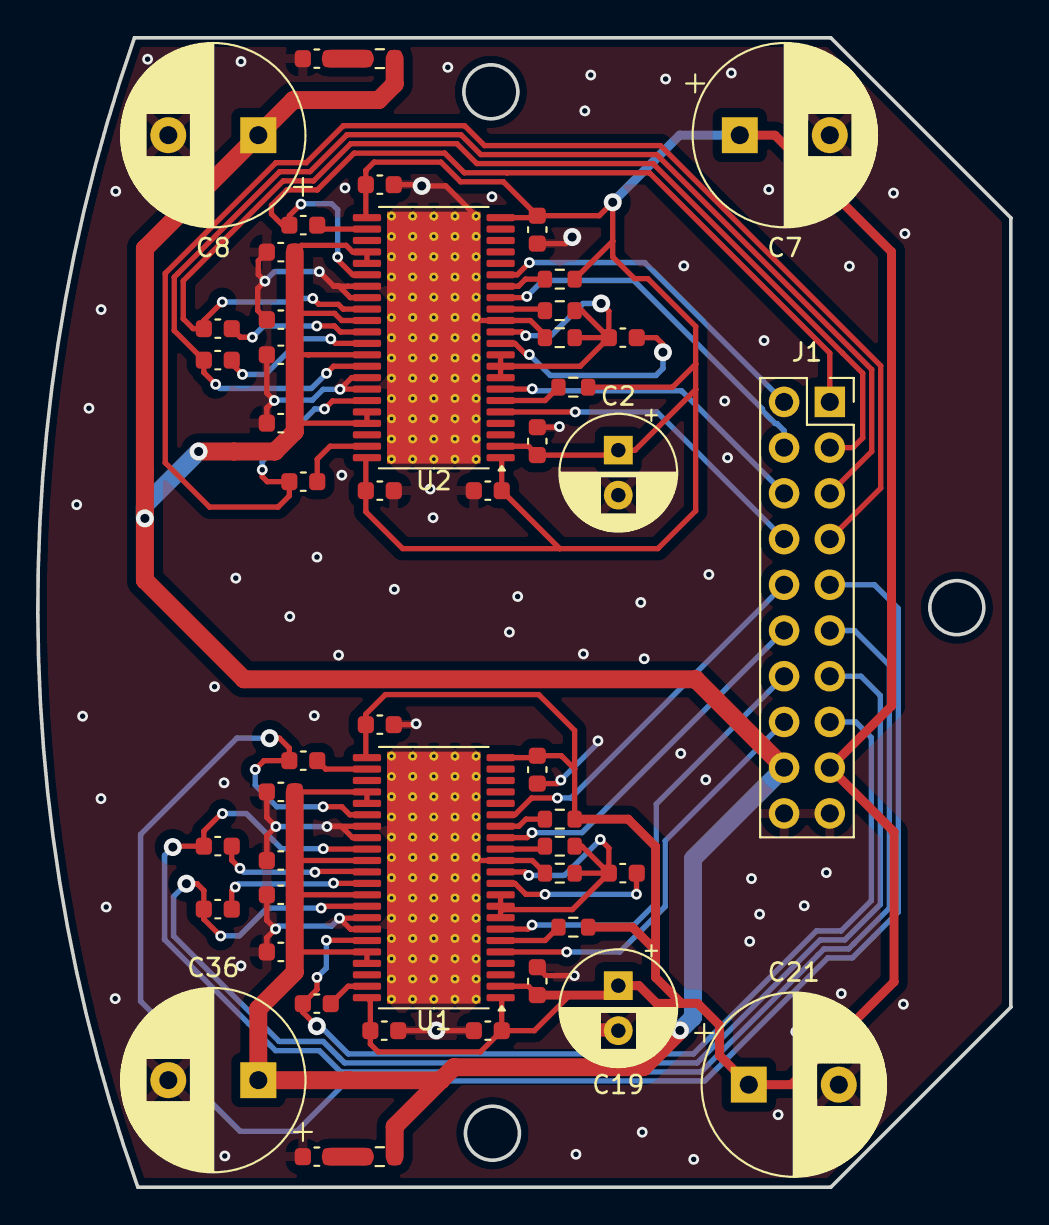
[picture p89: board Motor driver board_1.0 (1).kicad_pcb from above]

Board: 2 copper layers, 54.1 x 63.9 mm, 49 parts (0 on the bottom side), 39 nets.
