Soda-DENGIKEN/Ritsumori-cup2026/Substrate/Main board/Main board.kicad_pcb

## KiCad design Substrate/Main board/Main board.kicad_pcb (2026-04-30)

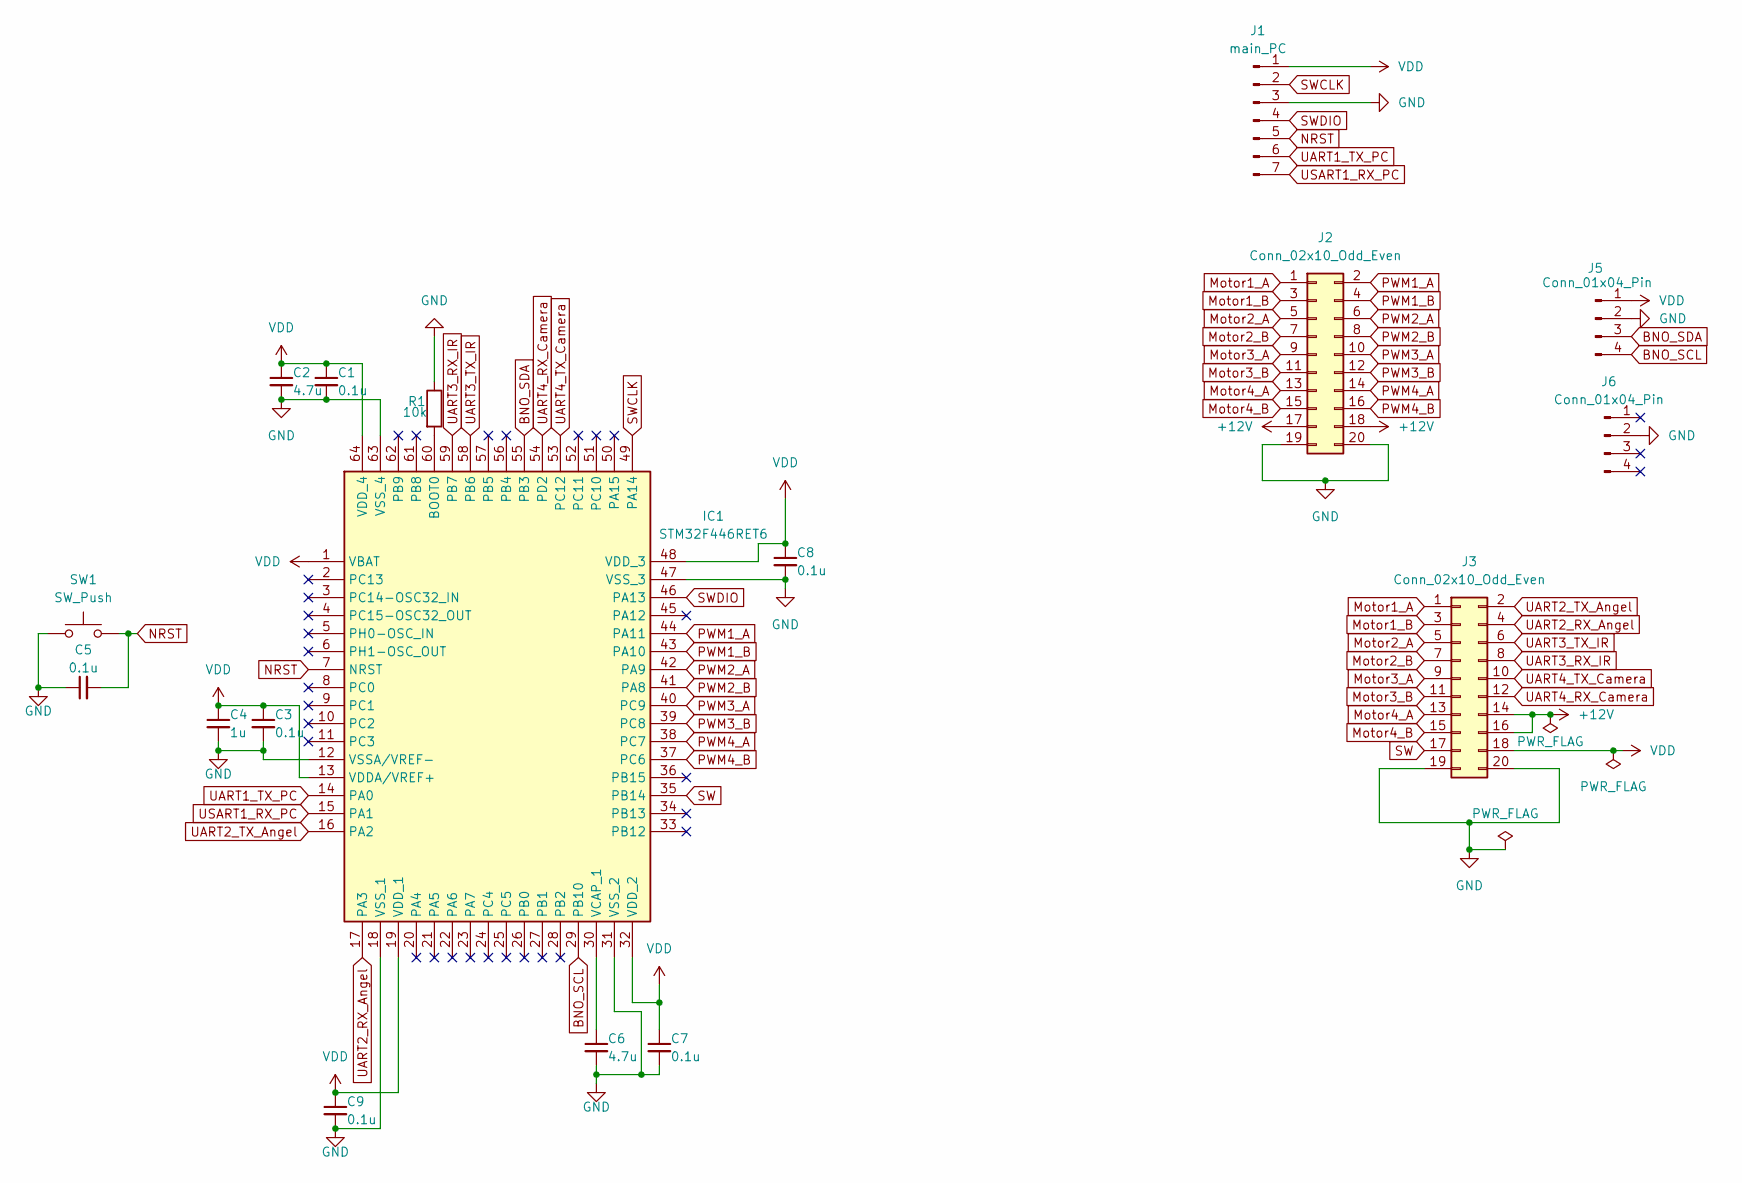
[picture p90: schematic Main board.kicad_sch]

Parts:
C1, C3, C5, C7, C8, C9: 0.1u; C_0603_1608Metric
C2, C6: 4.7u; C_0603_1608Metric
C4: 1u; C_0603_1608Metric
IC1: STM32F446RET6; LQFP-64_10x10mm_P0.5mm; Manufacturer_Part_Number STM32F446RET6; Mouser Part Number 511-STM32F446RET6
J1: main_PC; PinHeader_1x07_P2.54mm_Vertical
J2: Conn_02x10_Odd_Even; PinHeader_2x10_P2.54mm_Vertical
J3: Conn_02x10_Odd_Even; IDC-Header_2x10_P2.54mm_Vertical
J5, J6: Conn_01x04_Pin; PinSocket_1x04_P2.54mm_Vertical
R1: 10k; R_0603_1608Metric
SW1: SW_Push; SKRPABE010

Connections:
+12V: J2.17, J2.18, J3.14, J3.16
BNO_SCL: IC1.29 (PB10), J5.4
BNO_SDA: IC1.55 (PB3), J5.3
GND: C1.2, C2.2, C3.2, C4.2, C5.1, C6.2, C7.2, C8.2, C9.2, IC1.12 (VSSA/VREF-), IC1.18 (VSS_1), IC1.31 (VSS_2), IC1.47 (VSS_3), IC1.63 (VSS_4), J1.3, J2.19, J2.20, J3.19, J3.20, J5.2, J6.2, R1.1, SW1.1
Motor1_A: J2.1, J3.1
Motor1_B: J2.3, J3.3
Motor2_A: J2.5, J3.5
Motor2_B: J2.7, J3.7
Motor3_A: J2.9, J3.9
Motor3_B: J2.11, J3.11
Motor4_A: J2.13, J3.13
Motor4_B: J2.15, J3.15
NRST: C5.2, IC1.7 (NRST), J1.5, SW1.2
unnamed: IC1.60 (BOOT0), R1.2
unnamed: C6.1, IC1.30 (VCAP_1)
PWM1_A: IC1.44 (PA11), J2.2
PWM1_B: IC1.43 (PA10), J2.4
PWM2_A: IC1.42 (PA9), J2.6
PWM2_B: IC1.41 (PA8), J2.8
PWM3_A: IC1.40 (PC9), J2.10
PWM3_B: IC1.39 (PC8), J2.12
PWM4_A: IC1.38 (PC7), J2.14
PWM4_B: IC1.37 (PC6), J2.16
SW: IC1.35 (PB14), J3.17
SWCLK: IC1.49 (PA14), J1.2
SWDIO: IC1.46 (PA13), J1.4
UART1_TX_PC: IC1.14 (PA0), J1.6
UART2_RX_Angel: IC1.17 (PA3), J3.4
UART2_TX_Angel: IC1.16 (PA2), J3.2
UART3_RX_IR: IC1.59 (PB7), J3.8
UART3_TX_IR: IC1.58 (PB6), J3.6
UART4_RX_Camera: IC1.54 (PD2), J3.12
UART4_TX_Camera: IC1.53 (PC12), J3.10
USART1_RX_PC: IC1.15 (PA1), J1.7
VDD: C1.1, C2.1, C3.1, C4.1, C7.1, C8.1, C9.1, IC1.1 (VBAT), IC1.13 (VDDA/VREF+), IC1.19 (VDD_1), IC1.32 (VDD_2), IC1.48 (VDD_3), IC1.64 (VDD_4), J1.1, J3.18, J5.1

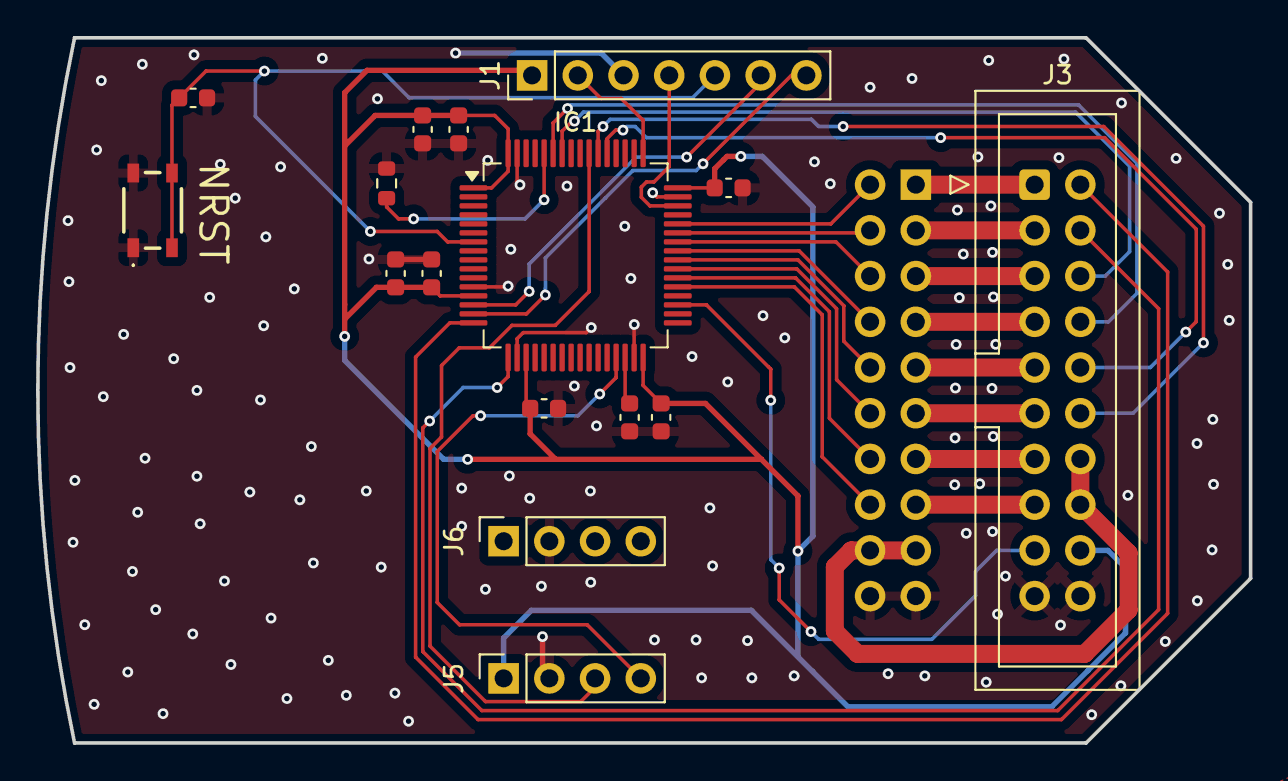
[picture p91: board Main board.kicad_pcb from above]

Board: 2 copper layers, 67.4 x 39.2 mm, 17 parts (1 on the bottom side), 35 nets.
