Soda-DENGIKEN/Ritsumori-cup2026/Substrate/Motor driver board_1.0/Motor driver board_1.0.kicad_pcb

## KiCad design Substrate/Motor driver board_1.0/Motor driver board_1.0.kicad_pcb (2026-04-30)

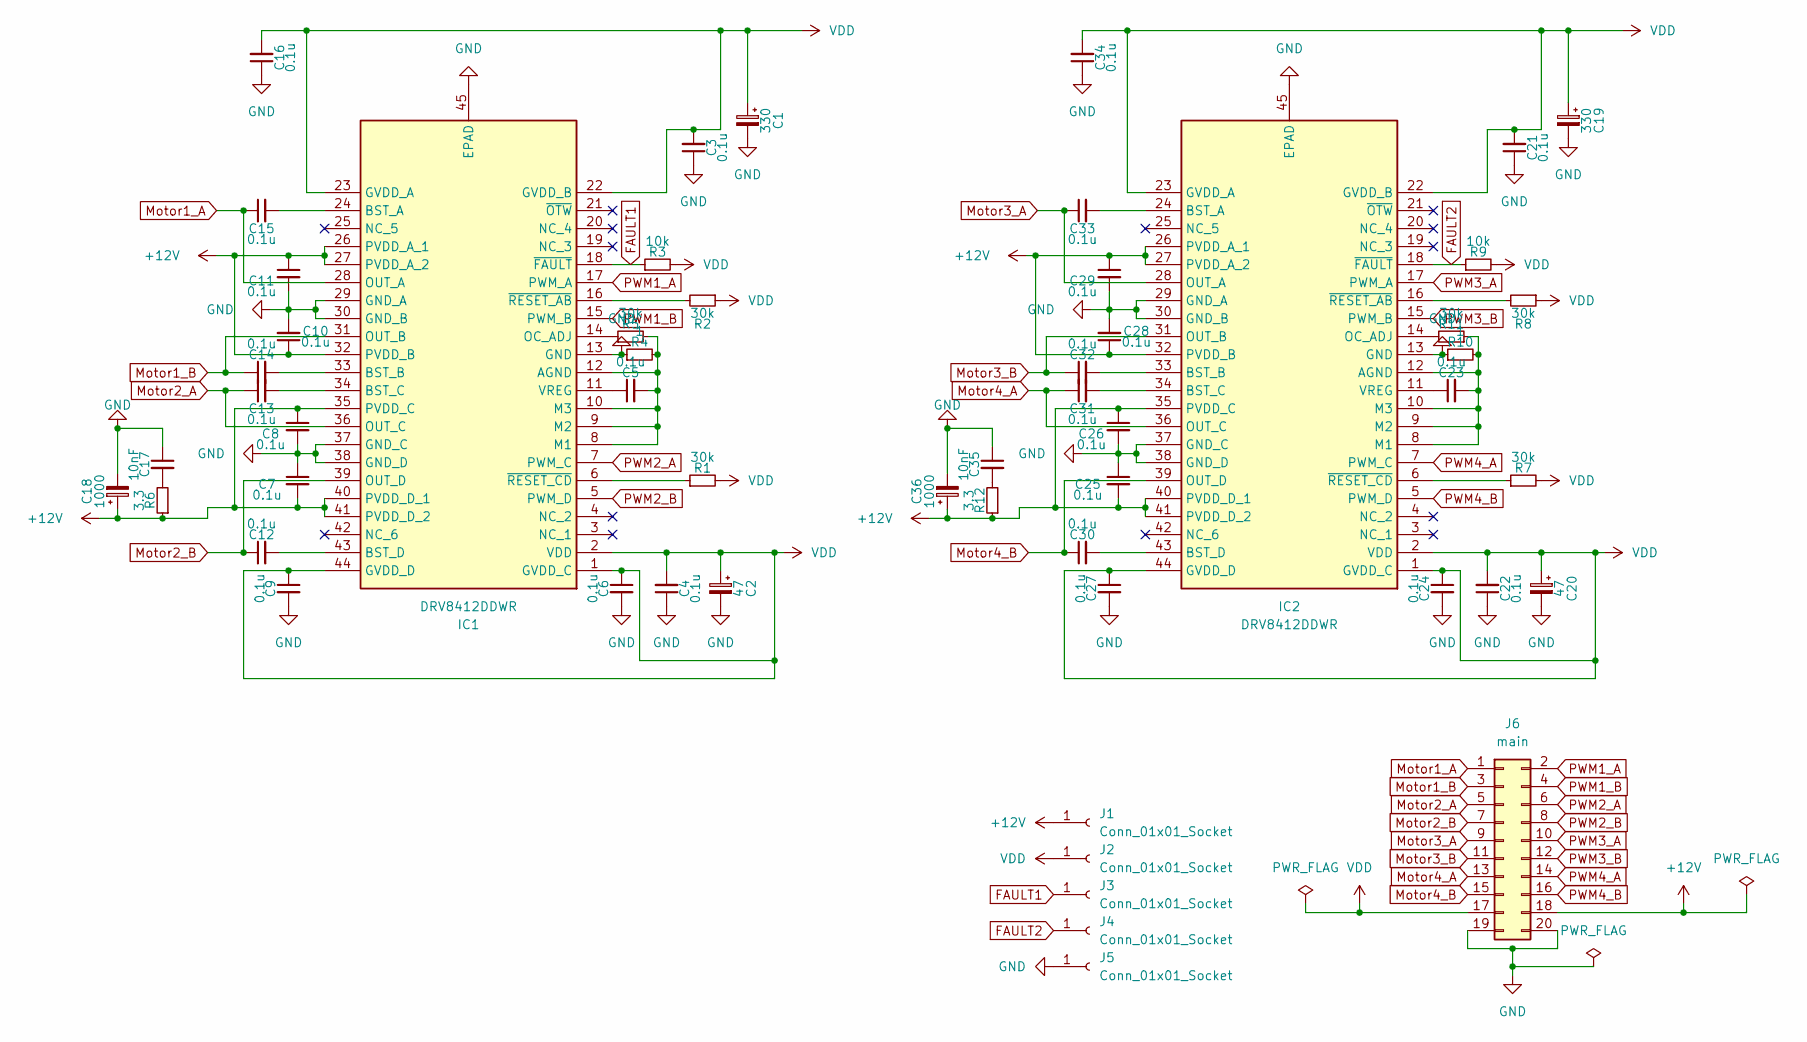
[picture p92: schematic Motor driver board_1.0.kicad_sch]

Parts:
C1, C19: 330; CP_Radial_D10.0mm_P5.00mm
C2, C20: 47; CP_Radial_D6.3mm_P2.50mm
C3, C4, C5, C6, C7, C8, C9, C10, C11, C12, C13, C14, C15, C16, C21, C22, C23, C24, C25, C26, C27, C28, C29, C30, C31, C32, C33, C34: 0.1u; C_0603_1608Metric
C17, C35: 10nF; C_0603_1608Metric
C18, C36: 1000; CP_Radial_D10.0mm_P5.00mm
IC1, IC2: DRV8412DDWR; HTSSOP-44-1EP_6.1x14mm_P0.635mm_EP5.2x14mm_Mask4.31x8.26mm; Manufacturer_Part_Number DRV8412DDWR
J1, J2, J3, J4, J5: Conn_01x01_Socket; TestPoint_Keystone_5000-5004_Miniature
J6: main; PinSocket_2x10_P2.54mm_Vertical
R1, R2, R5, R7, R8, R11: 30k; R_0603_1608Metric
R3, R9: 10k; R_0603_1608Metric
R4, R10: 1; R_0603_1608Metric
R6, R12: 3.3; R_0603_1608Metric

Connections:
+12V: C7.2, C8.1, C10.1, C11.1, C18.1, C25.2, C26.1, C28.1, C29.1, C36.1, IC1.26 (PVDD_A_1), IC1.27 (PVDD_A_2), IC1.32 (PVDD_B), IC1.35 (PVDD_C), IC1.40 (PVDD_D_1), IC1.41 (PVDD_D_2), IC2.26 (PVDD_A_1), IC2.27 (PVDD_A_2), IC2.32 (PVDD_B), IC2.35 (PVDD_C), IC2.40 (PVDD_D_1), IC2.41 (PVDD_D_2), J1.1, J6.18, R6.1, R12.1; also elsewhere on the board
FAULT1: IC1.18 (~FAULT), J3.1, R3.1; also elsewhere on the board
FAULT2: IC2.18 (~FAULT), J4.1, R9.1; also elsewhere on the board
GND: C1.2, C2.2, C3.1, C4.1, C6.2, C7.1, C8.2, C9.2, C10.2, C11.2, C16.1, C17.1, C18.2, C19.2, C20.2, C21.1, C22.1, C24.2, C25.1, C26.2, C27.2, C28.2, C29.2, C34.1, C35.1, C36.2, IC1.13 (GND), IC1.29 (GND_A), IC1.30 (GND_B), IC1.37 (GND_C), IC1.38 (GND_D), IC1.45 (EPAD), IC2.13 (GND), IC2.29 (GND_A), IC2.30 (GND_B), IC2.37 (GND_C), IC2.38 (GND_D), IC2.45 (EPAD), J5.1, J6.19, J6.20, R4.1, R10.1; also elsewhere on the board
Motor1_A: C15.1, IC1.28 (OUT_A), J6.1
Motor1_B: C14.1, IC1.31 (OUT_B), J6.3
Motor2_A: C13.1, IC1.36 (OUT_C), J6.5
Motor2_B: C12.1, IC1.39 (OUT_D), J6.7
Motor3_A: C33.1, IC2.28 (OUT_A), J6.9
Motor3_B: C32.1, IC2.31 (OUT_B), J6.11
Motor4_A: C31.1, IC2.36 (OUT_C), J6.13
Motor4_B: C30.1, IC2.39 (OUT_D), J6.15
unnamed: C17.2, R6.2
unnamed: C35.2, R12.2
unnamed: C5.2, IC1.8 (M1), IC1.9 (M2), IC1.10 (M3), IC1.12 (AGND), R4.2, R5.2
unnamed: C15.2, IC1.24 (BST_A)
unnamed: C14.2, IC1.33 (BST_B)
unnamed: C13.2, IC1.34 (BST_C)
unnamed: C12.2, IC1.43 (BST_D)
unnamed: IC1.14 (OC_ADJ), R5.1
unnamed: C5.1, IC1.11 (VREG)
unnamed: IC1.16 (~RESET_AB), R2.2
unnamed: IC1.6 (~RESET_CD), R1.1
unnamed: C23.2, IC2.8 (M1), IC2.9 (M2), IC2.10 (M3), IC2.12 (AGND), R10.2, R11.1
unnamed: C33.2, IC2.24 (BST_A)
unnamed: C32.2, IC2.33 (BST_B)
unnamed: C31.2, IC2.34 (BST_C)
unnamed: C30.2, IC2.43 (BST_D)
unnamed: IC2.14 (OC_ADJ), R11.2
unnamed: C23.1, IC2.11 (VREG)
unnamed: IC2.16 (~RESET_AB), R8.2
unnamed: IC2.6 (~RESET_CD), R7.1
PWM1_A: IC1.17 (PWM_A), J6.2
PWM1_B: IC1.15 (PWM_B), J6.4
PWM2_A: IC1.7 (PWM_C), J6.6
PWM2_B: IC1.5 (PWM_D), J6.8
PWM3_A: IC2.17 (PWM_A), J6.10
PWM3_B: IC2.15 (PWM_B), J6.12
PWM4_A: IC2.7 (PWM_C), J6.14
PWM4_B: IC2.5 (PWM_D), J6.16
VDD: C1.1, C2.1, C3.2, C4.2, C6.1, C9.1, C16.2, C19.1, C20.1, C21.2, C22.2, C24.1, C27.1, C34.2, IC1.1 (GVDD_C), IC1.2 (VDD), IC1.22 (GVDD_B), IC1.23 (GVDD_A), IC1.44 (GVDD_D), IC2.1 (GVDD_C), IC2.2 (VDD), IC2.22 (GVDD_B), IC2.23 (GVDD_A), IC2.44 (GVDD_D), J2.1, J6.17, R1.2, R2.1, R3.2, R7.2, R8.1, R9.2; also elsewhere on the board

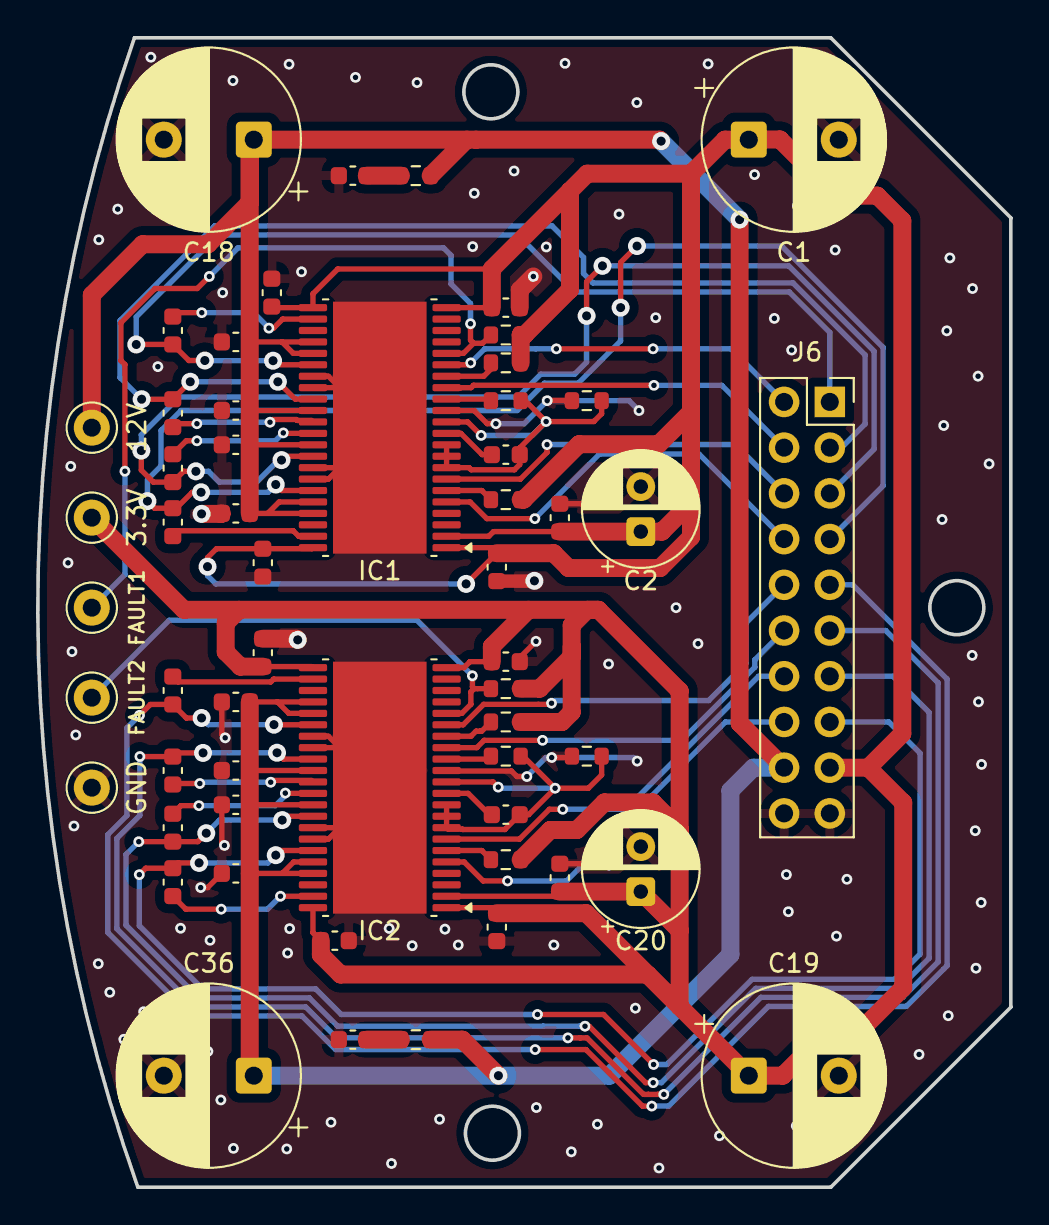
[picture p93: board Motor driver board_1.0.kicad_pcb from above]

Board: 2 copper layers, 54.1 x 63.9 mm, 56 parts (0 on the bottom side), 41 nets.

Other parts of the board:
3.3V, 12V: Conn_01x01_Socket; TestPoint_Keystone_5000-5004_Miniature
FAULT1, FAULT2: Conn_01x01_Socket; TestPoint_Keystone_5000-5004_Miniature
GND: Conn_01x01_Socket; TestPoint_Keystone_5000-5004_Miniature

Their connections:
+12V: 12V.1; also elsewhere on the board
FAULT1: FAULT1.1; also elsewhere on the board
FAULT2: FAULT2.1; also elsewhere on the board
GND: GND.1; also elsewhere on the board
VDD: 3.3V.1; also elsewhere on the board
