Soda-DENGIKEN/Ritsumori-cup2026/Substrate/power board_1.0/power board_1.0.kicad_pcb

## KiCad design Substrate/power board_1.0/power board_1.0.kicad_pcb (2026-04-27)

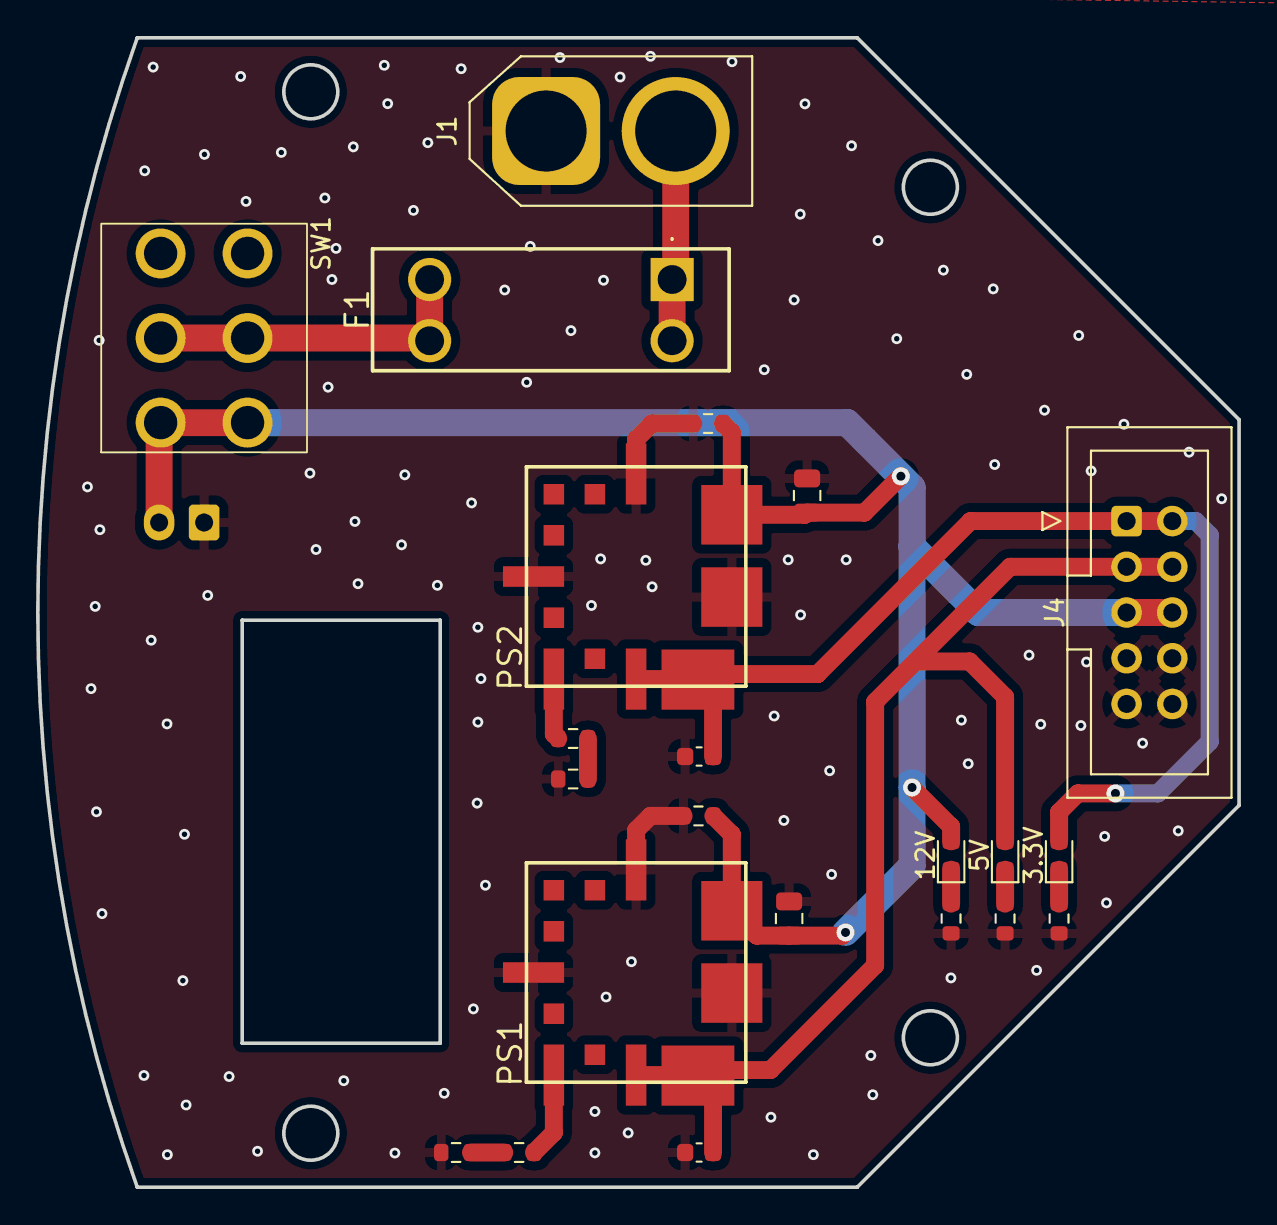
[picture p97: board power board_1.0.kicad_pcb from above]

Board: 2 copper layers, 66.7 x 63.9 mm, 23 parts (1 on the bottom side), 13 nets.

Parts:
3.3V, 5V, 12V: LED; LED_0603_1608Metric
C1, C3: 22u; C_0805_2012Metric
C2, C4: 10u; C_0603_1608Metric
F1: Fuse; 355715
J1: Conn_01x02_Socket; AMASS_XT60-M_1x02_P7.20mm_Vertical
J2: 電圧計; JST_XH_B2B-XH-A_1x02_P2.50mm_Vertical
J4: Conn_02x05_Counter_Clockwise; IDC-Header_2x05_P2.54mm_Vertical
PS1, PS2: OKL-T_6-W12N-C; OKLT6W12NC
R1, R9: 680; R_0603_1608Metric
R2: 200; R_0603_1608Metric
R3: 75; R_0603_1608Metric
R4, R7: 20k; R_0603_1608Metric
R5: 1k; R_0603_1608Metric
R6: 330; R_0603_1608Metric
R8: 1.5k; R_0603_1608Metric
SW1: SW_Push_DPDT; Toggle

Connections:
+3.3V: 3.3V.2 (A), C4.1, J4.1, J4.2, PS2.4 (VOUT), PS2.5 (SENSE)
+5V: 5V.2 (A), C2.1, J4.3, J4.4, PS1.4 (VOUT), PS1.5 (SENSE)
+12V: 12V.2 (A), C1.1, C3.1, J2.2, J4.5, J4.6, PS1.2 (VIN), PS2.2 (VIN), R4.1, R7.1, SW1.1 (A), SW1.4 (A)
GND: C1.2, C2.2, C3.2, C4.2, J1.1, J2.1, J4.7, J4.8, J4.9, J4.10, PS1.1 (ON/OFF_CONTROL), PS1.3 (GROUND_1), PS1.7 (GROUND_2), PS2.1 (ON/OFF_CONTROL), PS2.3 (GROUND_1), PS2.7 (GROUND_2), R1.1, R2.1, R3.1, R4.2, R6.2, R7.2, R9.2
unnamed: 12V.1 (K), R1.2
unnamed: 5V.1 (K), R2.2
unnamed: 3.3V.1 (K), R3.2
unnamed: F1.2, SW1.2 (B), SW1.5 (B)
unnamed: F1.1, J1.2
unnamed: PS1.6 (TRIM), R5.1
unnamed: PS2.6 (TRIM), R8.1
unnamed: R5.2, R6.1
unnamed: R8.2, R9.1
