Soda-DENGIKEN/Ritsumori-cup2026/Substrate/sentral board_1.0/sentral board_1.0.kicad_pcb

## KiCad design Substrate/sentral board_1.0/sentral board_1.0.kicad_pcb (2026-04-27)

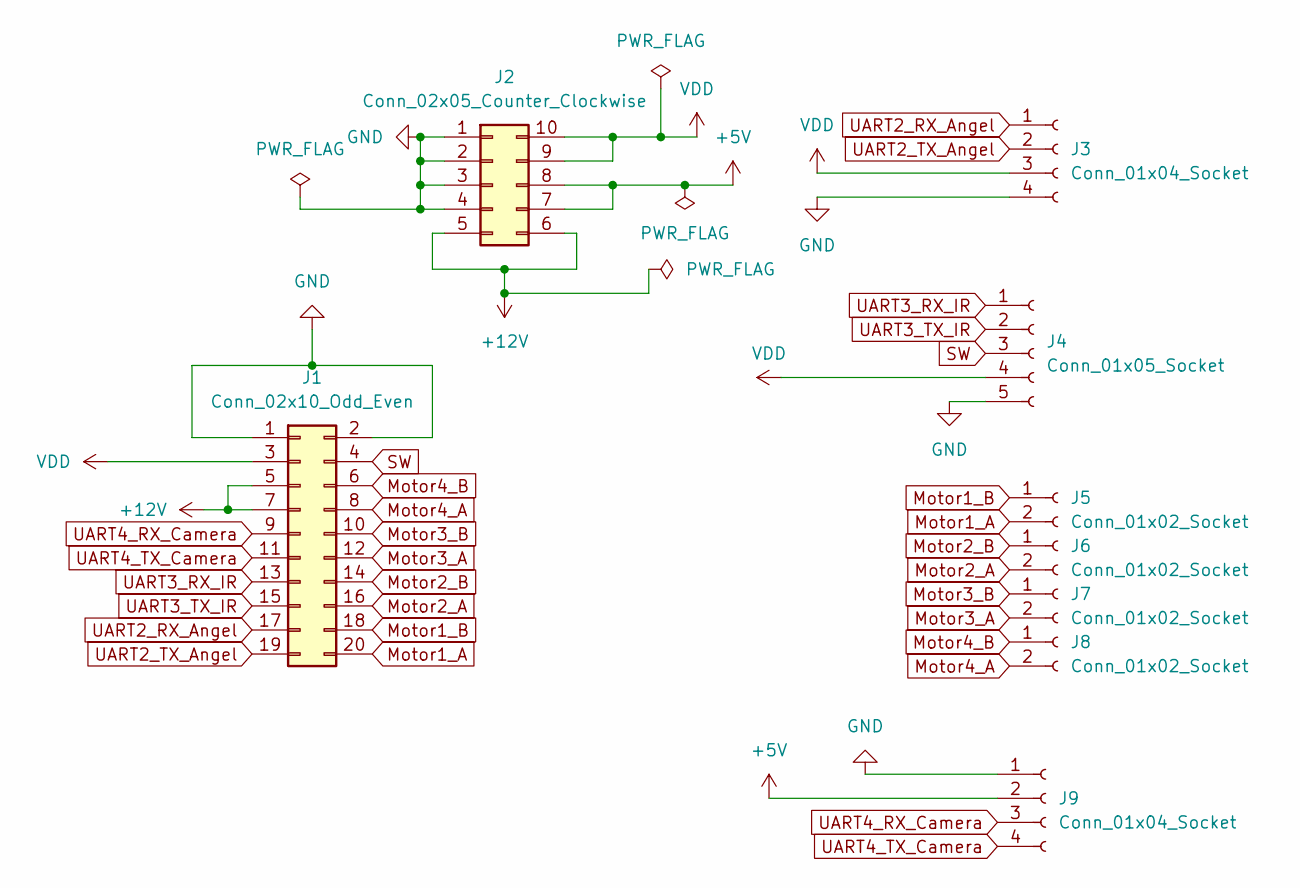
[picture p98: schematic sentral board_1.0.kicad_sch]

Parts:
J1: Conn_02x10_Odd_Even; IDC-Header_2x10_P2.54mm_Vertical
J2: Conn_02x05_Counter_Clockwise; IDC-Header_2x05_P2.54mm_Vertical
J3, J9: Conn_01x04_Socket; JST_XH_B4B-XH-A_1x04_P2.50mm_Vertical
J4: Conn_01x05_Socket; JST_XH_B5B-XH-A_1x05_P2.50mm_Vertical
J5, J6, J7, J8: Conn_01x02_Socket; JST_XH_S2B-XH-A_1x02_P2.50mm_Horizontal

Connections:
+5V: J2.7, J2.8, J9.2
+12V: J1.5, J1.7, J2.5, J2.6
GND: J1.1, J1.2, J2.1, J2.2, J2.3, J2.4, J3.4, J4.5, J9.1
Motor1_A: J1.20, J5.2
Motor1_B: J1.18, J5.1
Motor2_A: J1.16, J6.2
Motor2_B: J1.14, J6.1
Motor3_A: J1.12, J7.2
Motor3_B: J1.10, J7.1
Motor4_A: J1.8, J8.2
Motor4_B: J1.6, J8.1
SW: J1.4, J4.3
UART2_RX_Angel: J1.17, J3.1
UART2_TX_Angel: J1.19, J3.2
UART3_RX_IR: J1.13, J4.1
UART3_TX_IR: J1.15, J4.2
UART4_RX_Camera: J1.9, J9.3
UART4_TX_Camera: J1.11, J9.4
VDD: J1.3, J2.9, J2.10, J3.3, J4.4

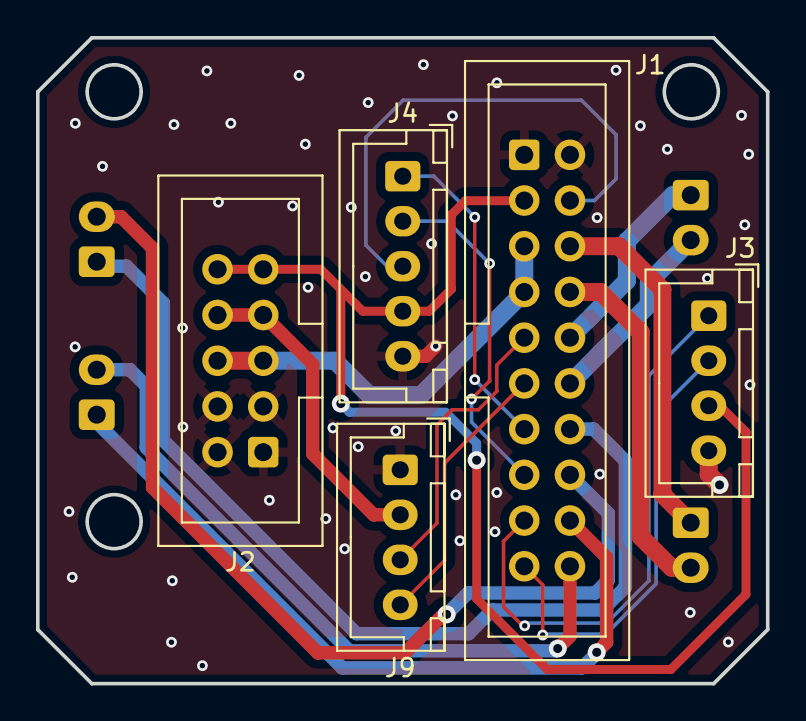
[picture p99: board sentral board_1.0.kicad_pcb from above]

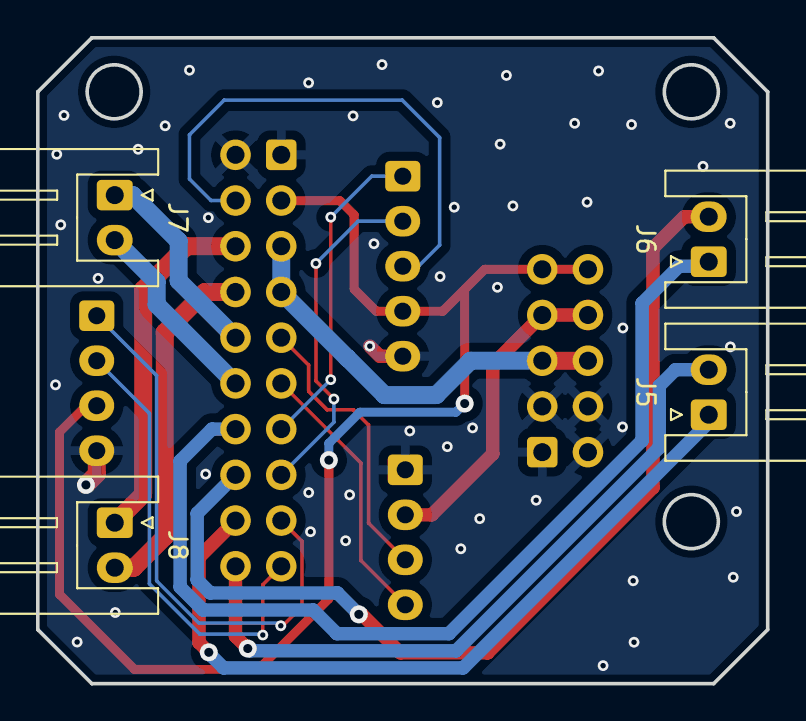
[picture p100: board sentral board_1.0.kicad_pcb from below]

Board: 2 copper layers, 40.6 x 35.9 mm, 9 parts (4 on the bottom side), 19 nets.
