Soda-DENGIKEN/Ritsumori-cup2026/software/defence_program/0806defence/Core/Src/main.c

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
/* Includes ------------------------------------------------------------------*/
#include "main.h"

/* USER CODE BEGIN Includes */
#include <stdio.h>  // 💡 これが不足していたため snprintf でフリーズしていました
#include <math.h>
#include <string.h>
#include <stdlib.h>
#include "motor.h"
#include "sensor.h"
#include "defense.h"
/* USER CODE END Includes */

I2C_HandleTypeDef hi2c2;

TIM_HandleTypeDef htim1;
TIM_HandleTypeDef htim8;

UART_HandleTypeDef huart4;
UART_HandleTypeDef huart5;
UART_HandleTypeDef huart1;
UART_HandleTypeDef huart2;

/* USER CODE BEGIN PV */
uint8_t sw_running = 0; // 0:停止(デバッグ出力あり), 1:動作中(デバッグ出力なし)
static uint8_t sw_prev    = 0;

//volatile uint8_t  line_detected_count = 0;

// センサーファイル(sensor.c)から参照する外部変数
extern volatile uint8_t  line_calib_state;
extern volatile float    ball_angle;
extern volatile float    ball_strength;
extern volatile uint8_t  line_on_line;
extern volatile float    line_angle;
extern volatile uint16_t line_sensor_bits;
extern volatile uint8_t  goal_blue_detected;
extern volatile float    goal_blue_angle;
extern volatile uint8_t  goal_yellow_detected;
extern volatile float    goal_yellow_angle;

extern volatile uint8_t  line_cluster_count;
extern volatile float    line_cluster_angle[2];
extern volatile uint8_t  line_cluster_side[2];

extern volatile float    line_primary_angle;
extern volatile uint8_t  line_is_transitioning;
extern volatile uint8_t  line_was_transitioning;  // 💡追加：sticky版
extern volatile uint16_t line_packet_count;       // 💡追加：100ms間の実パケット受信数
/* USER CODE END PV */

void SystemClock_Config(void);
static void MX_GPIO_Init(void);
static void MX_TIM1_Init(void);
static void MX_TIM8_Init(void);
static void MX_UART4_Init(void);
static void MX_USART1_UART_Init(void);
static void MX_I2C2_Init(void);
static void MX_UART5_Init(void);
static void MX_USART2_UART_Init(void);
/* USER CODE BEGIN PFP */
void BNO055_Init(void);
void Sensor_InitYawOffset(void);
void Sensor_Update(void);
float Sensor_GetOmega(float goal_angle, uint8_t goal_detected);
void Defense_Update(float omega);
void Omni_Drive(float angle, float speed, float omega);
float BNO055_GetYaw(void);
void Sensor_ResetYawOnly(void);
void Sensor_ResumeLineRx(void);
/* USER CODE END PFP */

/**
  * @brief  The application entry point.
  * @retval int
  */
int main(void)
{

  /* MCU Configuration--------------------------------------------------------*/

  /* Reset of all peripherals, Initializes the Flash interface and the Systick. */
  HAL_Init();

  /* Configure the system clock */
  SystemClock_Config();

  /* Initialize all configured peripherals */
  MX_GPIO_Init();
  MX_TIM1_Init();
  MX_TIM8_Init();
  MX_UART4_Init();
  MX_USART1_UART_Init();
  MX_I2C2_Init();
  MX_UART5_Init();
  MX_USART2_UART_Init();
  /* USER CODE BEGIN 2 */
    HAL_TIM_PWM_Start(&htim1, TIM_CHANNEL_1);
    HAL_TIM_PWM_Start(&htim1, TIM_CHANNEL_2);
    HAL_TIM_PWM_Start(&htim1, TIM_CHANNEL_3);
    HAL_TIM_PWM_Start(&htim1, TIM_CHANNEL_4);
    HAL_TIM_PWM_Start(&htim8, TIM_CHANNEL_1);
    HAL_TIM_PWM_Start(&htim8, TIM_CHANNEL_2);
    HAL_TIM_PWM_Start(&htim8, TIM_CHANNEL_3);
    HAL_TIM_PWM_Start(&htim8, TIM_CHANNEL_4);

    BNO055_Init();
    Sensor_InitYawOffset();

    // 起動時にボタン(PB14)が押されていたら自動調整を開始
    if (HAL_GPIO_ReadPin(GPIOB, GPIO_PIN_14) == GPIO_PIN_SET)
    {
        HAL_UART_Transmit(&huart4, (uint8_t*)">> STARTING MULTI-CALIBRATION <<\r\n", 35, 100);

        uint32_t last_log = 0;
        uint32_t sync_timeout = 0;

        // フェーズ1：黒面サンプリング
        HAL_UART_Transmit(&huart4, (uint8_t*)"[PHASE 1] Sampling BLACK... Keep on Black Floor.\r\n", 50, 100);
        HAL_UART_Transmit(&huart2, (uint8_t*)"CALIB AUTO BLACK\n", 17, 10);

        sync_timeout = HAL_GetTick();
        while (line_calib_state != 1)
        {
            Sensor_Update();
            if (HAL_GetTick() - sync_timeout > 1000) {
                HAL_UART_Transmit(&huart2, (uint8_t*)"CALIB AUTO BLACK\n", 17, 10);
                Sensor_ResumeLineRx();
                sync_timeout = HAL_GetTick();
            }
            HAL_Delay(5);
        }

        last_log = 0;
        while (line_calib_state == 1 || line_calib_state == 0)
        {
            Omni_Drive(0.0f, 0.0f, 0.0f);
            Sensor_ResetYawOnly();
            Sensor_Update();

            uint32_t current_time = HAL_GetTick();
            if (current_time - last_log > 500) {
                last_log = current_time;
                char lmsg[128];
                snprintf(lmsg, sizeof(lmsg), "... Line Sensor Sampling BLACK (State: %d) ...\r\n", line_calib_state);
                HAL_UART_Transmit(&huart4, (uint8_t*)lmsg, strlen(lmsg), 100);
            }
            HAL_Delay(5);
        }

        // フェーズ2：移動猶予（ロボットを白線へ）
        HAL_UART_Transmit(&huart4, (uint8_t*)"[PHASE 2] BLACK Done! -> MOVE TO WHITE LINE NOW.\r\n", 50, 100);
        HAL_UART_Transmit(&huart4, (uint8_t*)"👉 Press Button AGAIN when robot is on White Line! 👈\r\n", 57, 100);

        HAL_Delay(300);
        while (HAL_GPIO_ReadPin(GPIOB, GPIO_PIN_14) == GPIO_PIN_SET) {
            Sensor_Update();
            HAL_Delay(10);
        }

        last_log = 0;
        uint8_t white_triggered = 0;

        while (line_calib_state == 2)
        {
            Omni_Drive(0.0f, 0.0f, 0.0f);
            Sensor_Update();

            uint32_t current_time = HAL_GetTick();

            if (HAL_GPIO_ReadPin(GPIOB, GPIO_PIN_14) == GPIO_PIN_SET && !white_triggered)
            {
                HAL_Delay(50);
                if (HAL_GPIO_ReadPin(GPIOB, GPIO_PIN_14) == GPIO_PIN_SET)
                {
                    HAL_UART_Transmit(&huart2, (uint8_t*)"CALIB AUTO WHITE\n", 17, 10);
                    HAL_UART_Transmit(&huart4, (uint8_t*)"[MAIN] Sent CALIB AUTO WHITE! Waiting for Link...\r\n", 51, 100);
                    white_triggered = 1;

                    sync_timeout = HAL_GetTick();
                    while (line_calib_state != 3)
                    {
                        Sensor_Update();
                        if (HAL_GetTick() - sync_timeout > 1000) {
                            HAL_UART_Transmit(&huart2, (uint8_t*)"CALIB AUTO WHITE\n", 17, 10);
                            Sensor_ResumeLineRx();
                            sync_timeout = HAL_GetTick();
                        }
                        HAL_Delay(5);
                    }
                }
            }

            if (current_time - last_log > 500 && !white_triggered) {
                last_log = current_time;
                char lmsg[128];
                snprintf(lmsg, sizeof(lmsg), "... Waiting WHITE Trigger (State: %d) ...\r\n", line_calib_state);
                HAL_UART_Transmit(&huart4, (uint8_t*)lmsg, strlen(lmsg), 100);
            }
            HAL_Delay(5);
        }

        // フェーズ3：白線サンプリング
        HAL_UART_Transmit(&huart4, (uint8_t*)"[PHASE 3] Sampling WHITE... Keep Robot Still!\r\n", 48, 100);

        last_log = 0;
        while (line_calib_state == 3)
        {
            Omni_Drive(0.0f, 0.0f, 0.0f);
            Sensor_Update();

            uint32_t current_time = HAL_GetTick();
            if (current_time - last_log > 500) {
                last_log = current_time;
                char lmsg[128];
                snprintf(lmsg, sizeof(lmsg), "... Line Sensor Sampling WHITE (State: %d) ...\r\n", line_calib_state);
                HAL_UART_Transmit(&huart4, (uint8_t*)lmsg, strlen(lmsg), 100);
            }
            HAL_Delay(5);
        }

        HAL_UART_Transmit(&huart2, (uint8_t*)"CALIB SAVE\n", 11, 10);
        HAL_Delay(200);

        HAL_UART_Transmit(&huart4, (uint8_t*)">> All Calibrations Successfully Saved! <<\r\n", 44, 100);

        HAL_Delay(500);
        sw_prev = 0;
        sw_running = 0;
    }

    // 受信開始処理とデバッグタイマー初期化
    Sensor_ResumeLineRx();
    uint32_t last_debug_tick = 0;
  /* USER CODE END 2 */

    /* Infinite loop */
      /* USER CODE BEGIN WHILE */
          while (1)
          {
                // 🚨【重要】文字化けノイズによるUARTフリーズを強制解除する処理
                if (__HAL_UART_GET_FLAG(&huart4, UART_FLAG_ORE) != RESET) {
                    __HAL_UART_CLEAR_OREFLAG(&huart4);
                }
                if (__HAL_UART_GET_FLAG(&huart2, UART_FLAG_ORE) != RESET) {
                    __HAL_UART_CLEAR_OREFLAG(&huart2);
                }

                // 1. スイッチのチャタリング防止とモード切替
                uint8_t sw_state = HAL_GPIO_ReadPin(GPIOB, GPIO_PIN_14);
                if (sw_state == GPIO_PIN_SET && sw_prev == GPIO_PIN_RESET)
                {
                    HAL_Delay(50);
                    if (HAL_GPIO_ReadPin(GPIOB, GPIO_PIN_14) == GPIO_PIN_SET)
                    {
                        sw_running = !sw_running;

                        char sw_msg[64];
                        snprintf(sw_msg, sizeof(sw_msg), ">>> MODE CHANGED: %s <<<\r\n", sw_running ? "RUN" : "STOP");
                        HAL_UART_Transmit(&huart4, (uint8_t*)sw_msg, strlen(sw_msg), 100);
                    }
                }
                sw_prev = sw_state;

                // 2. センサー値の更新
                Sensor_Update();

                // 3. 姿勢制御 omega の計算
                // キーパーは常にフィールド正面（起動時のヨー基準）を向き続ける
                float omega = Sensor_GetOmega(0.0f, 1);

                // 4. モーターへの出力命令
                if (sw_running == 1)
                {
                    Defense_Update(omega);
                }
                else
                {
                    Omni_Drive(0.0f, 0.0f, 0.0f);
                }

                // 5. 100ms周期でデバッグ出力を実行（RUN/STOP両方で出す）
                {
                    uint32_t current_tick = HAL_GetTick();
                    if (current_tick - last_debug_tick >= 100)
                    {
                        last_debug_tick = current_tick;
                        char tx_out[256];
                        int len = 0;

                        float gyro_yaw = BNO055_GetYaw();

                        // 💡 IRセンサ表示の整形（非検知時は 0.0 と明示）
                        char ir_ang_str[8];
                        char ir_str_str[8];
                        if (ball_detected) {
                            snprintf(ir_ang_str, sizeof(ir_ang_str), "%6.1f", ball_angle);
                            snprintf(ir_str_str, sizeof(ir_str_str), "%5.1f", ball_strength);
                        } else {
                            snprintf(ir_ang_str, sizeof(ir_ang_str), "   0.0");
                            snprintf(ir_str_str, sizeof(ir_str_str), "  0.0");
                        }

                        char line_ang_str[8];
                        if (line_on_line) {
                            snprintf(line_ang_str, sizeof(line_ang_str), "%6.1f", line_angle);
                        } else {
                            snprintf(line_ang_str, sizeof(line_ang_str), "  NONE");
                        }

                        char line_bits_str[17];
                        for (int i = 0; i < 16; i++) {
                            line_bits_str[i] = (line_sensor_bits & (1u << i)) ? '1' : '0';
                        }
                        line_bits_str[16] = '\0';

                        len += snprintf(tx_out + len, sizeof(tx_out) - len,
                                                                "[%s] IR_Ang:%s | IR_Str:%s | Yaw:%6.1f | Line_Ang:%s | Line:[%s] | Prim:%6.1f Trans:%u TransSticky:%u Pkts:%u\r\n",
                                                                sw_running ? "RUN  " : "STOP ",
                                                                ir_ang_str, ir_str_str, gyro_yaw, line_ang_str, line_bits_str,
                                                                line_primary_angle, line_is_transitioning,
                                                                line_was_transitioning, line_packet_count);

                        HAL_UART_Transmit(&huart4, (uint8_t *)tx_out, len, 100);

                        // 💡【追加】次の100ms区間の計測のためにリセット
                        line_was_transitioning = 0;
                        line_packet_count      = 0;
                    }
                }

                // 💡【重要】センサーICのフリーズを防ぐため、最低限の休憩を挟む
                HAL_Delay(5);
          }
        /* USER CODE END WHILE */

    /* USER CODE BEGIN 3 */
  }
  /* USER CODE END 3 */

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
