Soda-DENGIKEN/Ritsumori-cup2026/software/offense_program/0722mawarikomi/Ataack main.ioc

Mcu.UserName=STM32F446RETx
PA0-WKUP.Signal=UART4_TX
PA1.Signal=UART4_RX
PA10.Signal=S_TIM1_CH3
PA11.Signal=S_TIM1_CH4
PA2.Signal=USART2_TX
PA3.Signal=USART2_RX
PA8.Signal=S_TIM1_CH1
PA9.Signal=S_TIM1_CH2
PB10.Signal=I2C2_SCL
PB14.GPIO_Label=SW1
PB14.Signal=GPIO_Input
PB3.Signal=I2C2_SDA
PB6.Signal=USART1_TX
PB7.Signal=USART1_RX
PC12.Signal=UART5_TX
PC6.Signal=S_TIM8_CH1
PC7.Signal=S_TIM8_CH2
PC8.Signal=S_TIM8_CH3
PC9.Signal=S_TIM8_CH4
PD2.Signal=UART5_RX
