Soda-DENGIKEN/Ritsumori-cup2026/(commit log)

2026-04-30 Auto Backup: 2026/04/30 16:20:54.74
    [power board.step, Angel_Line.dxf, Angel_Line.step, Angel_Line_1.0 (1).kicad_pcb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]
2026-05-01 Auto Backup: 2026/05/01 15:16:02.62
    [power board_1 (2).0-CuBottom.gbr, power board_1 (2).0-CuTop.gbr, power board_1 (2).0-EdgeCuts.gbr, power board_1 (2).0-MaskBottom.gbr, power board_1 (2).0-MaskTop.gbr, power board_1 (2).0-NPTH.drl, power board_1 (2).0-PTH.drl, power board_1 (2).0-SilkBottom.gbr]
2026-05-09 Auto Backup: 2026/05/09 13:41:35.03
    [Subwheel jig.3mf, Subwheel jig①.stl, Subwheel jig②.stl, omni frame 8.3mf, omni frame.3mf, omni frame.stl]
2026-05-09 Auto Backup: 2026/05/09 18:25:44.11
    [washer 56.3mf, washer.stl]
2026-05-26 Auto Backup: 2026/05/26 21:11:23.16
    [omni frame 8.3mf, omni frame.3mf, omni frame.stl, washer 138.3mf, washer 56.3mf, washer.stl]
2026-05-31 Auto Backup: 2026/05/31 18:11:55.32
    [Camera caver②.3mf, Camera caver②.stl, Camera cover①.3mf, Camera cover①.stl]
2026-06-02 Auto Backup: 2026/06/02 17:05:48.36
    [Mirror molding jig.3mf, Mirror molding jig①.stl, Mirror molding jig②.stl]
2026-06-07 Auto Backup: 2026/06/07 21:51:40.26
    [Camera cover①.3mf, Camera cover①.stl, Camera cover③.3mf, Camera cover③.stl, Handle①.3mf, Handle①.stl, Handle②.3mf, Handle②.stl]
2026-06-11 Auto Backup: 2026/06/11 21:55:46.39
    [Angel_Line_1.0.kicad_pcb, Handle②.3mf]
2026-07-06 software内に新フォルダを作成しプロジェクトを追加
2026-08-05 Auto Backup: 2026/08/05 14:23:10
    [0803wraparound Debug.cfg]
2026-08-10 Auto Backup: 2026/08/10 13:12:40
    [0803wraparound Debug.cfg]
2026-08-10 Auto Backup: 2026/08/10 16:36:52
    [0803wraparound Debug.cfg]
